korken89/kicad_libs/pcb_templates/uwb_wb001/antenna.jpg

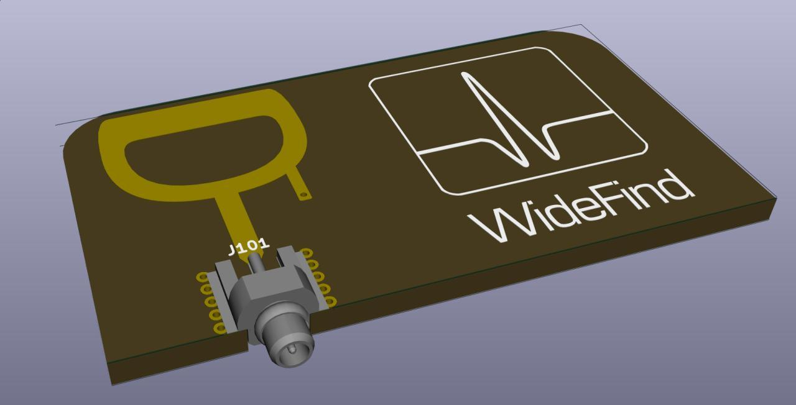
pcb_templates/uwb_wb001/antenna.jpg
