korken89/kicad_libs/pcb_templates/uwb_wb001/doc/Tag_antenna_WB001_v01.pdf

DecaWave Spline based Co-Planar Monopole Antenna

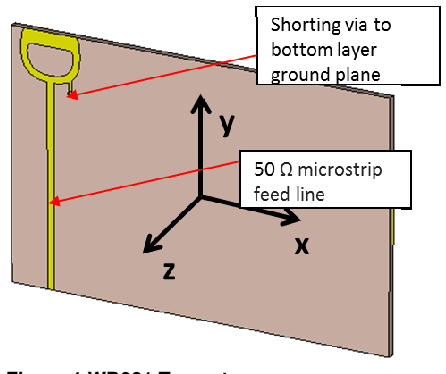
[picture p2: figure]

Confidential | 7th November 2014

## 1 Scope

This document details the performance, construction WB001 tag antenna. The document
information required to integrate this antenna into

## 2 General

The WB001 tag antenna is designed to be integrated specifically to work with DecaWave’s DW10 efficiency compact solution with good efficiency, f orientation. When implemented correctly is should m

Operational Frequ

Maximum Gain: 4dBi at 4GHz 3.7dBi at 6.5 GHz

Radiation Pattern:

## 3 Build Details

The WB001 antenna is designed to be printed on 1.6m
The following files are provided to assist with the integrating this antenna int
File Name | File Type | Description
TAG_Decawave_WB001_top_layer.grb | Gerber | Top layer copper
TAG_Decawave_WB001_btm_layer.grb | Gerber | Bottom layer copper
TAG_Decawave_WB001_top_layer.dxf | DXF | Top layer copper
TAG_Decawave_WB001_btm_layer.dxf | DXF | Bottom layer copper

Either gerber or DXF files can be used.
A shorting via is to be inserted where the circle i
can be trimmed up to the edge of the ground plane. It should be noted that the gro part of the antenna. The more ground plane the bett
between performance and ground plane size and spaci

It is recommended that the PCB manufacturer uses im
line and hence the rest of the antenna design is wi

Figure 1 WB001 Tag antenna

Planar Monopole Antenna

details and design trade-offs for DecaWave’s and its associated gerber/DXF files are intended to provide all the a DW1000 based tag product.

onto a DW1000 based tag design. It is designed

### 00 UWB transceiver providing a low or zero cost, hi

idelity and low group delay variation with antenna eet the following basic goals:

ency Range: 3.5 GHz to 7 GHz

4dBi at 4GHz
3.7dBi at 6.5 GHz

Omni-directional

m FR4 PCB substrate.
ded to assist with the integrating this antenna into your PCB layout:

s located in the layout files. The 50 Ω feeding strip f the ground plane. It should be noted that the ground plane forms er the performance. Section 5 shows the trade ng.

pedance control to ensure that the 50 thin a ±5% tolerance.

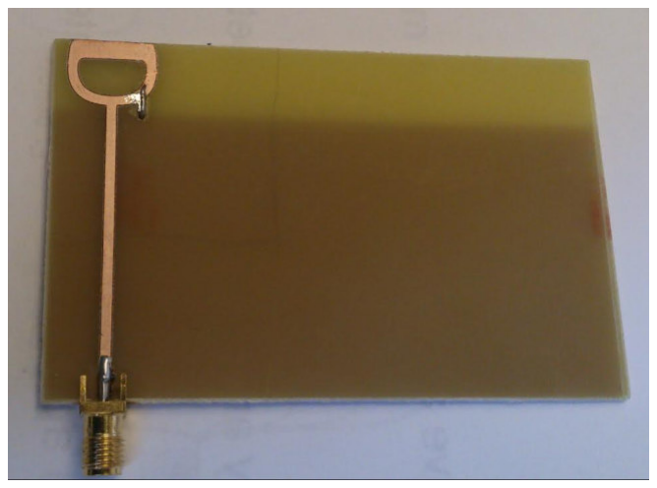
[picture p3: figure]

Page: 1 of 23

gh

Ω feeding strip
und plane forms
shows the trade-off

Ω feed

## 4 Simulation Results

## 4.1 Radiation patterns

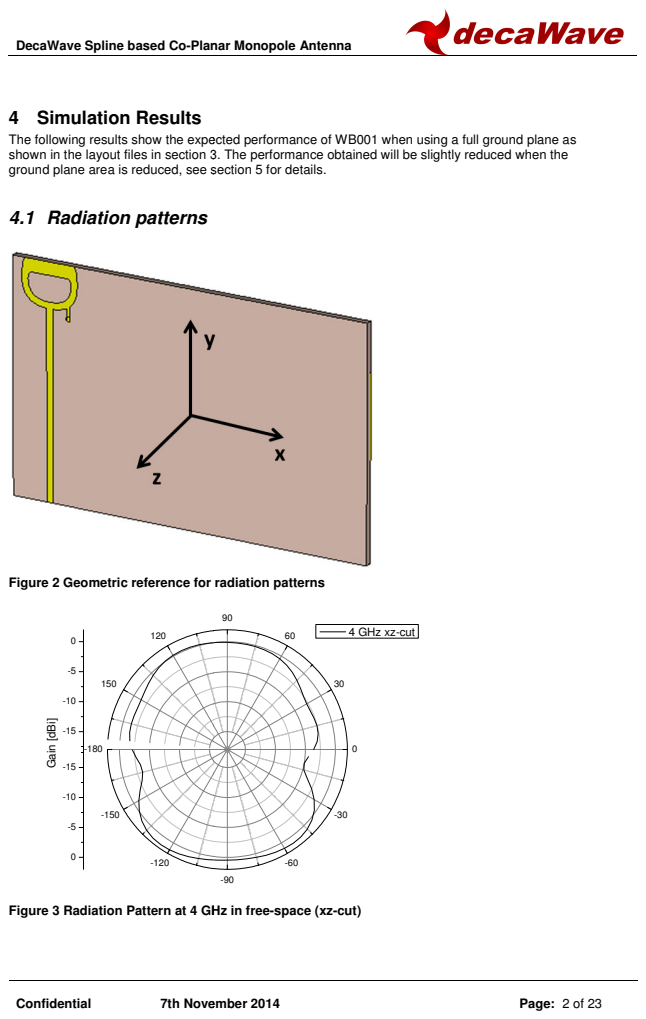
[picture p4: page 2]
Confidential; 7th November 2014; Gain [dBi]; 5 for details.; adiation patterns; Page: 2 of 23; when the

Planar Monopole Antenna

The following results show the expected performance
shown in the layout files in section 3
ground plane area is reduced, see section

of WB001 when using a full ground plane as

. The performance obtained will be slightly reduced

Figure 2 Geometric reference for r

4 GHz xz-cut

Figure 3 Radiation Pattern at 4 GHz in free

-space (xz-cut)

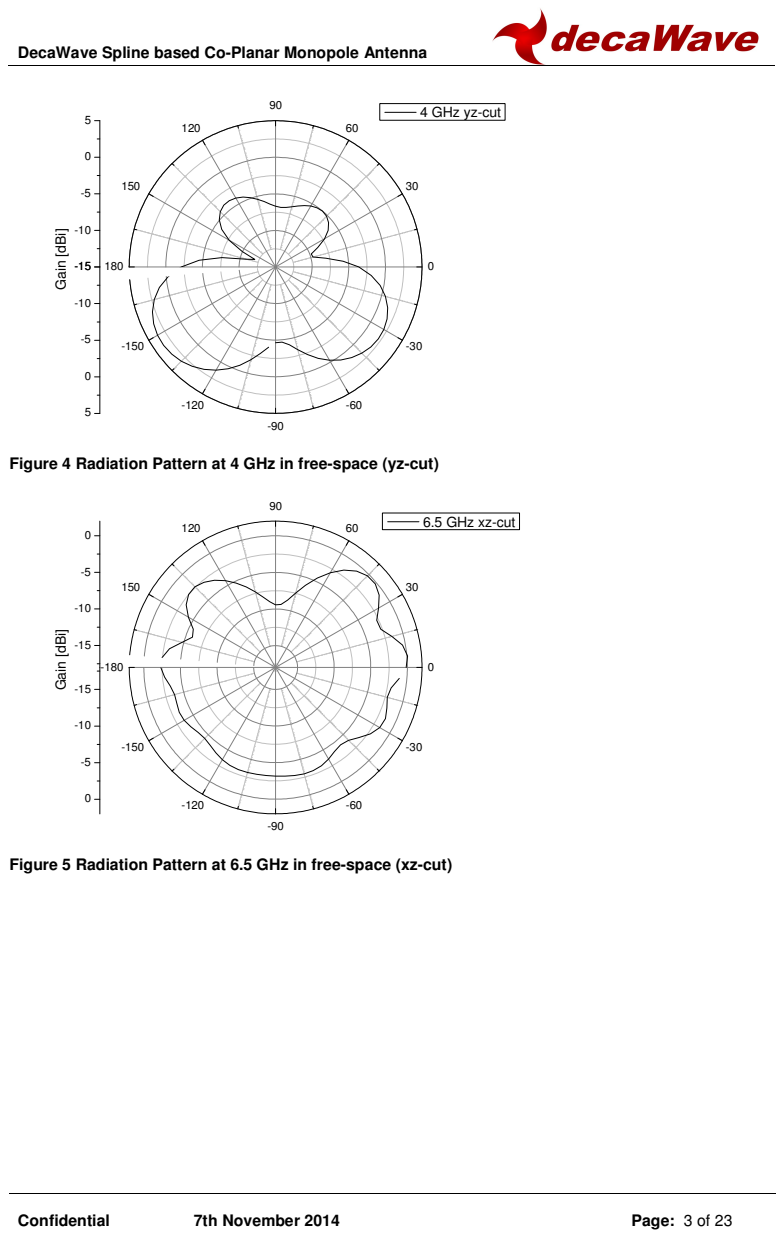
[picture p5: page 3]
Confidential; 7th November 2014; Page: 3 of 23; Gain [dBi]

4 GHz yz-cut

Figure 4 Radiation Pattern at 4 GHz in free-space (yz-cut)

6.5 GHz xz-cut

Figure 5 Radiation Pattern at 6.5 GHz in free-space (xz-cut)

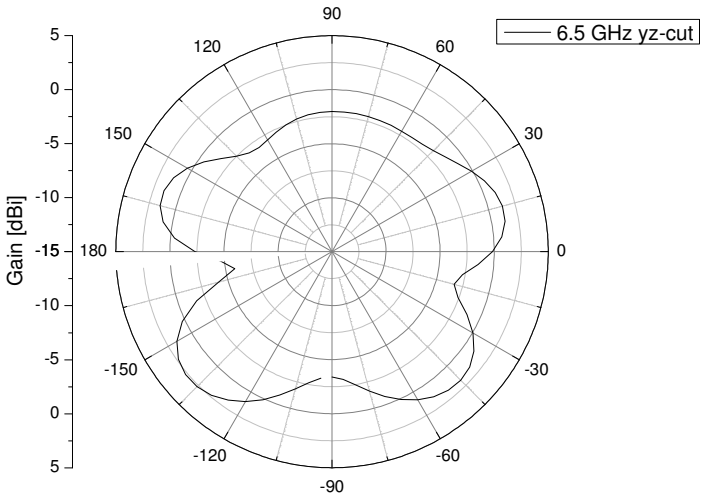
[picture p6: figure]
Gain [dBi]; 6.5 GHz yz-cut
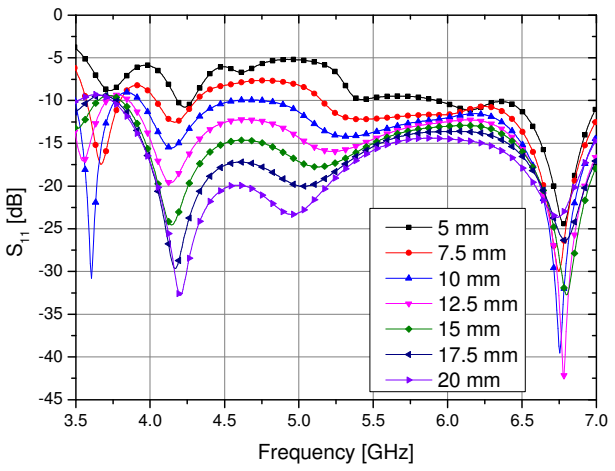
[picture p7: figure]
Frequency [GHz]

Confidential | 7th November 2014 | Page: 4 of 23

Figure 6 Radiation Pattern at 6.5 GHz in free-space (yz-cut)

## 4.2 Impedance Matching

The following plot shows simulated WB001 return loss in proximity to a metal plate. The purpose is this is to show how the return loss and hence general performance degrades when objects (metal plate, body etc) are placed close to the antenna. These results show that generally the WB001 antenna has a good immunity to objects in close proximity but as a rule the antenna should be as far away from tag housings etc as possible.

Figure 7 Impedance matching for different distances from a metal plate (Proximity test)

## 4.3 Efficiency

The following plot shows simulated WB001 efficiency in proximity to a metal plate

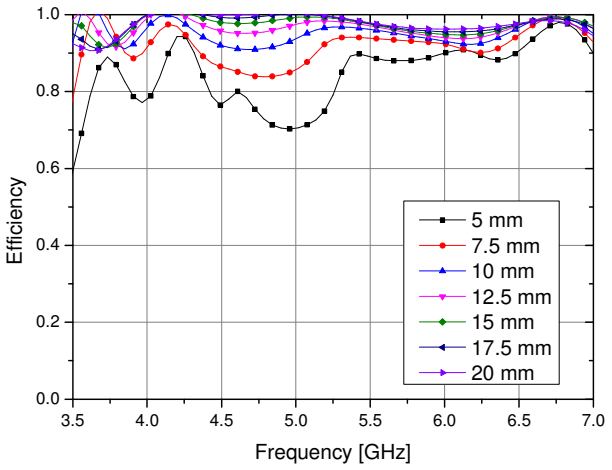
[picture p8: figure]
Efficiency; Frequency [GHz]

Confidential | 7th November 2014 | Page: 5 of 23

Figure 8 Efficiency for different distances from a metallic plate (Proximity test)

## 4.4 Maximum Gain

3.5 | 4.0 | 4.5 | 5.0 | 5.5 | 6.0 | 6.5 | 7.0

-15.0

-12.5

-10.0

-7.5

-5.0

-2.5

0.0

2.5

5.0

Maximum gain [dBi]

Frequency [GHz]

Figure 9 Maximum Gain across frequency

## 4.5 Group Delay Variation

Group delay variation is an important parameter to consider for antennas to be used in location solutions using IR-UWB such as DW1000. Here we mean how the group delay of the antenna changes as the antenna is rotated. 1ns of variation would represent 30cm variation is the reported distance, so we aim for a group delay variation with antenna rotation of <100ps.

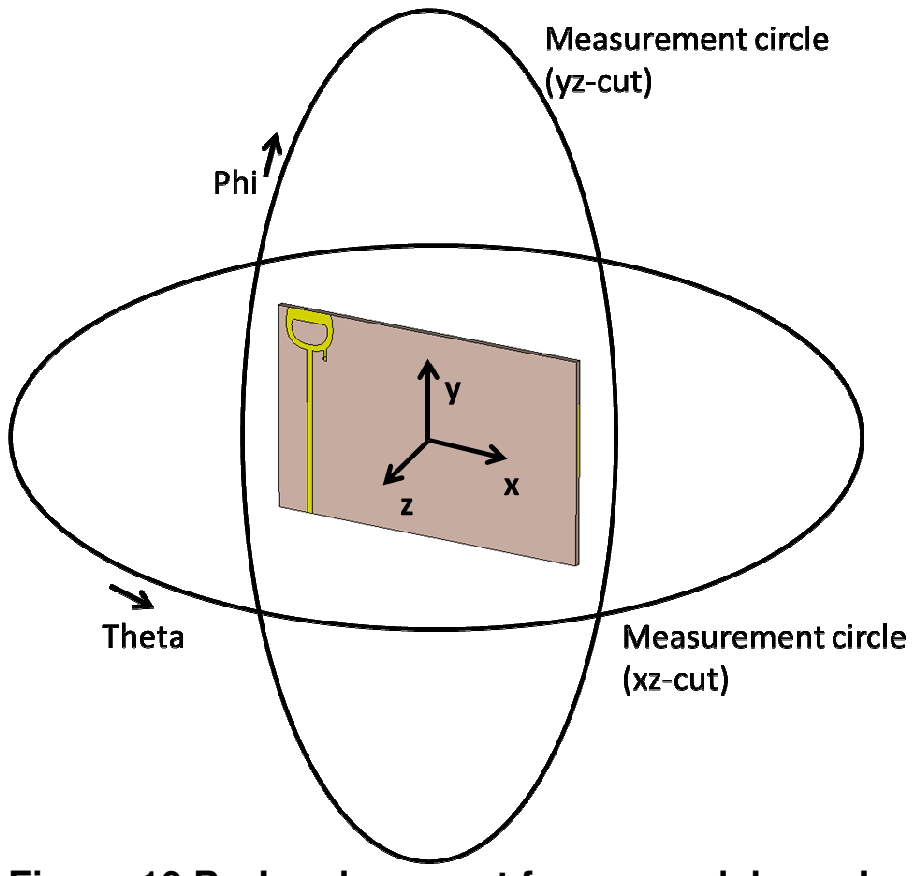
[picture p9: figure]
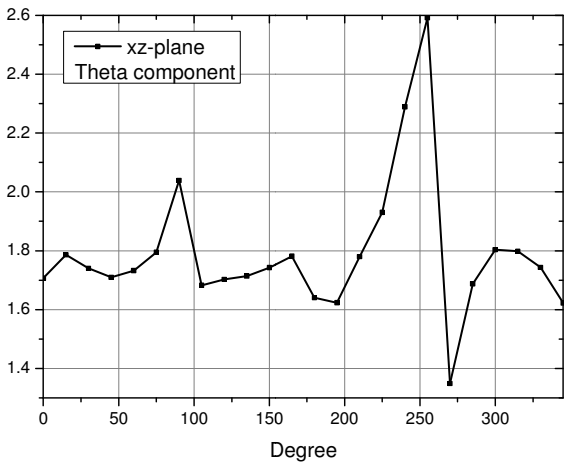
[picture p10: figure]
Degree; xz-plane Theta component

Confidential | 7th November 2014

Figure 10 Probe placement for group delay calculation

Ideal probes placed on the xz- and yz

### 4.5.1 Group Delay Variation at 4GHz

Group delay at 4 GHz [ns]

Planar Monopole Antenna

for group delay calculation

-plane at the distance of 5λ from the centre of the antenna

Page: 6 of 23

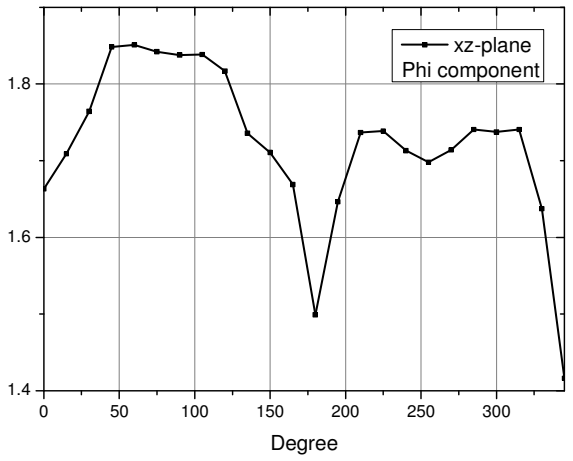
[picture p11: figure]
Degree; xz-plane Phi component
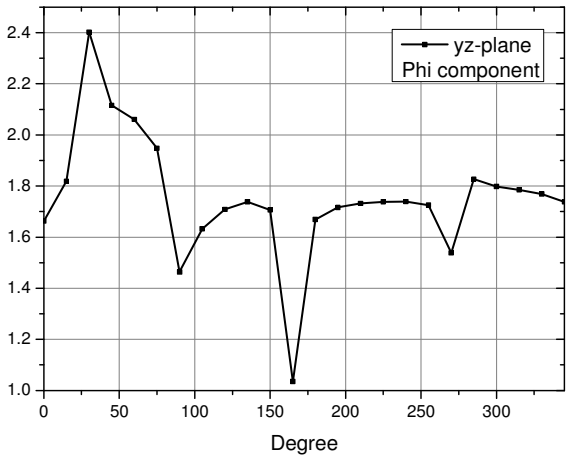
[picture p12: figure]
Degree; yz-plane Phi component
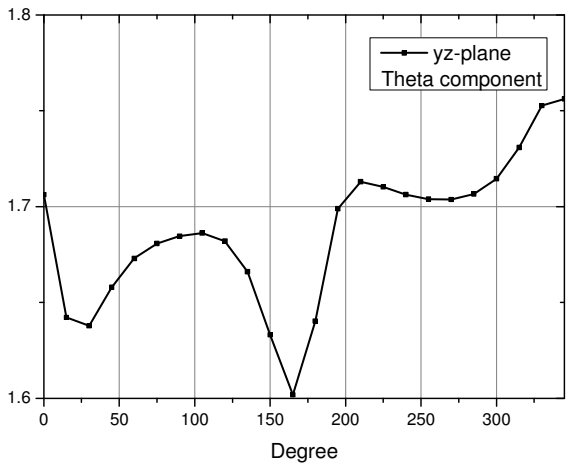
[picture p13: figure]
Degree; yz-plane Theta component

Confidential | 7th November 2014 | Page: 7 of 23

Group delay at 4 GHz [ns]

Group delay at 4 GHz [ns]

Group delay at 4 GHz [ns]

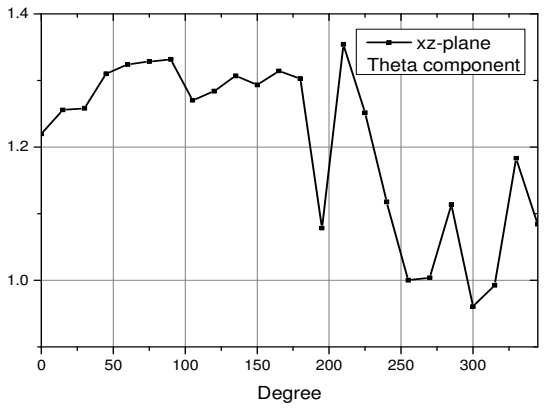
[picture p14: figure]
Degree; xz-plane Theta component
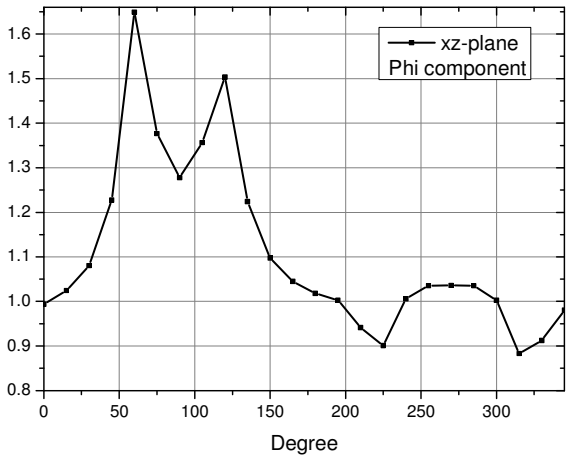
[picture p15: figure]
Degree; xz-plane Phi component
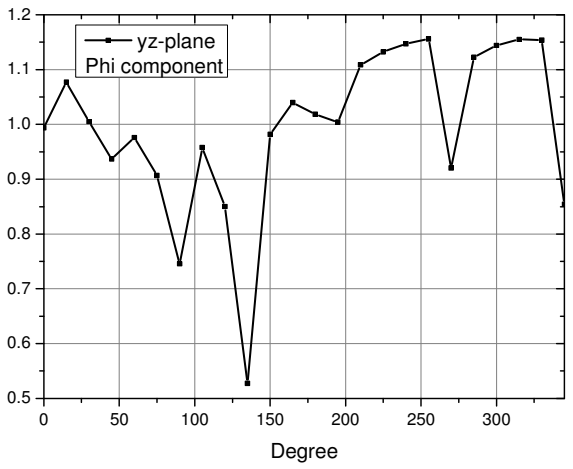
[picture p16: figure]
Degree; yz-plane Phi component

Confidential | 7th November 2014 | Page: 8 of 23

### 4.5.2 Group Delay Variation 6.5 GHz

Group delay at 6.5 GHz [ns]

Group delay at 6.5 GHz [ns]

Group delay at 6.5 GHz [ns]

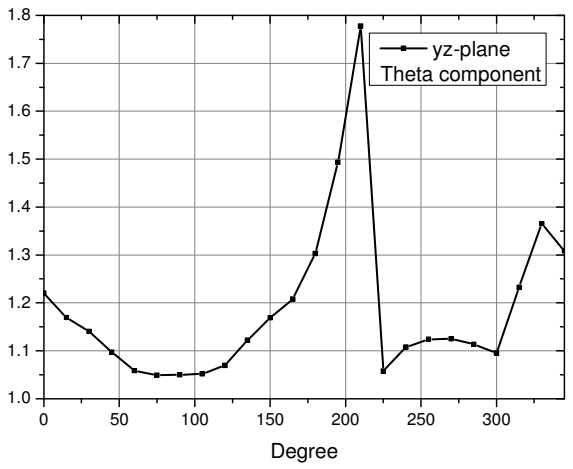
[picture p17: figure]
Degree; yz-plane; Theta component

Confidential | 7th November 2014 | Page: 9 of 23

Group delay at 6.5 GHz [ns]

## 4.6 Fidelity Factor

The following plots show simulated results of the fidelity factor for WB001. They show how well the antenna will perform in the time domain given it is to be used in an IR-UWB system. A figure of 1 is ideal with 0.9 being the target.

### 4.6.1 Fidelity factor 4 GHz

0 | 30 | 60 | 90 | 120 150 180 210 240 270 300 330

0.80

0.85

0.90

0.95

1.00

Fidelity

Angle [degree]

xz-plane
Theta component

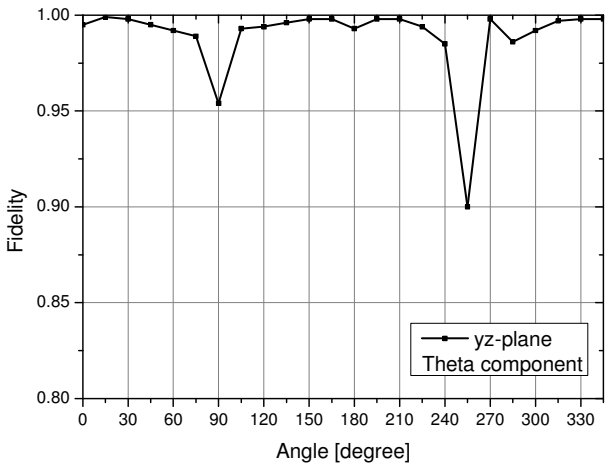
[picture p18: figure]
Fidelity; Angle [degree]; yz-plane Theta component

Confidential | 7th November 2014 | Page: 10 of 23
0 | 30 | 60 | 90 | 120 150 180 210 240 270 300 330

0.80

0.85

0.90

0.95

1.00

Fidelity

Angle [degree]

xz-plane
Phi component
0 | 30 | 60 | 90 | 120 150 180 210 240 270 300 330
0 | 30 | 60 | 90 | 120 150 180 210 240 270 300 330

0.80

0.85

0.90

0.95

1.00

Fidelity

Angle [degree]

yz-plane
Phi component

Confidential | 7th November 2014 | Page: 11 of 23

### 4.6.2 Fidelity factor 6.5 GHz

0 | 30 | 60 | 90 | 120 150 180 210 240 270 300 330

0.80

0.85

0.90

0.95

1.00

Fidelity

Angle [degree]

xz-plane
Theta component
0 | 30 | 60 | 90 | 120 150 180 210 240 270 300 330

0.80

0.85

0.90

0.95

1.00

Fidelity

Angle [degree]

xz-plane
Phi component

Confidential | 7th November 2014 | Page: 12 of 23
0 | 30 | 60 | 90 | 120 150 180 210 240 270 300 330

0.80

0.85

0.90

0.95

1.00

Fidelity

Angle [degree]

yz-plane
Theta component
0 | 30 | 60 | 90 | 120 150 180 210 240 270 300 330

0.80

0.85

0.90

0.95

1.00

Fidelity

Angle [degree]

yz-plane
Phi component

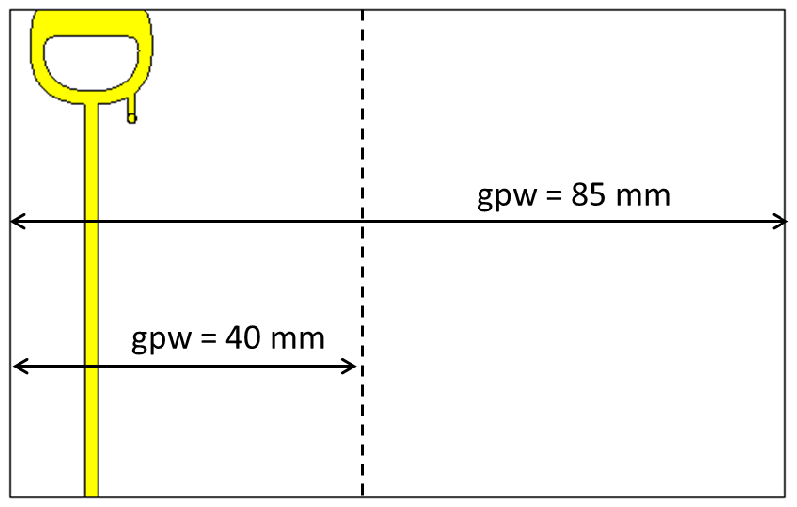
[picture p19: figure]
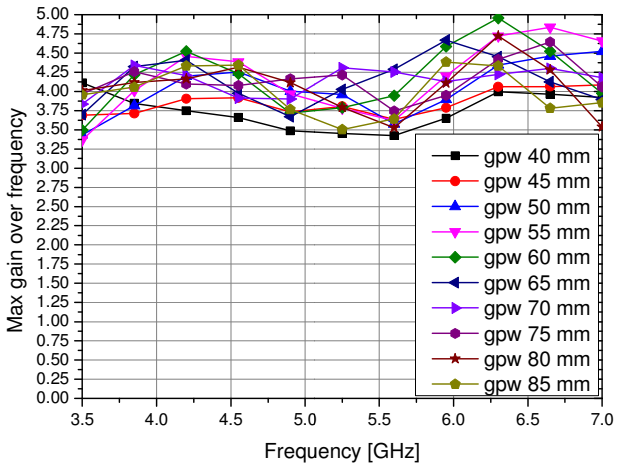
[picture p20: figure]
Max gain over frequency; Frequency [GHz]; gpw 40 mm gpw 45 mm gpw 50 mm gpw 55 mm gpw 60 mm gpw 65 mm gpw 70 mm gpw 75 mm gpw 80 mm gpw 85 mm

Confidential | 7th November 2014

## 5 Performance using less ground plane

In most DW1000 based tag designs, tags are designed
plane for WB001 forms part of the antenna the large
This section details how small the tag can be with regard to how much PCB layout should use as much copper ground fill as

## 5.1 Reducing the Ground Plane Width

In the following plots, the ground plane width given in t effects on antenna gain are plotted.

## 5.2 Reducing the Ground Plane Height

In the following plots the ground plane height give
effects on antenna gain is plotted.

Planar Monopole Antenna

to be as small as possible. As the ground r the ground-plane the better the performance. the tag can be with regard to how much ground plane is required. possible to increase ground plane area.

he supplied gerber/dxf files is reduced and the

n in the supplied gerber/dxf files is reduced and t

Page: 13 of 23

Tag

he

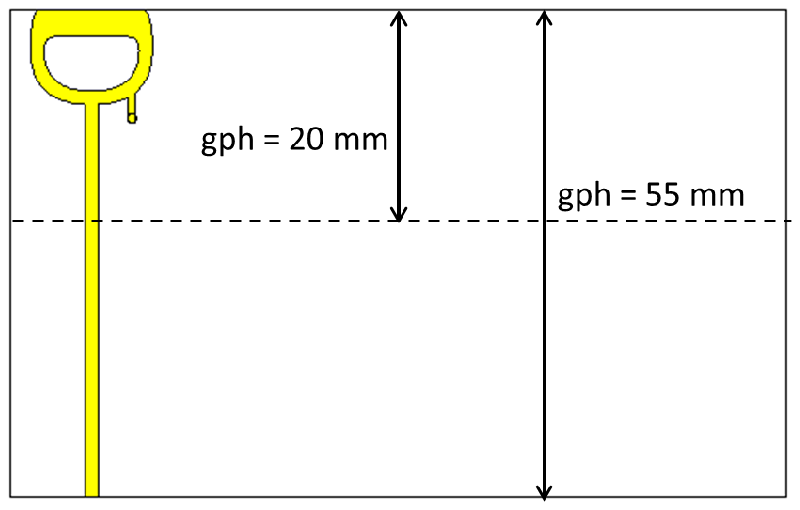
[picture p21: figure]
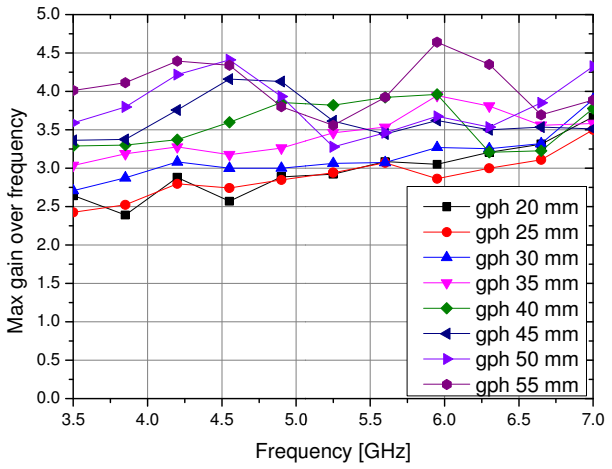
[picture p22: figure]
Max gain over frequency; Frequency [GHz]; gph 20 mm gph 25 mm gph 30 mm gph 35 mm; gph 40 mm gph 45 mm gph 50 mm; gph 55 mm
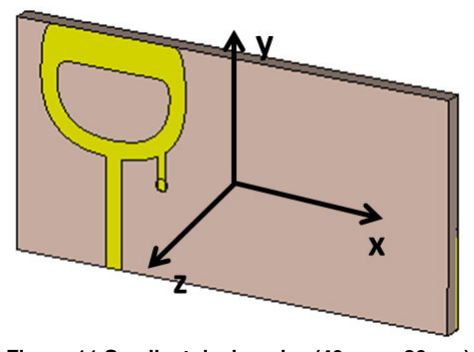
[picture p23: figure]

Confidential | 7th November 2014

## 5.3 Smallest Recommended Design

As stated already, for the best performance the gro practical in most tag designs. This section shows
the effects this reduced size has on antenna perfor

### 5.3.1 Smallest antenna design 40mm x 20mm

Figure 11 Smallest design size (40mm x 20mm)

In Figure 11, the smallest recommended tag size is shown in a

Planar Monopole Antenna

und plane should be large, however this is not This section shows the recommended smallest ground plane size and mance.

(40mm x 20mm)

40mm x-plane, 20mm y

Page: 14 of 23

-plane

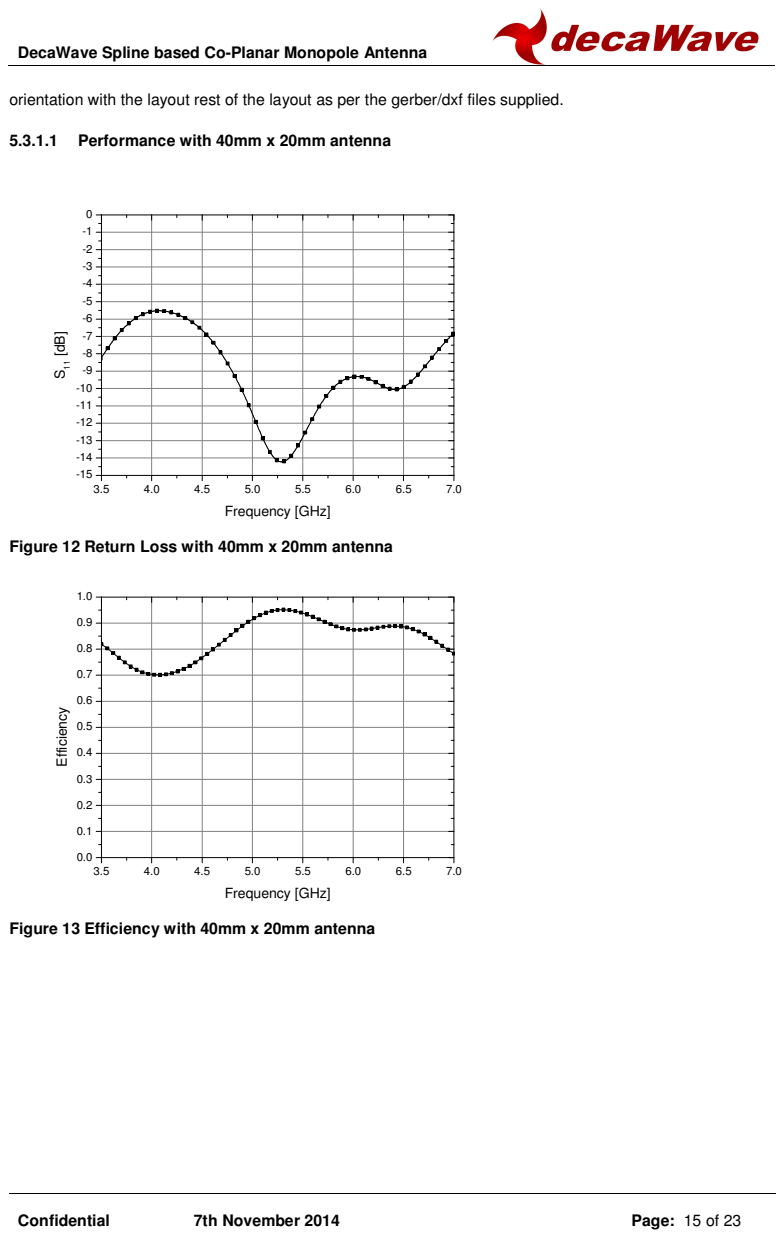
[picture p24: page 15]
Confidential; 7th November 2014; Page: 15 of 23; Frequency [GHz]; Efficiency

orientation with the layout rest of the layout as per the gerber/dxf files supplied.

5.3.1.1 Performance with 40mm x 20mm antenna

Figure 12 Return Loss with 40mm x 20mm antenna

Figure 13 Efficiency with 40mm x 20mm antenna

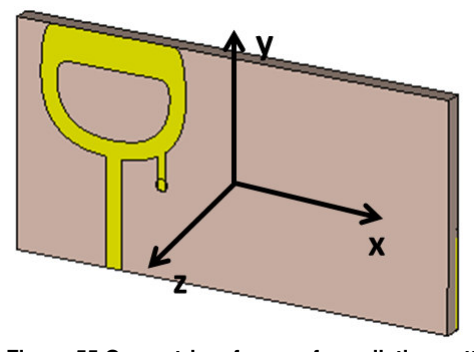
[picture p25: figure]

Confidential | 7th November 2014
3.5 | 4.0 | 4.5 | 5.0

2.0

2.5

3.0

3.5

4.0

4.5

5.0

Max gain over frequency

Frequency [GHz]

Figure 44 Gain with 40mm x 20mm antenna

Figure 55 Geometric reference for radiation patterns

Planar Monopole Antenna

5.5 | 6.0 | 6.5 | 7.0
Frequency [GHz]

with 40mm x 20mm antenna

Page: 16 of 23

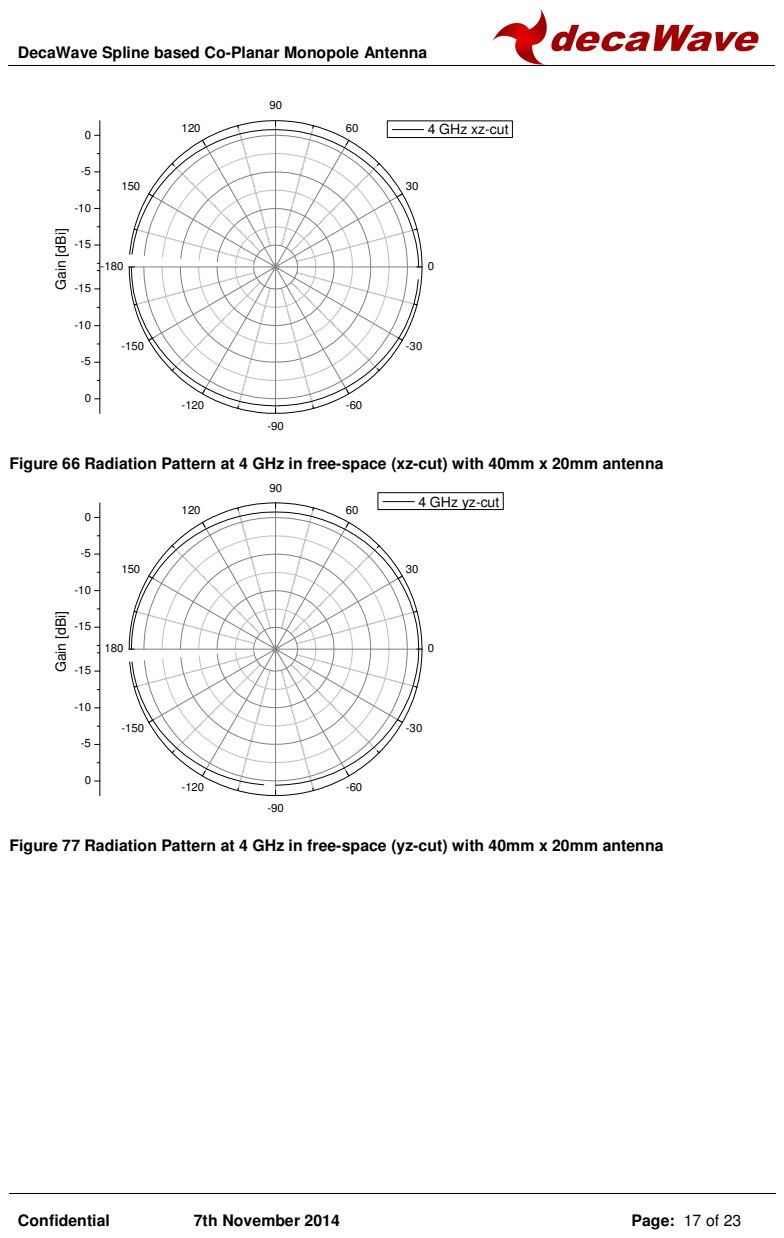
[picture p26: page 17]
Confidential; 7th November 2014; Page: 17 of 23; Gain [dBi]

4 GHz xz-cut

Figure 66 Radiation Pattern at 4 GHz in free-space (xz-cut) with 40mm x 20mm antenna

4 GHz yz-cut

Figure 77 Radiation Pattern at 4 GHz in free-space (yz-cut) with 40mm x 20mm antenna

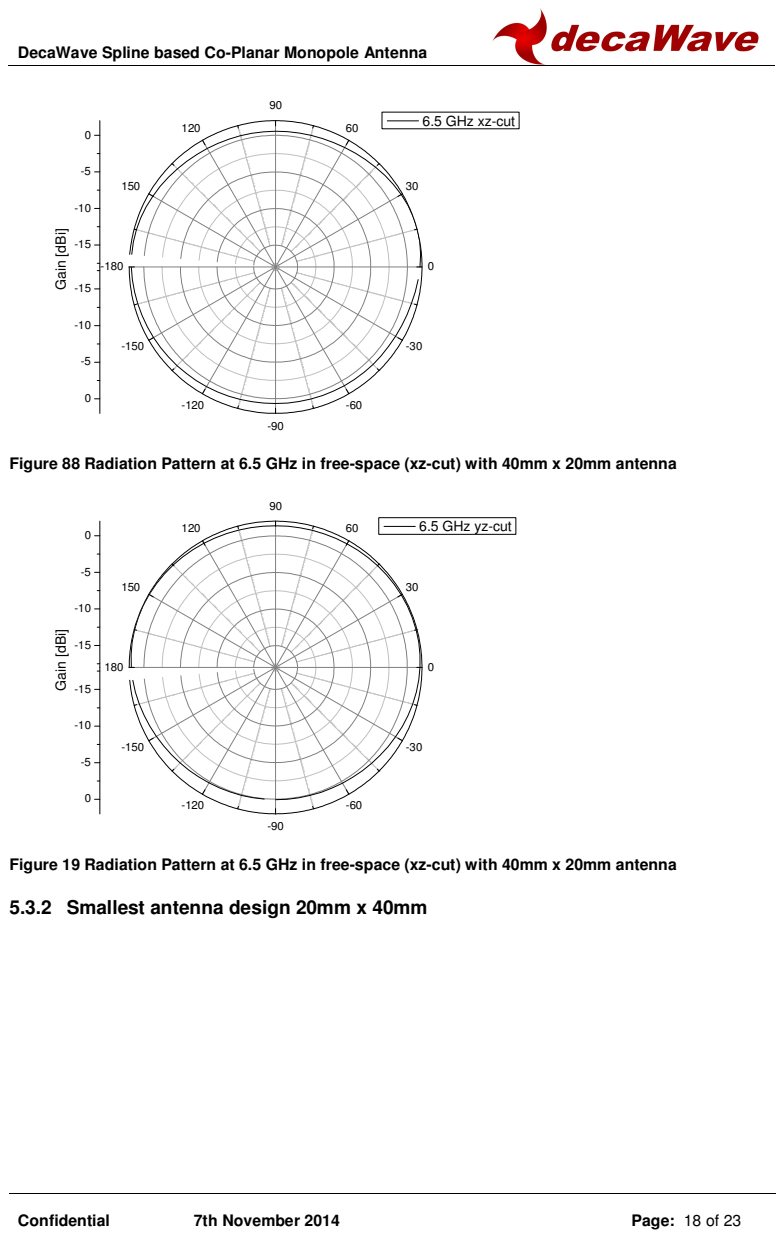
[picture p27: page 18]
Confidential; 7th November 2014; Page: 18 of 23; Gain [dBi]

6.5 GHz xz-cut

Figure 88 Radiation Pattern at 6.5 GHz in free-space (xz-cut) with 40mm x 20mm antenna

6.5 GHz yz-cut

Figure 19 Radiation Pattern at 6.5 GHz in free-space (xz-cut) with 40mm x 20mm antenna

5.3.2 Smallest antenna design 20mm x 40mm

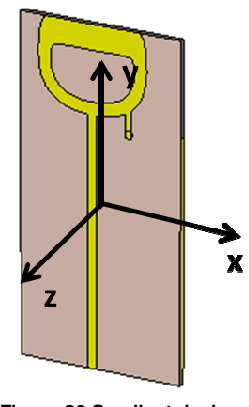
[picture p28: figure]

Confidential | 7th November 2014

Figure 20 Smallest design size 20mm x 40mm

In Figure , the smallest recommended tag size is shown in a orientation with the layout rest of the layout as p

### 5.3.2.1 Performance with 20mm x 40mm antenna

Figure 21 Return Loss with 20mm x 40mm antenna

Planar Monopole Antenna

20mm x-plane, 40mm y-plane er the gerber/dxf files supplied.

Page: 19 of 23

plane

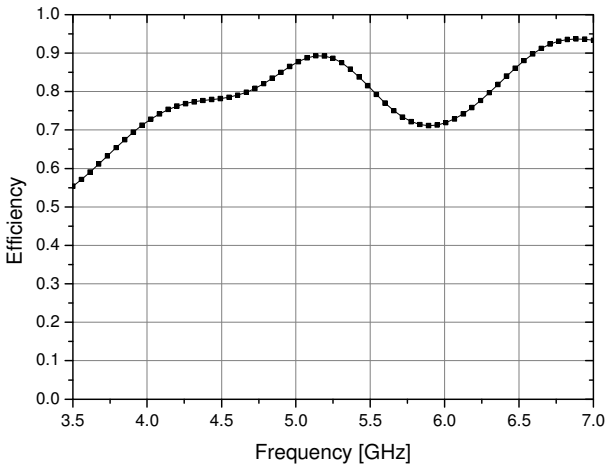
[picture p29: figure]
Efficiency; Frequency [GHz]

Confidential | 7th November 2014 | Page: 20 of 23

Figure 22 Efficiency with 20mm x 40mm

3.5 | 4.0 | 4.5 | 5.0 | 5.5 | 6.0 | 6.5 | 7.0

2.0

2.5

3.0

3.5

4.0

4.5

5.0

Max gain over gain

Frequency [GHz]

Figure 23 Gain with 20mm x 40mm antenna

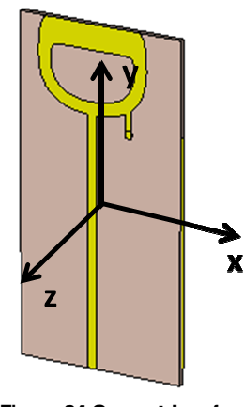
[picture p30: figure]

Confidential | 7th November 2014

Figure 24 Geometric reference for radiation patterns with 20m

Figure 25 Radiation Pattern at 4 GHz in free

Planar Monopole Antenna

m x 40mm antenna

-space (xz-cut) with 20mm x 40mm antenna

Page: 21 of 23

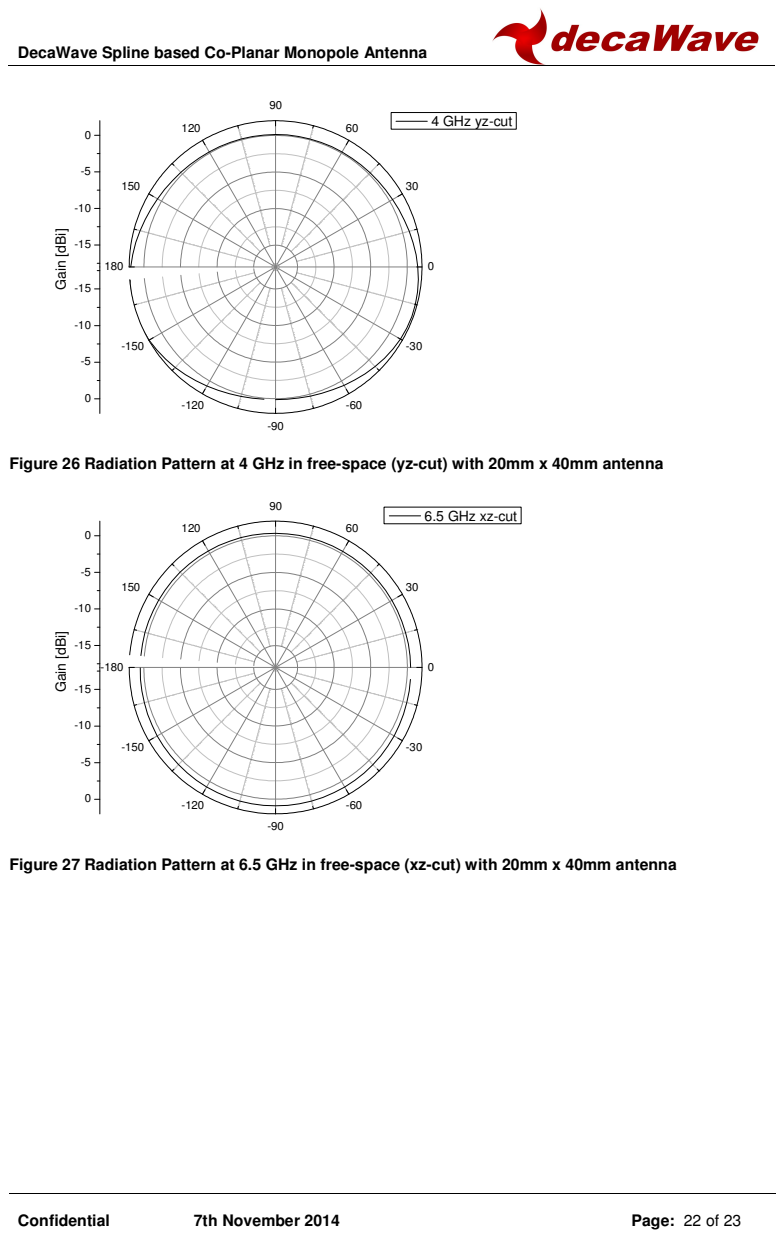
[picture p31: page 22]
Confidential; 7th November 2014; Page: 22 of 23; Gain [dBi]

4 GHz yz-cut

Figure 26 Radiation Pattern at 4 GHz in free-space (yz-cut) with 20mm x 40mm antenna

6.5 GHz xz-cut

Figure 27 Radiation Pattern at 6.5 GHz in free-space (xz-cut) with 20mm x 40mm antenna

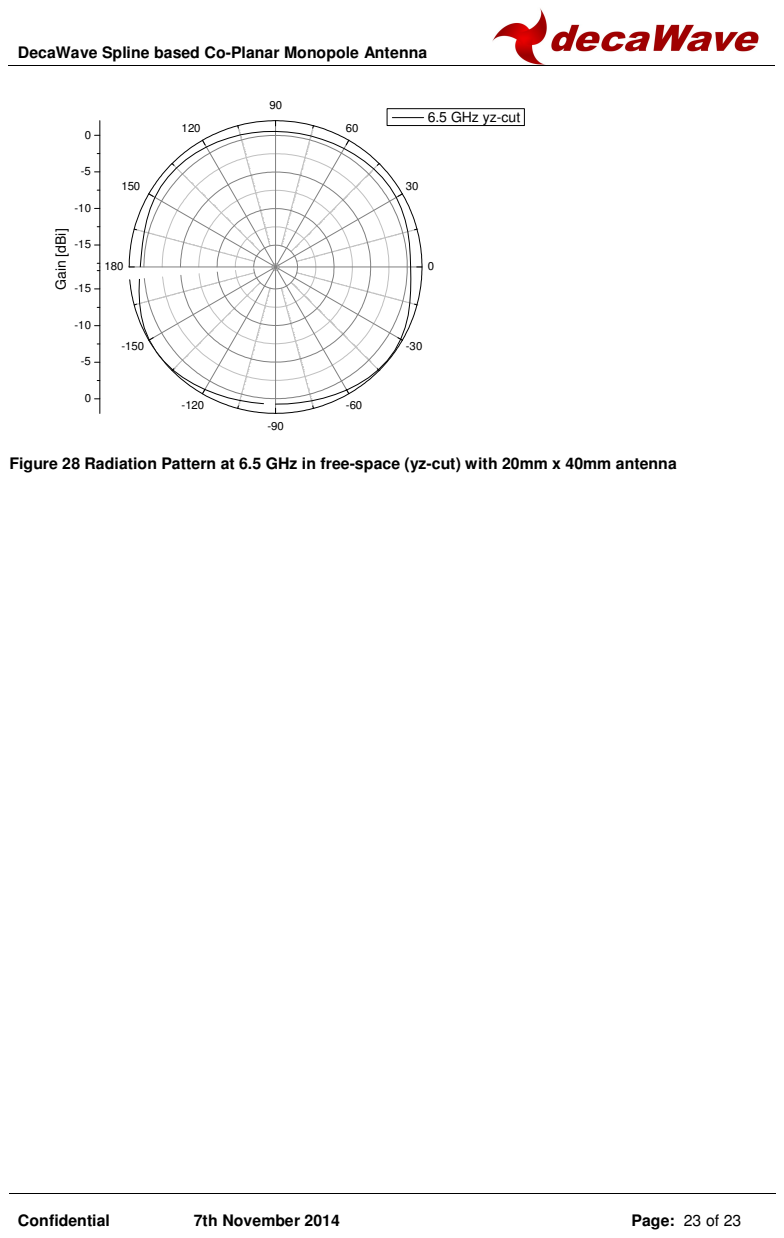
[picture p32: page 23]
Confidential; 7th November 2014; Page: 23 of 23; Gain [dBi]

6.5 GHz yz-cut

Figure 28 Radiation Pattern at 6.5 GHz in free-space (yz-cut) with 20mm x 40mm antenna
