korken89/kicad_libs/3dmodels/step/WE-STST-74930000.stp

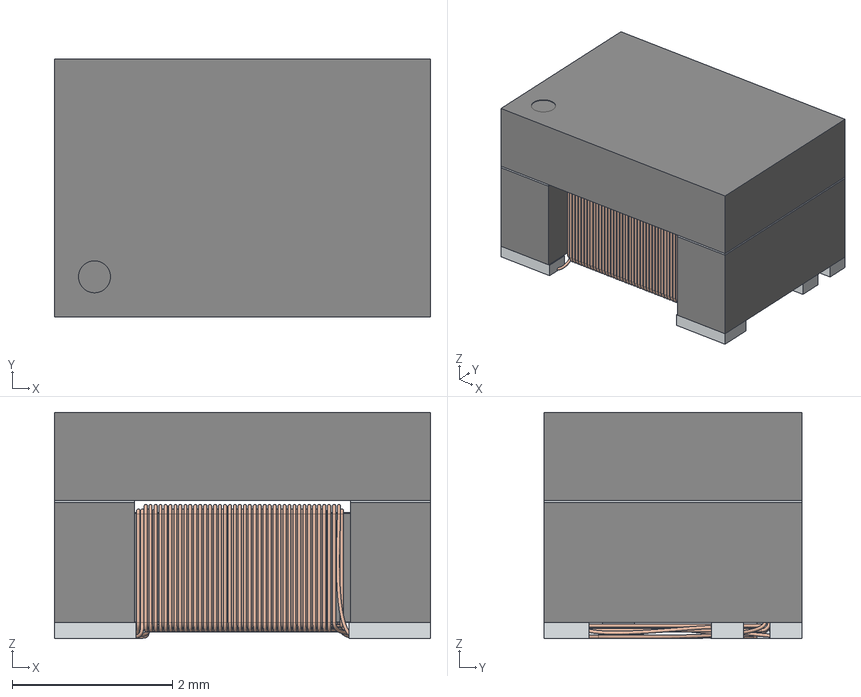
[picture p33: CAD file, 2024-05-06]
3dmodels/step/WE-STST-74930000.stp
4.70 x 3.22 x 2.83 mm
Core
Windings_02
Pins
Glue
Upper Plate
