korken89/kicad_libs/3dmodels/step/SOT-523.step

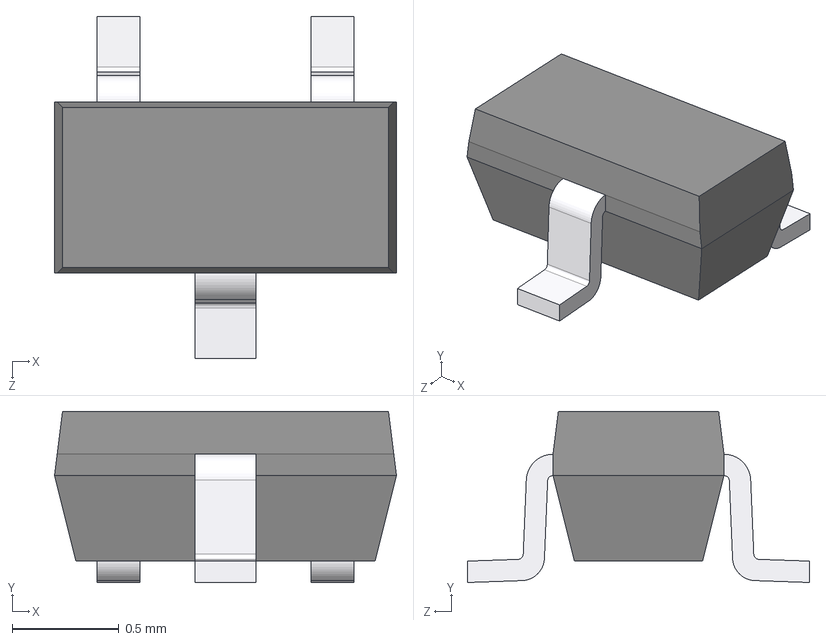
[picture p35: CAD file, 2024-03-24]
3dmodels/step/SOT-523.step
1.60 x 0.8 x 1.60 mm
