korken89/kicad_libs/pcb_templates/uwb_wb001/doc/TAG_DecaWave_WB001_btm_layer.dxf

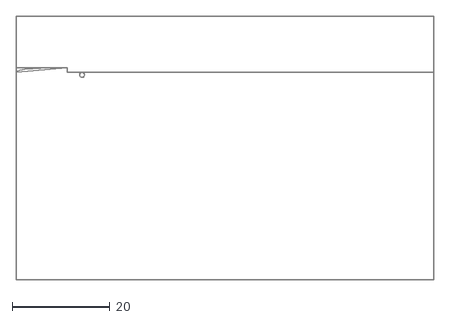
[picture p36: CAD file, 2018-04-15]
pcb_templates/uwb_wb001/doc/TAG_DecaWave_WB001_btm_layer.dxf
85.6 x 54.0
