korken89/kicad_libs/3dmodels/step/SOT-723.step

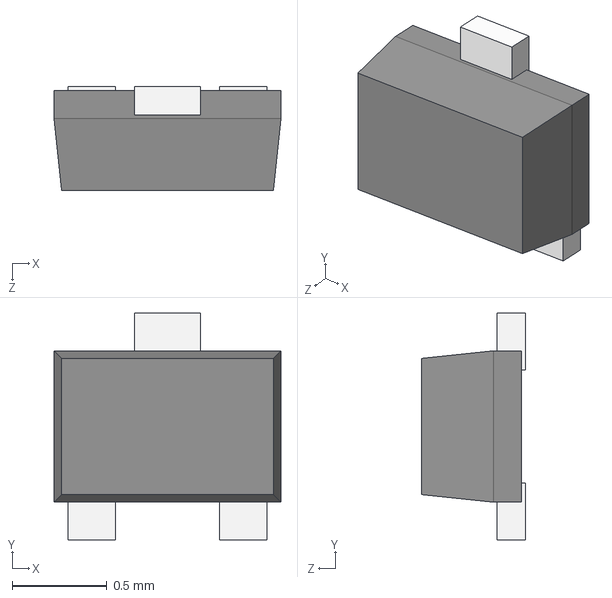
[picture p37: CAD file, 2024-03-24]
3dmodels/step/SOT-723.step
1.20 x 1.20 x 0.55 mm
