korken89/kicad_libs/3dmodels/step/mill-max-816-22-002-10-004101.STEP

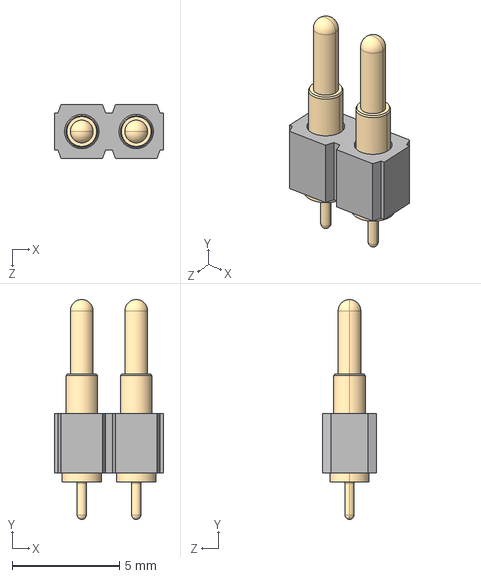
[picture p38: CAD file, 2024-03-21]
3dmodels/step/mill-max-816-22-002-10-004101.STEP
5.08 x 10.3 x 2.54 mm
P3XX-18-010-00-090000_P302-18-010-00-090000
0908_default x 2
