korken89/kicad_libs/3dmodels/step/BM03B-ACHSS-GAN-TF.step

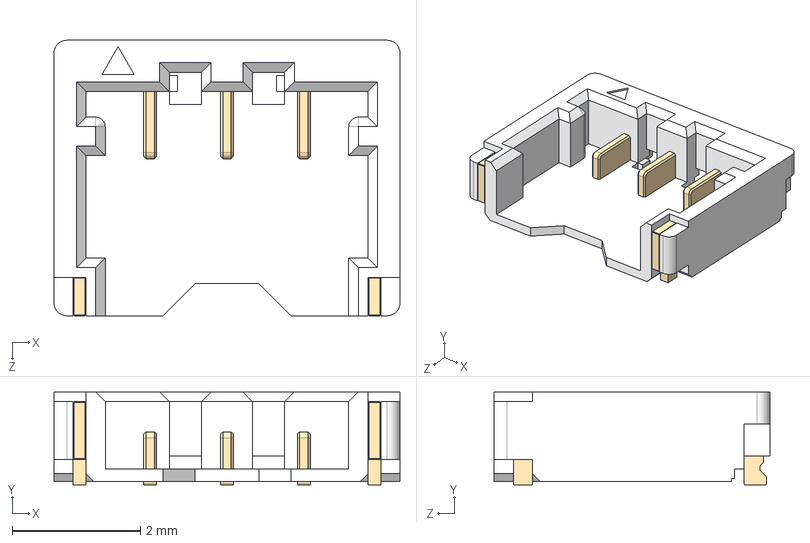
[picture p39: CAD file, 2024-03-14]
3dmodels/step/BM03B-ACHSS-GAN-TF.step
5.40 x 1.45 x 4.30 mm
