korken89/kicad_libs/3dmodels/step/mill-max-0908-8-15-20-75-14-11-0.step

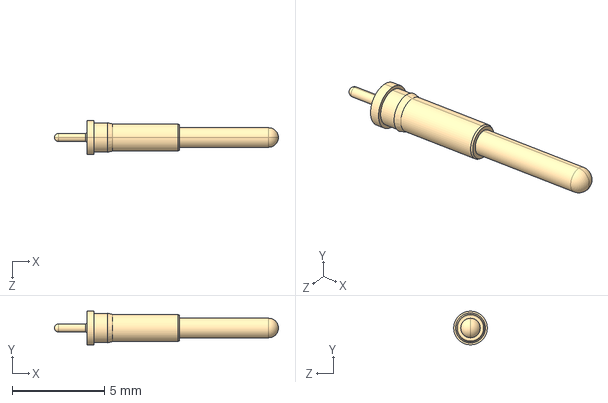
[picture p40: CAD file, 2024-03-14]
3dmodels/step/mill-max-0908-8-15-20-75-14-11-0.step
12.2 x 1.83 x 1.83 mm
