korken89/kicad_libs/3dmodels/step/ESD8708MUTAG.stp

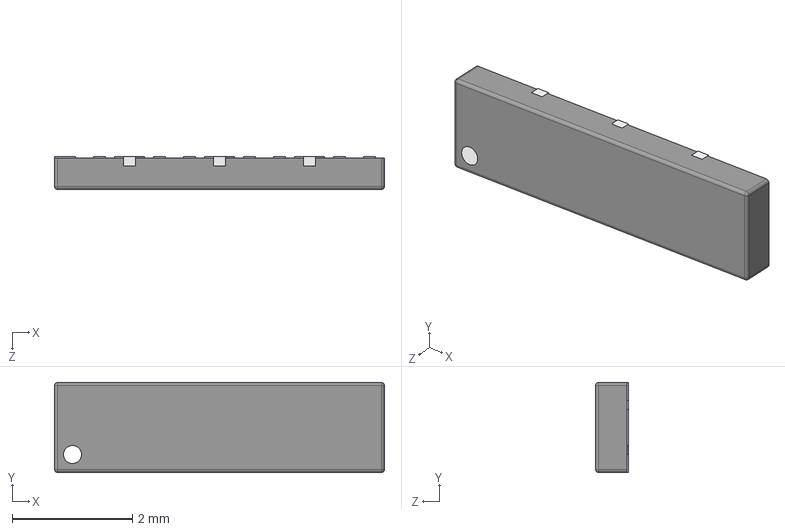
[picture p41: CAD file, 2024-02-21]
3dmodels/step/ESD8708MUTAG.stp
5.50 x 1.50 x 0.55 mm
