korken89/kicad_libs/3dmodels/step/CD-HD2XL.stp

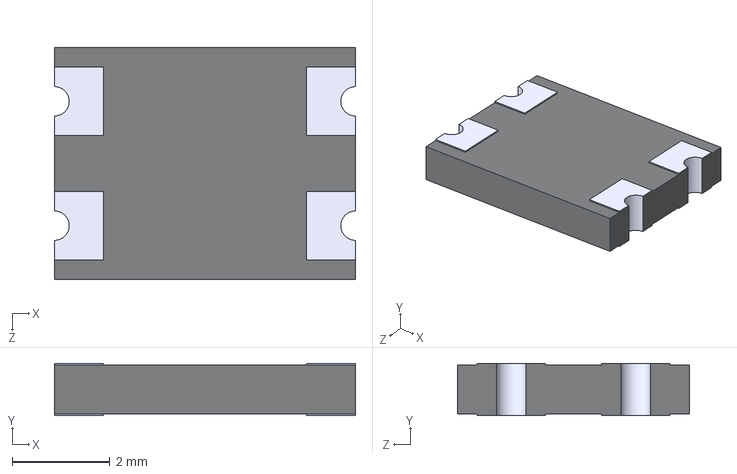
[picture p42: CAD file, 2024-01-06]
3dmodels/step/CD-HD2XL.stp
6.15 x 1.07 x 4.75 mm
