korken89/kicad_libs/3dmodels/step/SRF0703.step

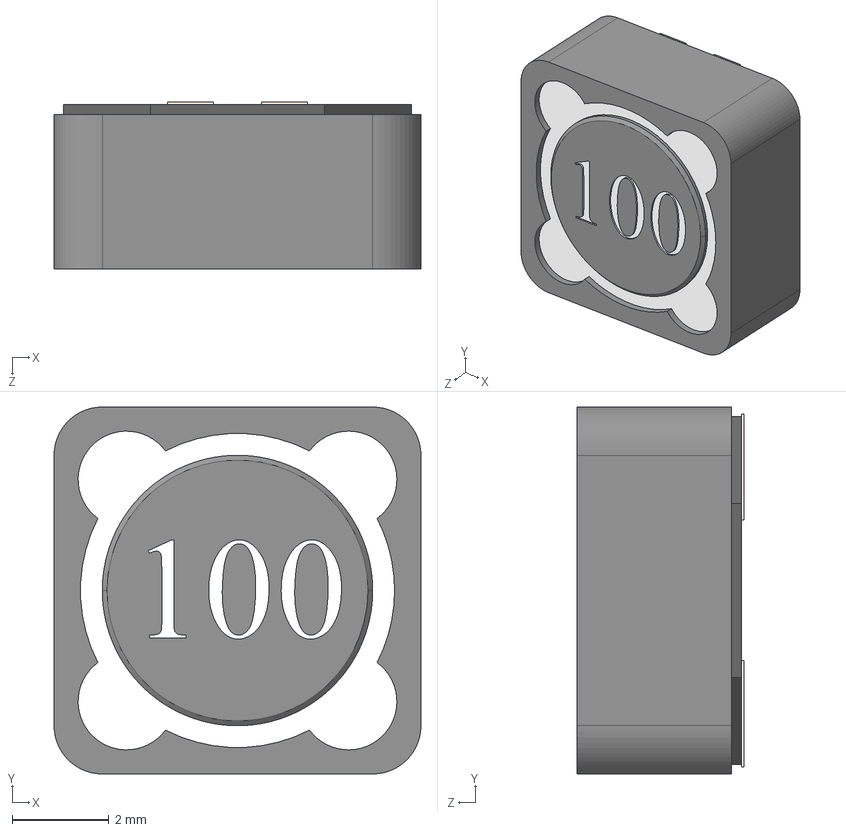
[picture p43: CAD file, 2023-12-17]
3dmodels/step/SRF0703.step
7.60 x 7.60 x 3.45 mm
