korken89/kicad_libs/3dmodels/step/AVX-00-9276-003-021-906.STEP

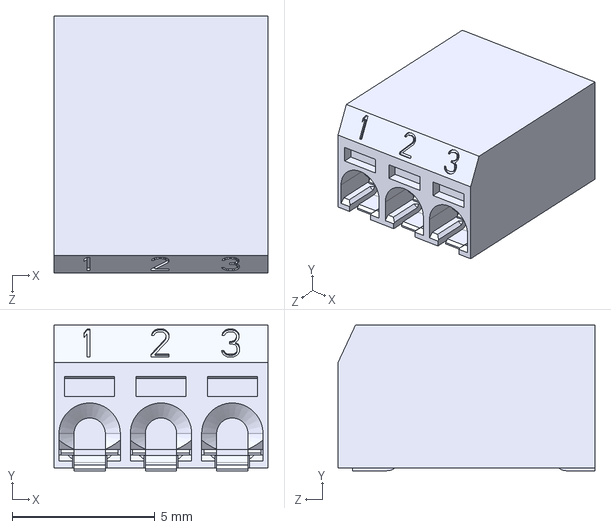
[picture p44: CAD file, 2023-12-14]
3dmodels/step/AVX-00-9276-003-021-906.STEP
7.50 x 5.10 x 9.00 mm
