korken89/kicad_libs/3dmodels/step/Z003 H3.3.stp

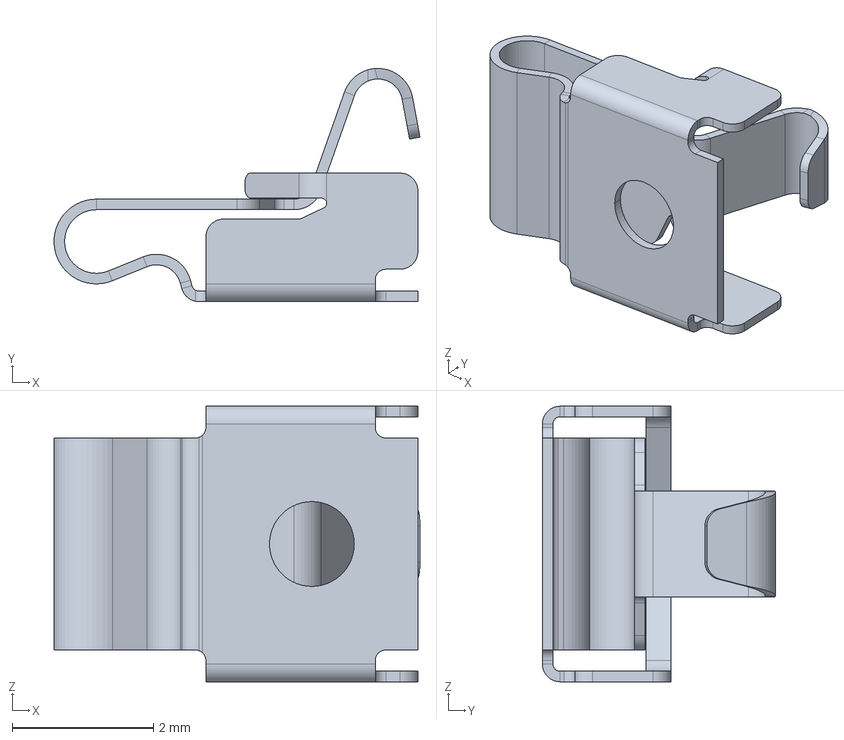
[picture p45: CAD file, 2023-09-17]
3dmodels/step/Z003 H3.3.stp
5.18 x 3.30 x 3.90 mm
