korken89/kicad_libs/3dmodels/step/RCP-5SPFFC-SCU7001-STP.stp

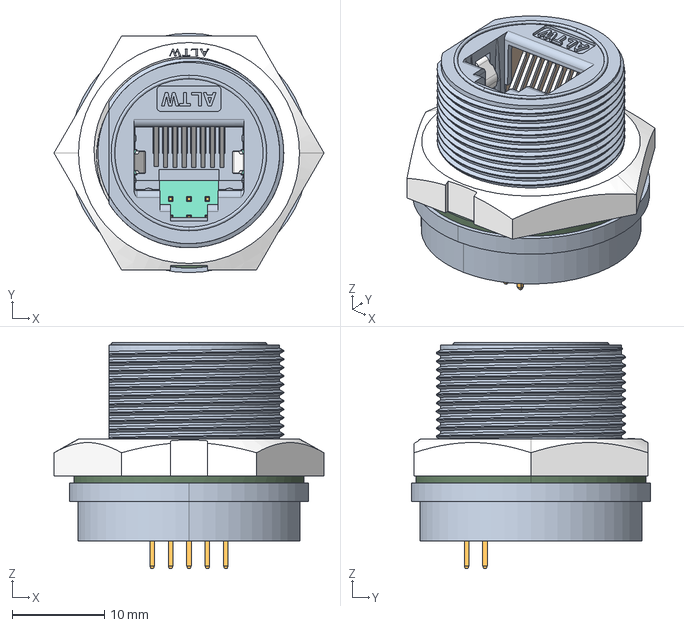
[picture p46: CAD file, 2023-09-09]
3dmodels/step/RCP-5SPFFC-SCU7001-STP.stp
29.3 x 26.0 x 24.6 mm
