korken89/kicad_libs/3dmodels/step/SRF2012A-801Y.stp

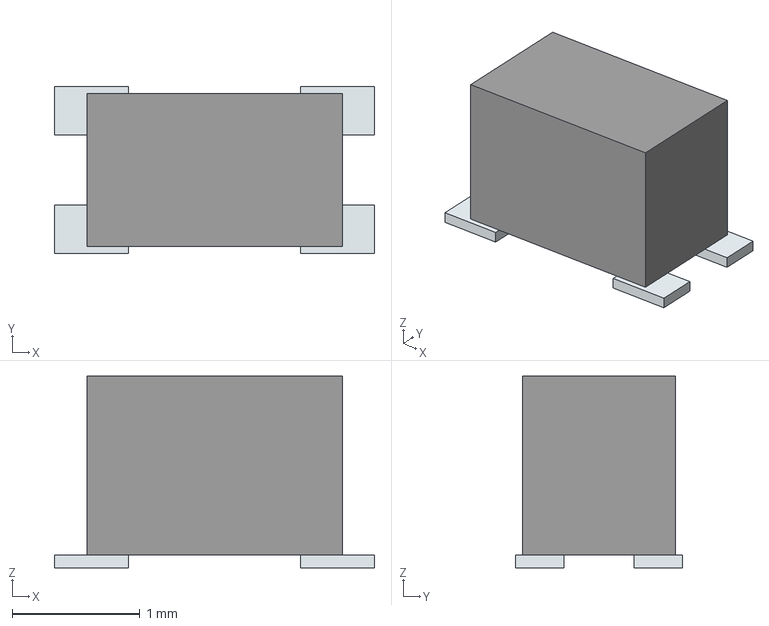
[picture p47: CAD file, 2023-09-09]
3dmodels/step/SRF2012A-801Y.stp
2.50 x 1.31 x 1.50 mm
Pins
