korken89/kicad_libs/3dmodels/step/M-MRJR-548X-0F-REVT2.STEP

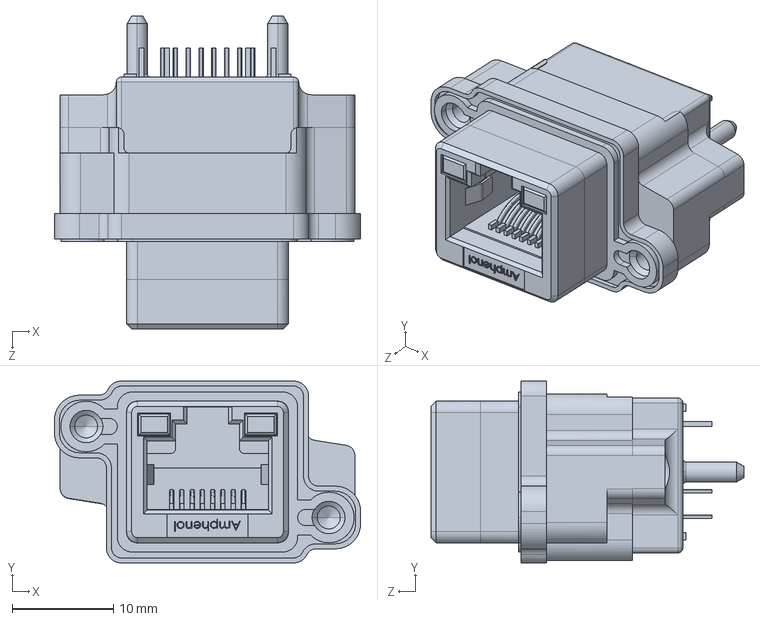
[picture p48: CAD file, 2023-09-09]
3dmodels/step/M-MRJR-548X-0F-REVT2.STEP
30.3 x 18.0 x 31.0 mm
