korken89/kicad_libs/3dmodels/step/XDFN4.step

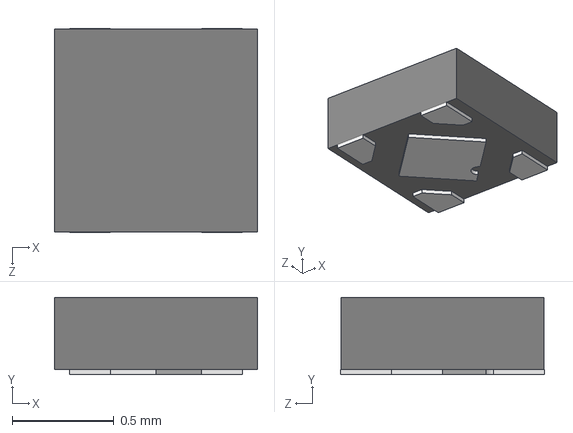
[picture p49: CAD file, 2023-09-02]
3dmodels/step/XDFN4.step
1.00 x 0.38 x 1.00 mm
