korken89/kicad_libs/3dmodels/step/SSSS810701.STEP

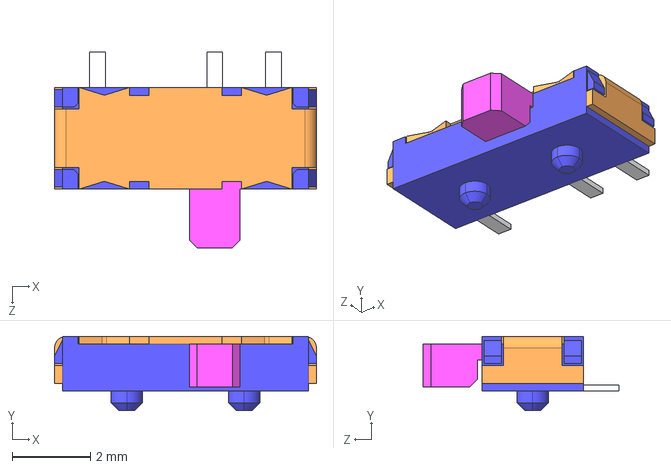
[picture p50: CAD file, 2023-08-20]
3dmodels/step/SSSS810701.STEP
6.70 x 1.90 x 5.00 mm
