korken89/kicad_libs/3dmodels/step/LS011B7DH03_bend.step

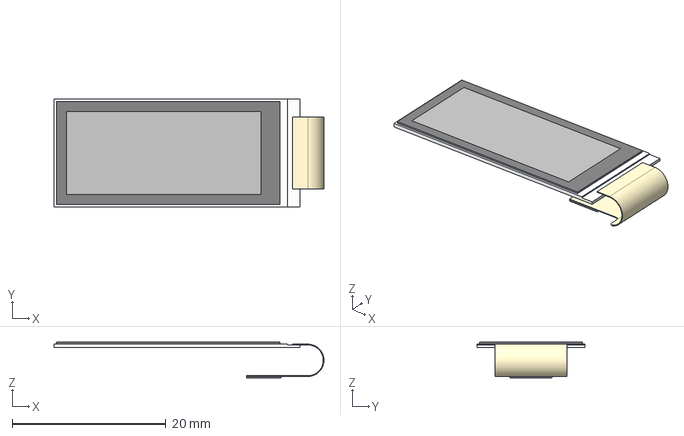
[picture p51: CAD file, 2023-08-13]
3dmodels/step/LS011B7DH03_bend.step
35.1 x 14.0 x 4.68 mm
