korken89/kicad_libs/3dmodels/step/LS011B7DH03.step

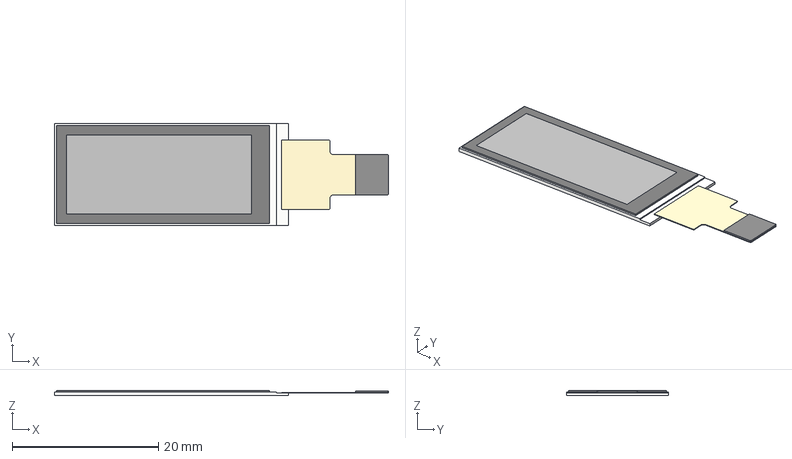
[picture p52: CAD file, 2023-08-13]
3dmodels/step/LS011B7DH03.step
45.6 x 14.0 x 0.745 mm
