korken89/kicad_libs/3dmodels/step/PG1350-socket.STEP

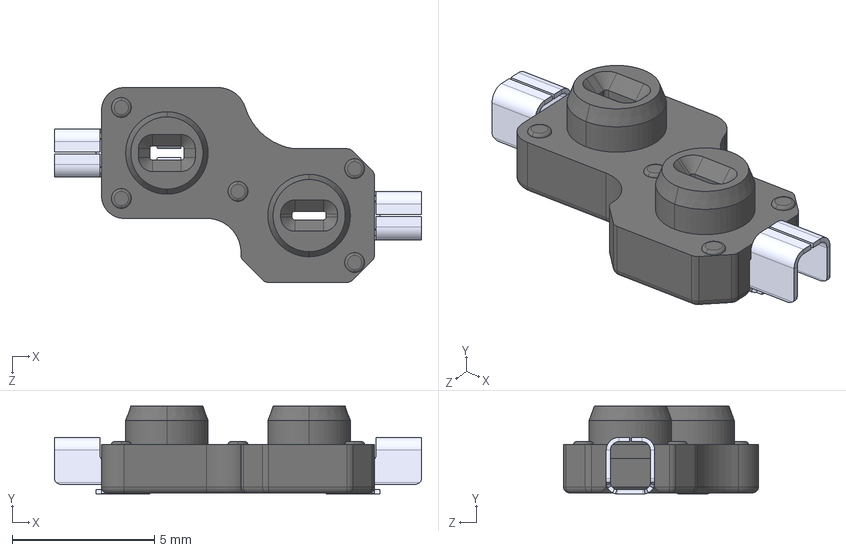
[picture p53: CAD file, 2023-08-12]
3dmodels/step/PG1350-socket.STEP
12.9 x 3.09 x 6.85 mm
pin x 2
socket
