korken89/kicad_libs/3dmodels/step/Kailh Choc Low Profile Switch.step

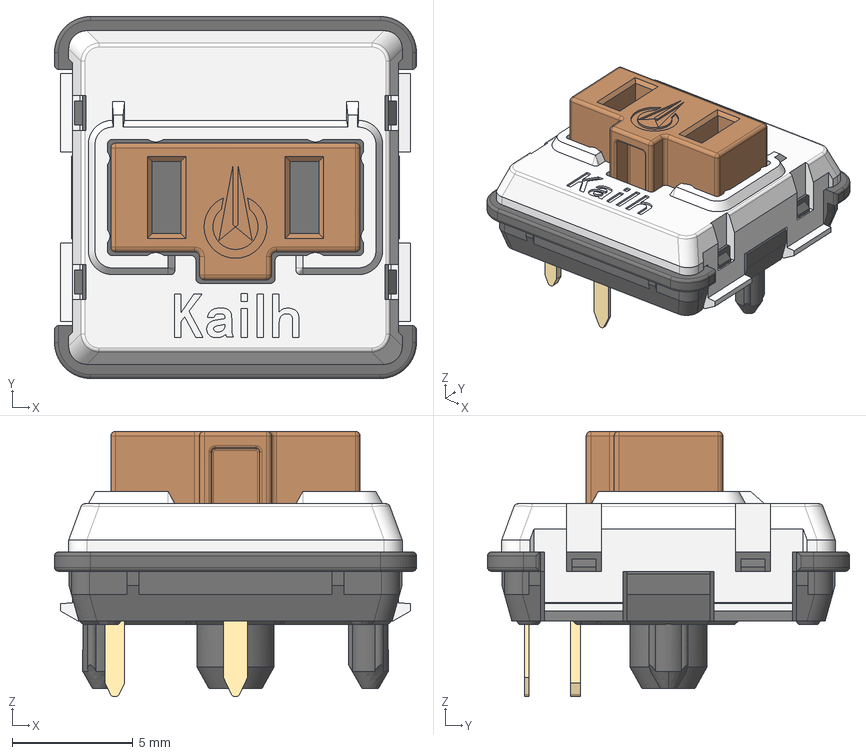
[picture p54: CAD file, 2023-08-12]
3dmodels/step/Kailh Choc Low Profile Switch.step
15.0 x 15.0 x 11.0 mm
Document
Document001
Document006
Document007
Document008
