korken89/kicad_libs/3dmodels/step/Kailh Hotswap MX v22.step

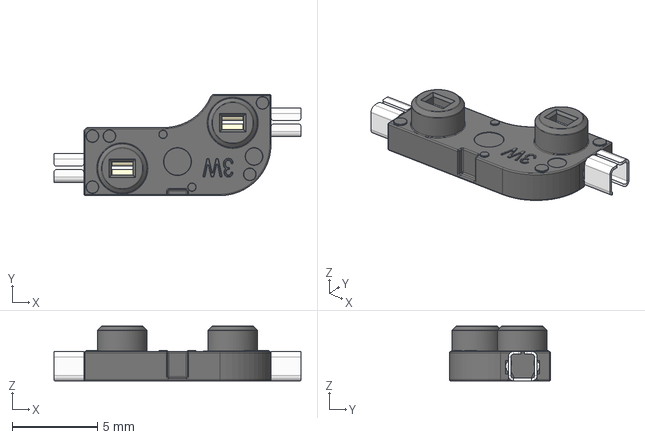
[picture p55: CAD file, 2023-08-06]
3dmodels/step/Kailh Hotswap MX v22.step
14.5 x 5.95 x 3.22 mm
