korken89/kicad_libs/3dmodels/step/cherry-mx.step

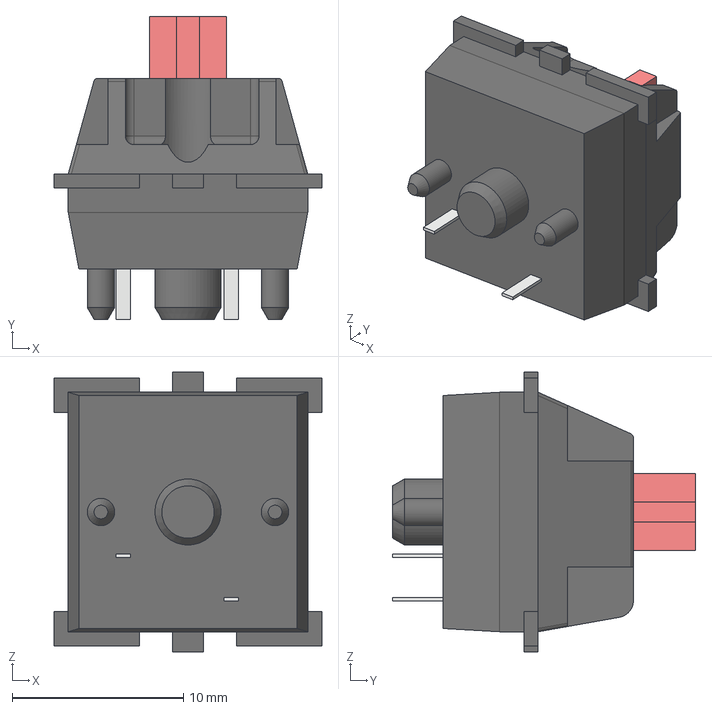
[picture p56: CAD file, 2023-08-06]
3dmodels/step/cherry-mx.step
15.6 x 17.7 x 16.3 mm
