korken89/kicad_libs/3dmodels/step/c-1734839-5-c-3d.stp

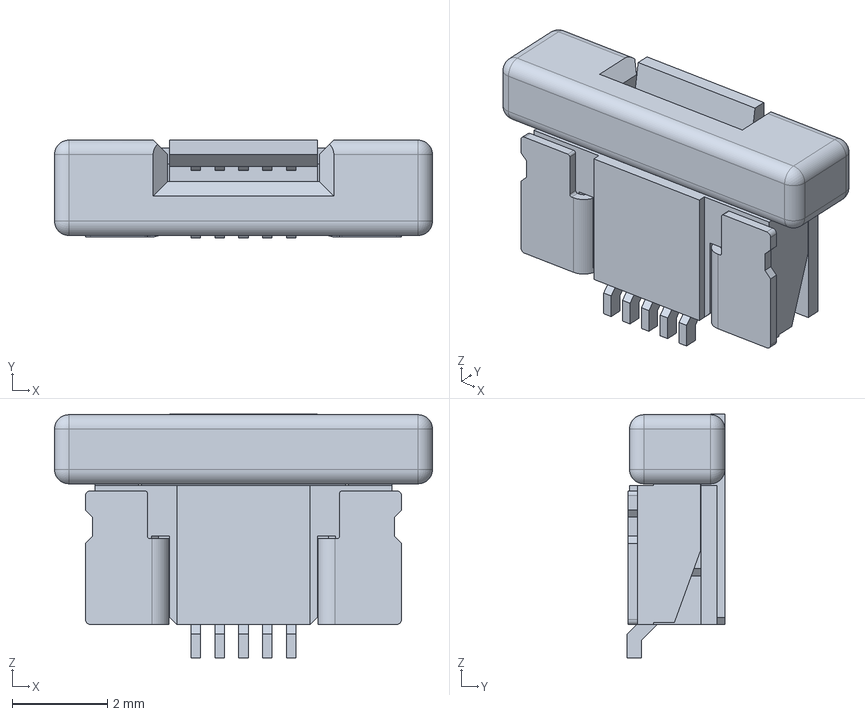
[picture p57: CAD file, 2023-03-22]
3dmodels/step/c-1734839-5-c-3d.stp
7.93 x 2.05 x 5.11 mm
