korken89/kicad_libs/3dmodels/step/ltst-c19he1wt.stp

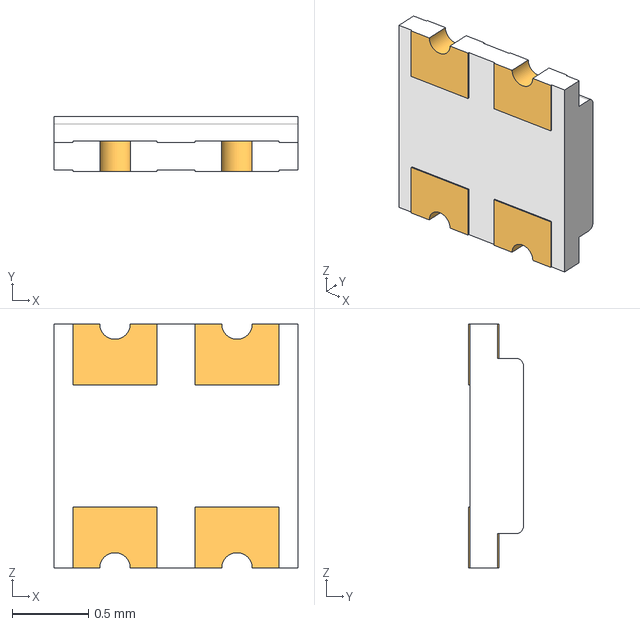
[picture p58: CAD file, 2023-03-22]
3dmodels/step/ltst-c19he1wt.stp
1.60 x 0.36 x 1.60 mm
