korken89/kicad_libs/3dmodels/step/VC1034B018F.step

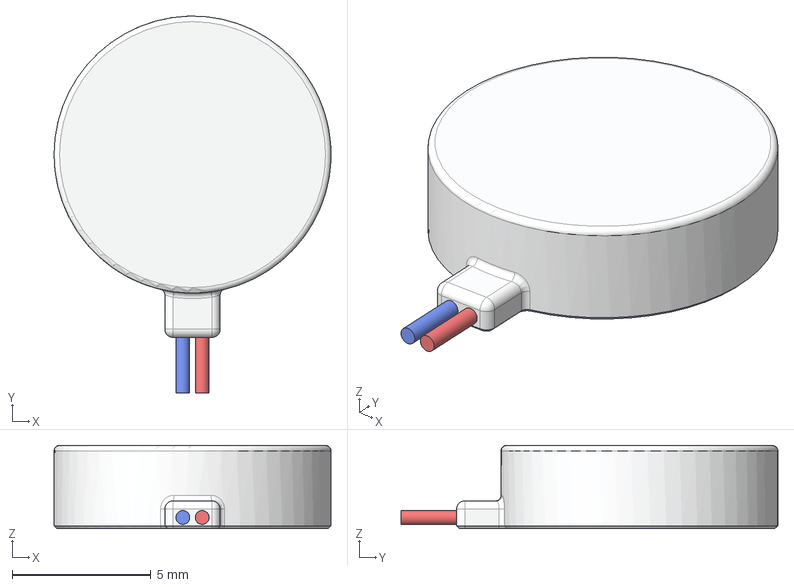
[picture p59: CAD file, 2023-03-22]
3dmodels/step/VC1034B018F.step
10.00 x 13.6 x 3.00 mm
