korken89/kicad_libs/3dmodels/step/AST0927MW.step

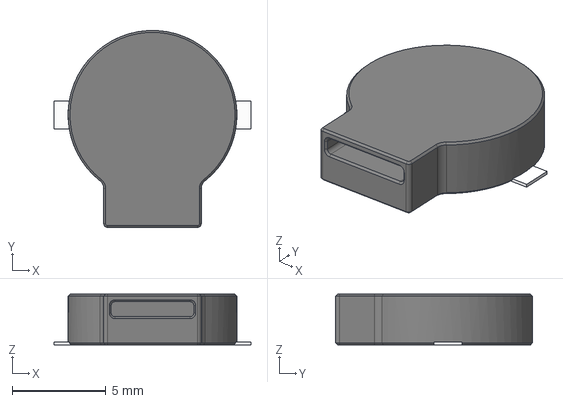
[picture p60: CAD file, 2023-03-22]
3dmodels/step/AST0927MW.step
10.5 x 10.5 x 2.70 mm
