korken89/kicad_libs/3dmodels/step/DFN1006-2.stp

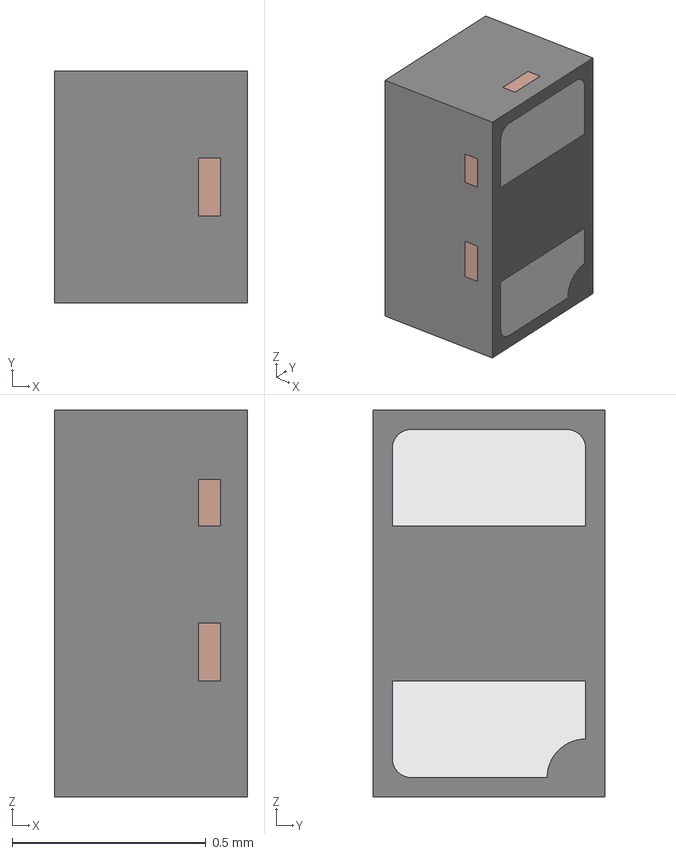
[picture p61: CAD file, 2023-02-27]
3dmodels/step/DFN1006-2.stp
0.5 x 0.6 x 1.00 mm
LDF
