korken89/kicad_libs/3dmodels/step/MM8130-2600.step

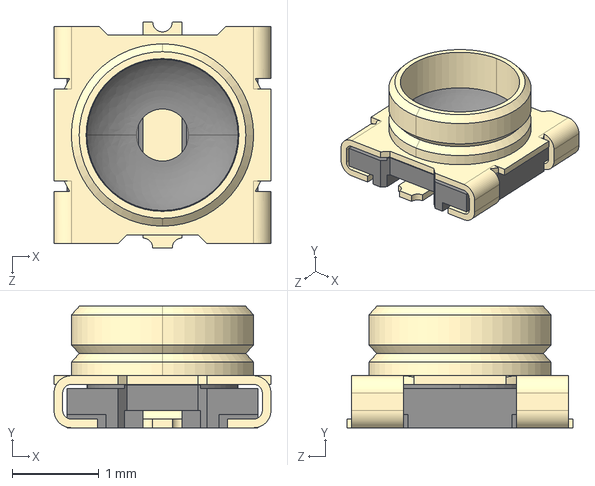
[picture p62: CAD file, 2023-02-26]
3dmodels/step/MM8130-2600.step
2.50 x 1.40 x 2.60 mm
