korken89/kicad_libs/3dmodels/step/m10-gps.step

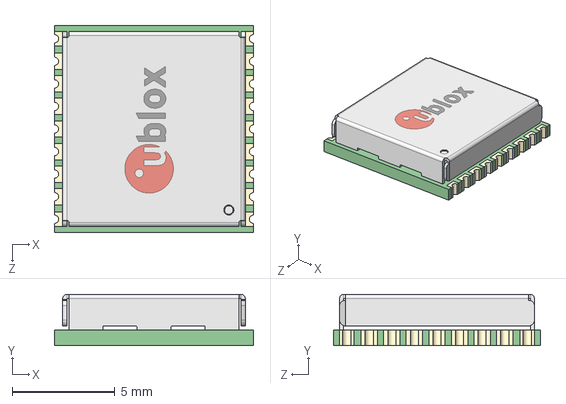
[picture p63: CAD file, 2023-02-26]
3dmodels/step/m10-gps.step
9.70 x 2.50 x 10.1 mm
