korken89/kicad_libs/3dmodels/step/u-blox SARA-R4.stp

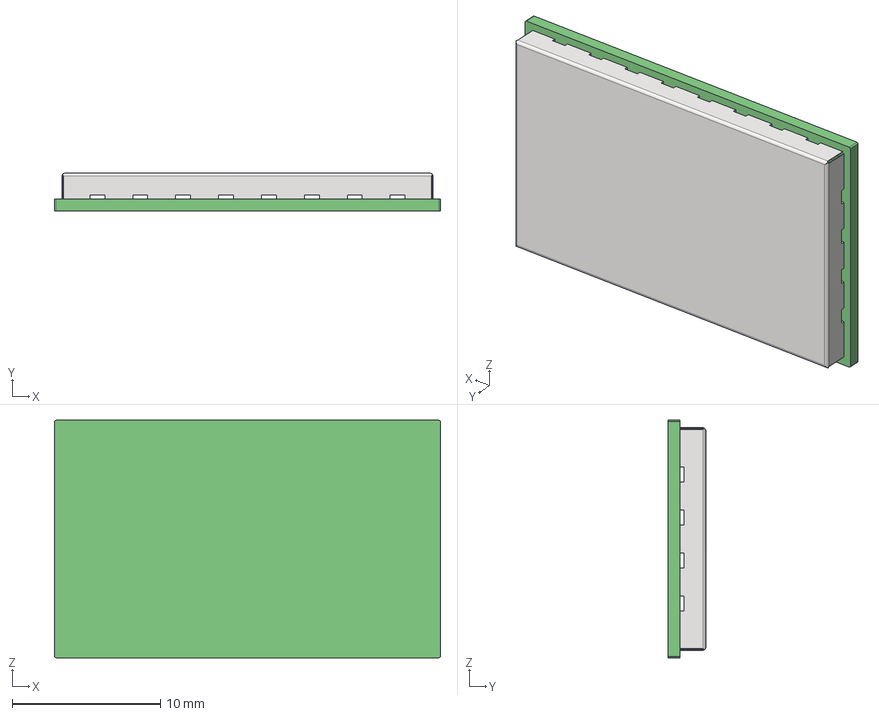
[picture p64: CAD file, 2023-02-22]
3dmodels/step/u-blox SARA-R4.stp
26.0 x 2.53 x 16.0 mm
