korken89/kicad_libs/3dmodels/step/SIM8051-6-0-14-00-A.stp

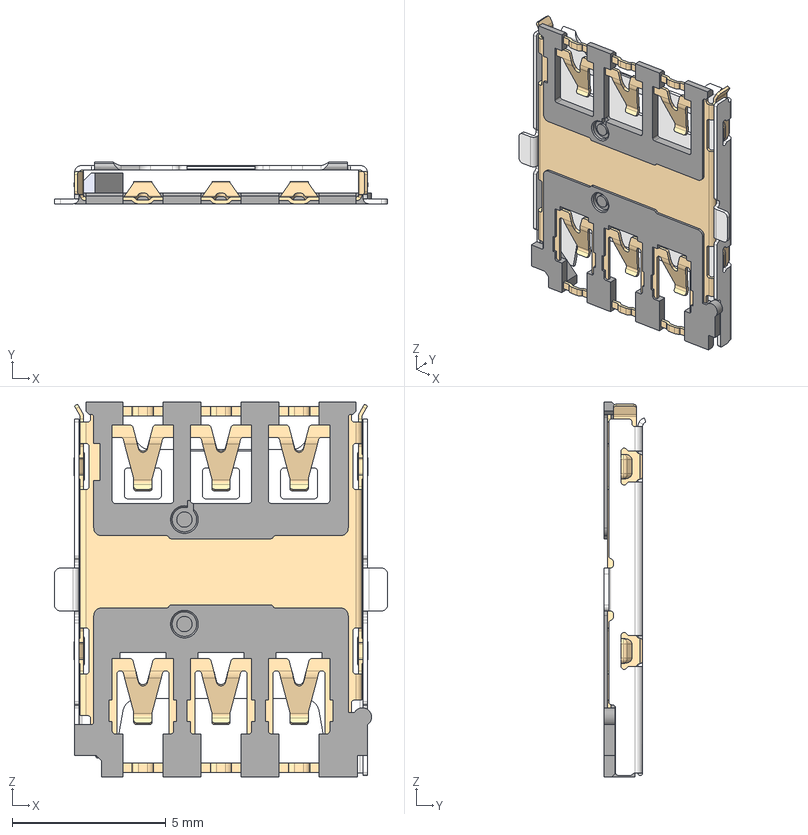
[picture p65: CAD file, 2023-01-24]
3dmodels/step/SIM8051-6-0-14-00-A.stp
10.8 x 1.35 x 12.2 mm
