korken89/kicad_libs/3dmodels/step/EVQ-P2-0246-02W+P9-HP-02W.STEP

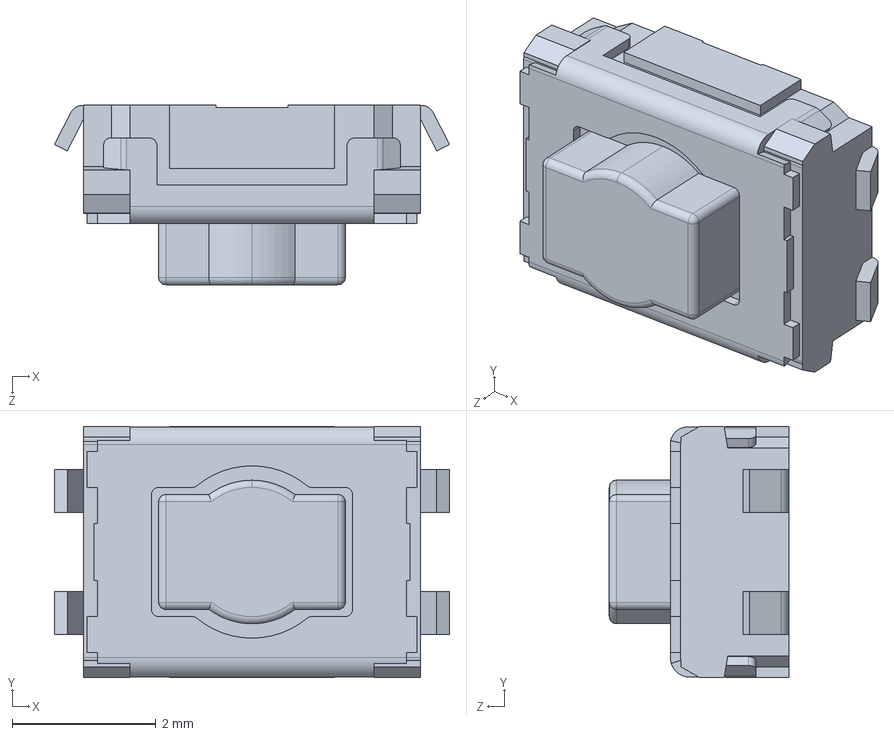
[picture p66: CAD file, 2022-12-07]
3dmodels/step/EVQ-P2-0246-02W+P9-HP-02W.STEP
5.50 x 3.50 x 2.50 mm
