korken89/kicad_libs/3dmodels/step/6530BP44A1190_JOT.step

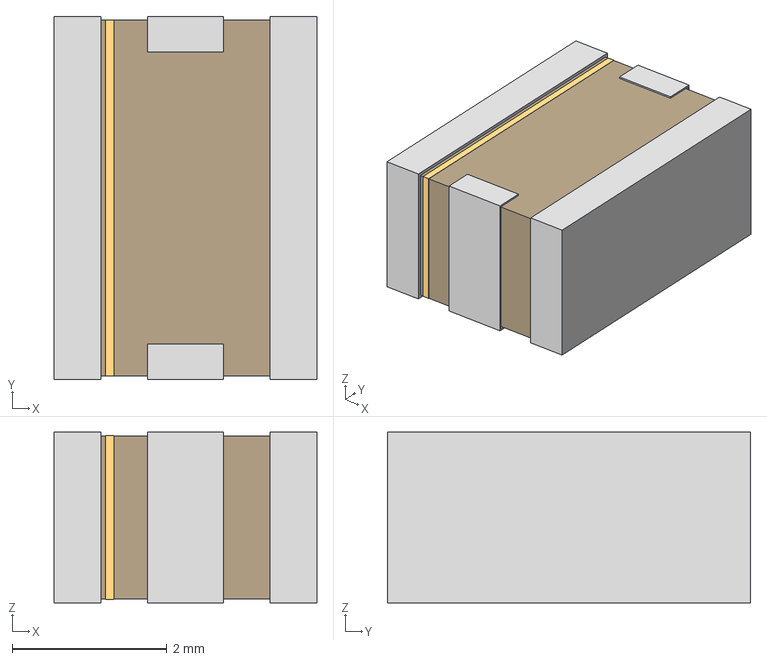
[picture p67: CAD file, 2022-12-06]
3dmodels/step/6530BP44A1190_JOT.step
3.40 x 4.70 x 2.21 mm
