korken89/kicad_libs/3dmodels/step/UWC.20_Web.STEP

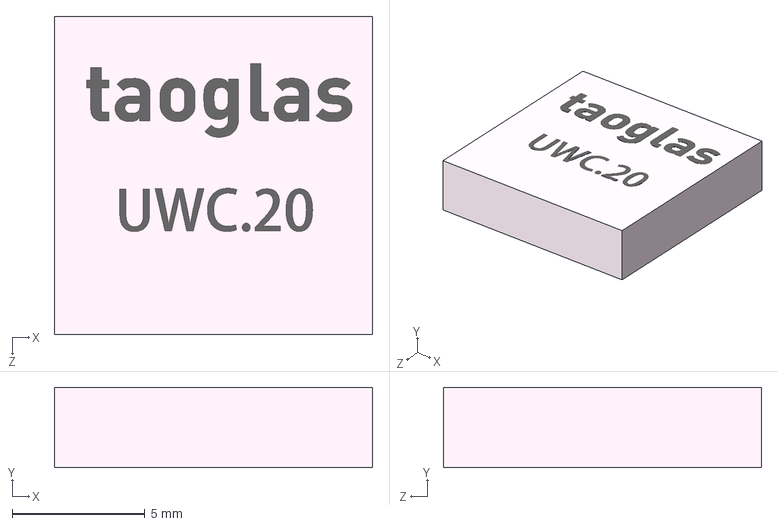
[picture p68: CAD file, 2022-09-13]
3dmodels/step/UWC.20_Web.STEP
12.0 x 3.02 x 12.0 mm
