korken89/kicad_libs/3dmodels/step/CUI_DEVICES_SJ-3541AS-SMT-TR-67.step

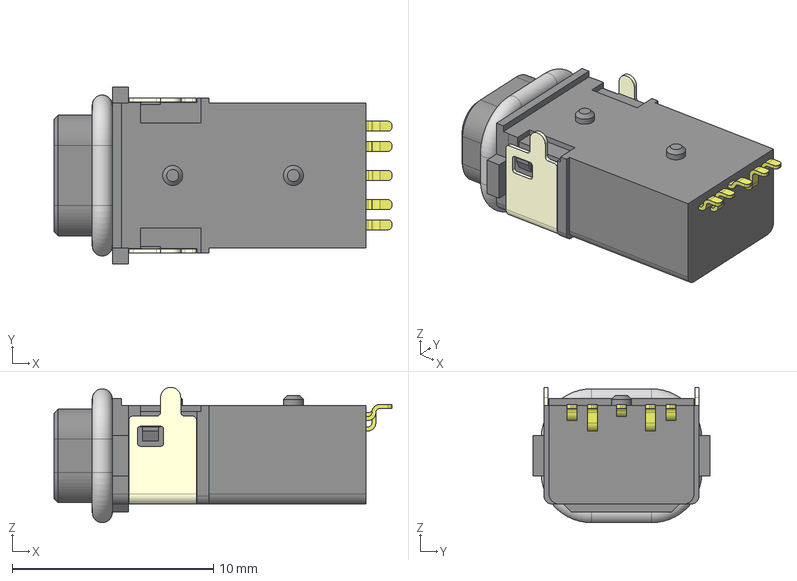
[picture p69: CAD file, 2022-09-06]
3dmodels/step/CUI_DEVICES_SJ-3541AS-SMT-TR-67.step
16.8 x 8.80 x 6.72 mm
