korken89/kicad_libs/3dmodels/step/CUI_DEVICES_TS04-66-85-BK-260-SMT.step

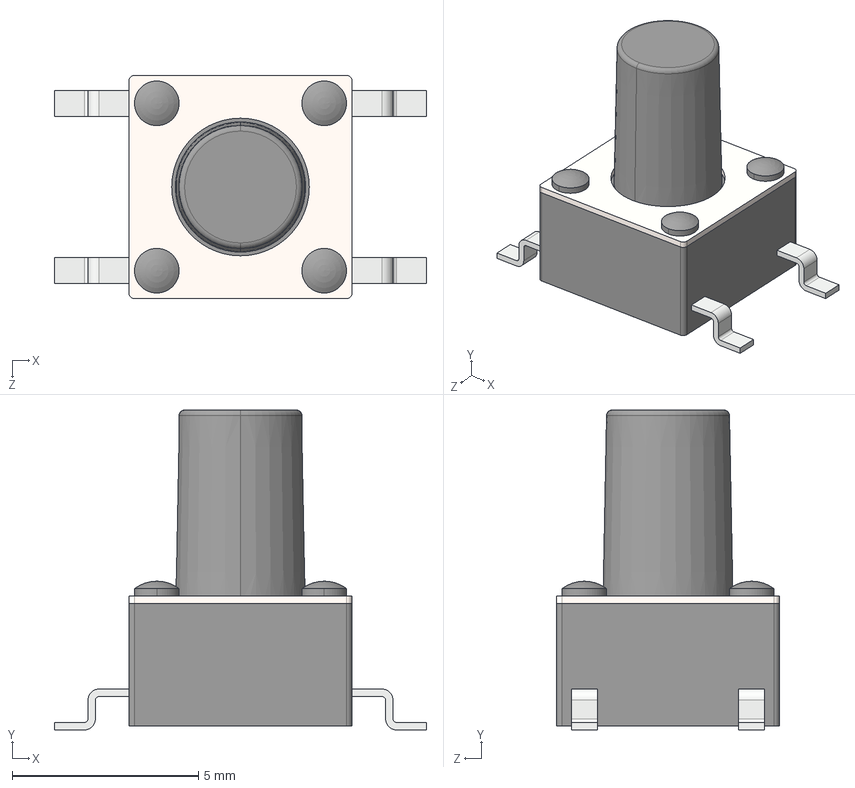
[picture p70: CAD file, 2022-08-31]
3dmodels/step/CUI_DEVICES_TS04-66-85-BK-260-SMT.step
10.0 x 8.60 x 6.00 mm
