korken89/kicad_libs/3dmodels/step/CUI_DEVICES_SJ-43615TS-SMT-TR.step

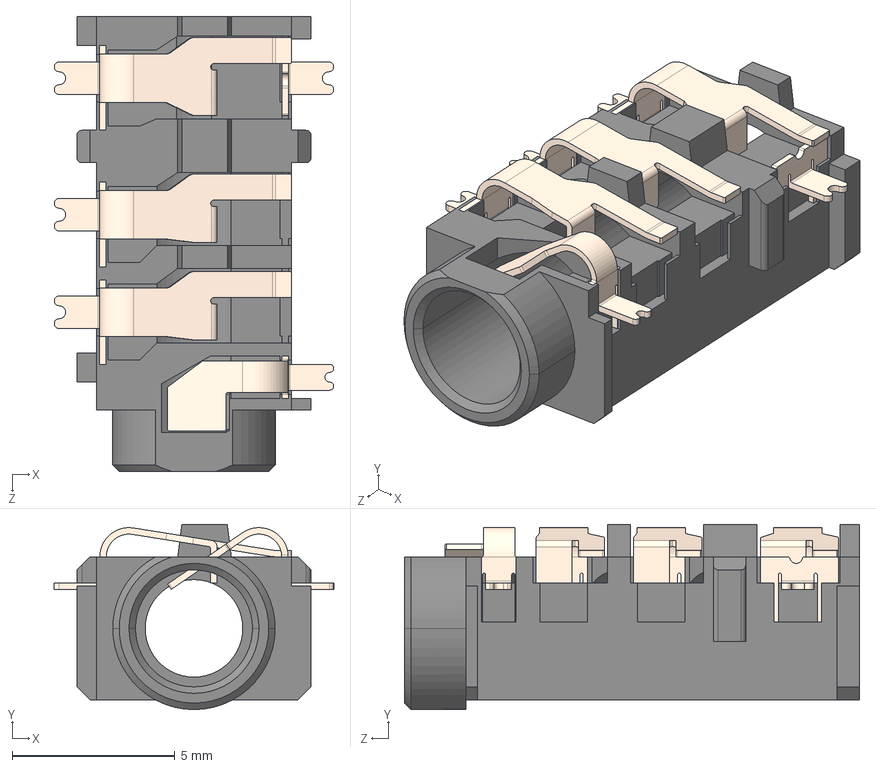
[picture p71: CAD file, 2022-08-31]
3dmodels/step/CUI_DEVICES_SJ-43615TS-SMT-TR.step
8.60 x 5.70 x 14.0 mm
