korken89/kicad_libs/3dmodels/step/bmi-s-102.step

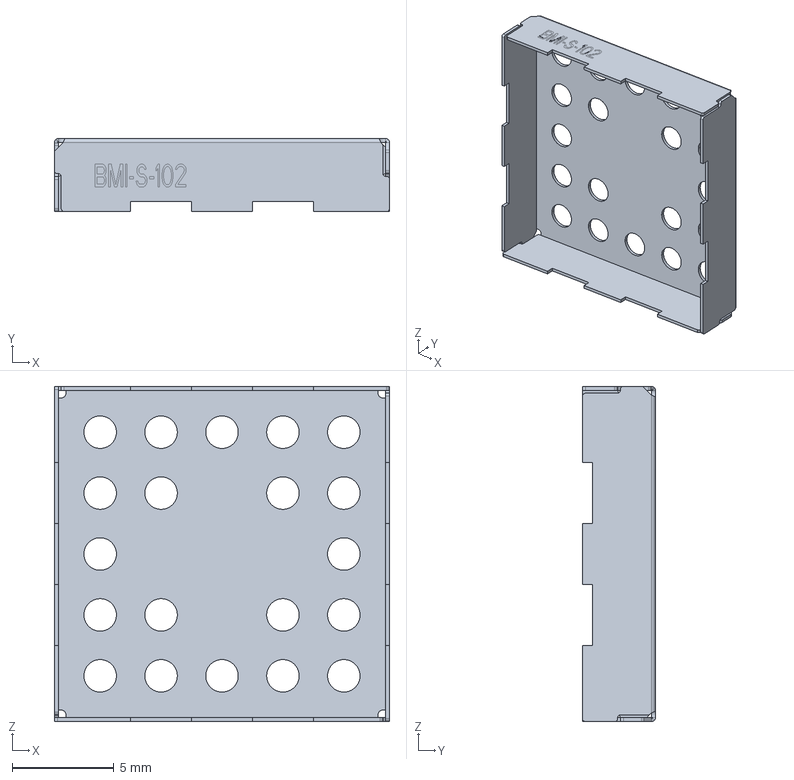
[picture p72: CAD file, 2022-08-22]
3dmodels/step/bmi-s-102.step
16.5 x 3.60 x 16.5 mm
