korken89/kicad_libs/3dmodels/step/NRF9160-SICA-R7.step

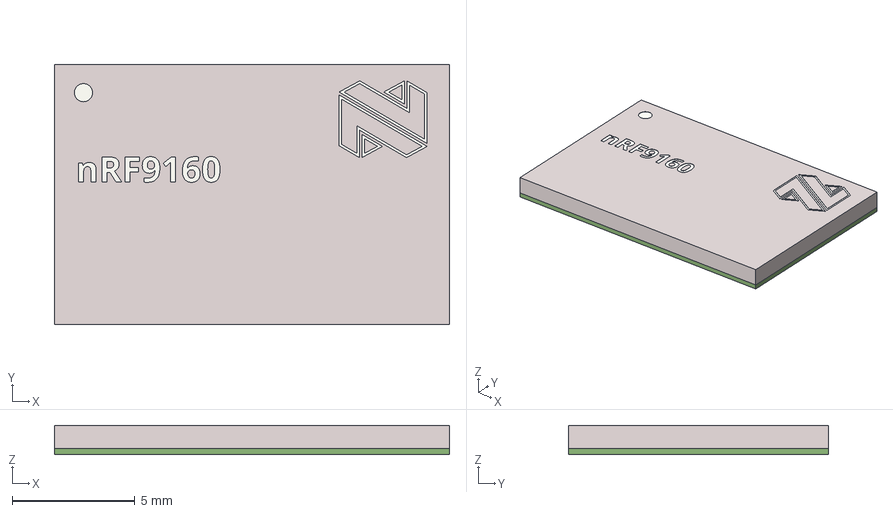
[picture p73: CAD file, 2022-06-28]
3dmodels/step/NRF9160-SICA-R7.step
16.1 x 10.6 x 1.20 mm
nRF9160
nRF9161
nRF9162
