korken89/kicad_libs/3dmodels/step/JST_SM02B-SRSS-TB.step

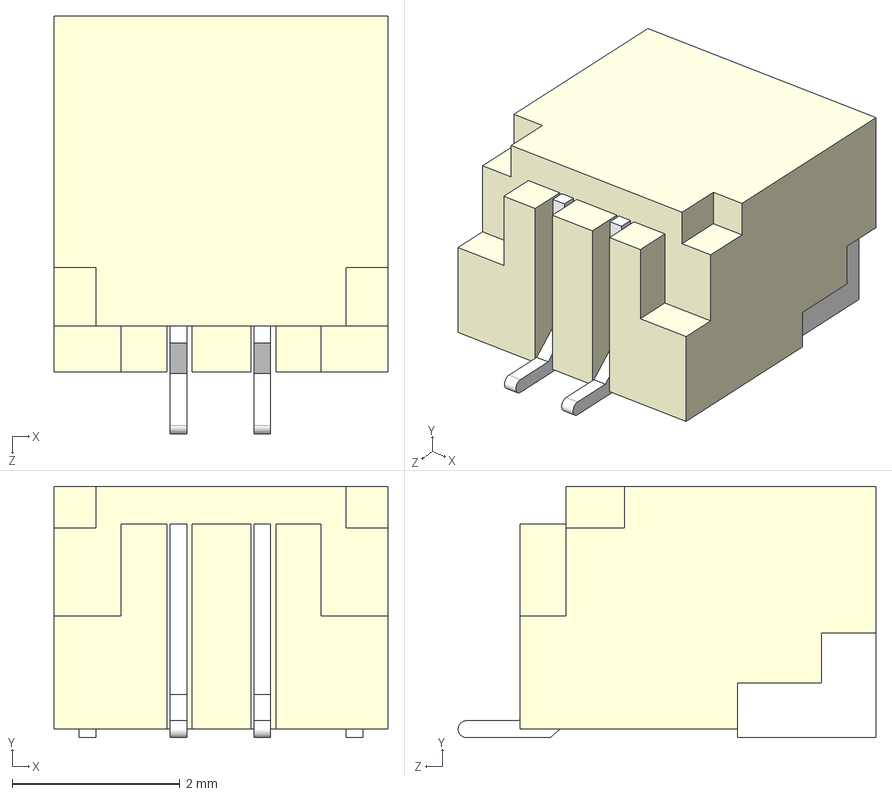
[picture p74: CAD file, 2022-05-06]
3dmodels/step/JST_SM02B-SRSS-TB.step
3.99 x 3.00 x 4.99 mm
