korken89/kicad_libs/3dmodels/step/SMA_female_edge_6.5x6.5.step

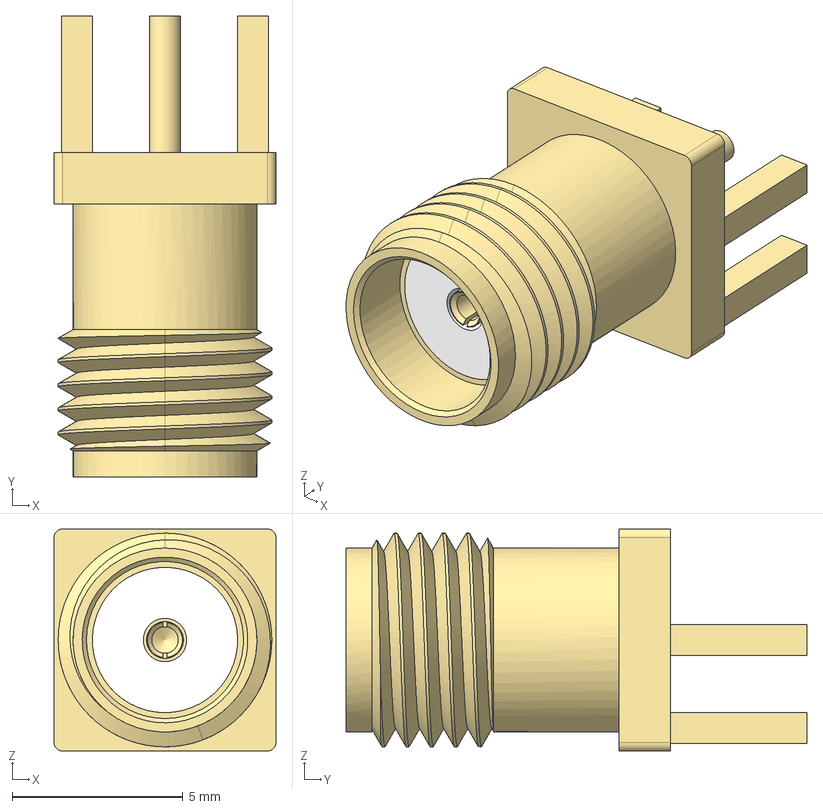
[picture p75: CAD file, 2022-05-06]
3dmodels/step/SMA_female_edge_6.5x6.5.step
6.50 x 13.5 x 6.50 mm
Dielectric
Pin
