korken89/kicad_libs/3dmodels/step/UWCCP.01_Web.STEP

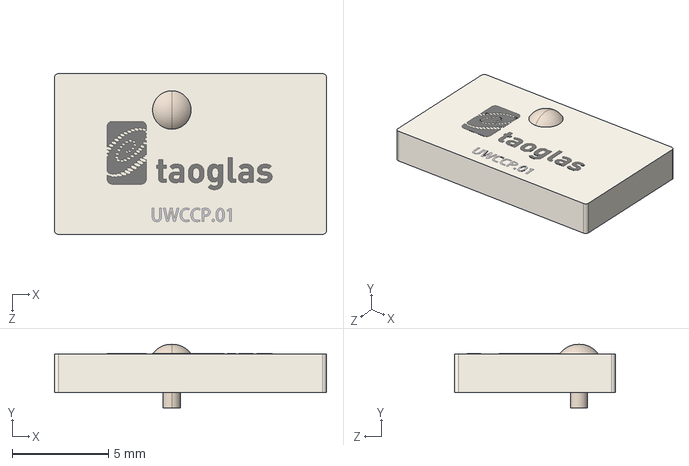
[picture p76: CAD file, 2022-05-05]
3dmodels/step/UWCCP.01_Web.STEP
14.1 x 3.30 x 8.35 mm
