korken89/kicad_libs/3dmodels/step/CS75Ntop.step

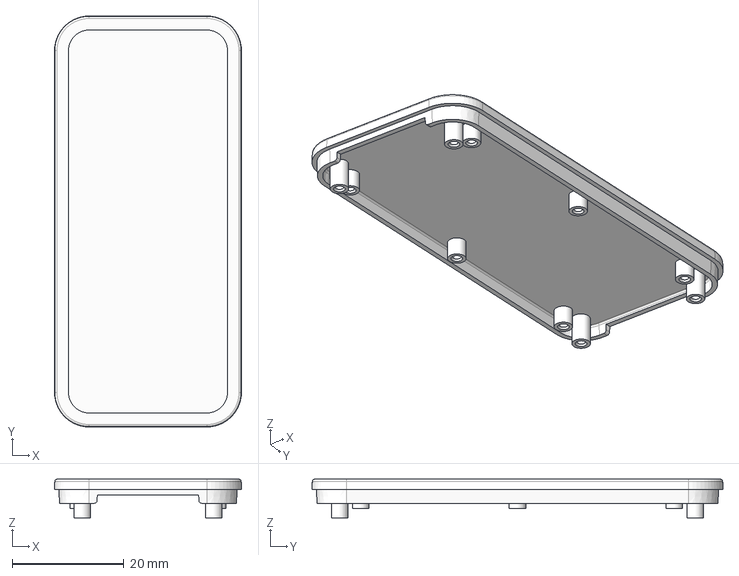
[picture p77: CAD file, 2022-05-04]
3dmodels/step/CS75Ntop.step
33.4 x 73.4 x 6.90 mm
