korken89/kicad_libs/3dmodels/step/CS90N-B-bot.stp

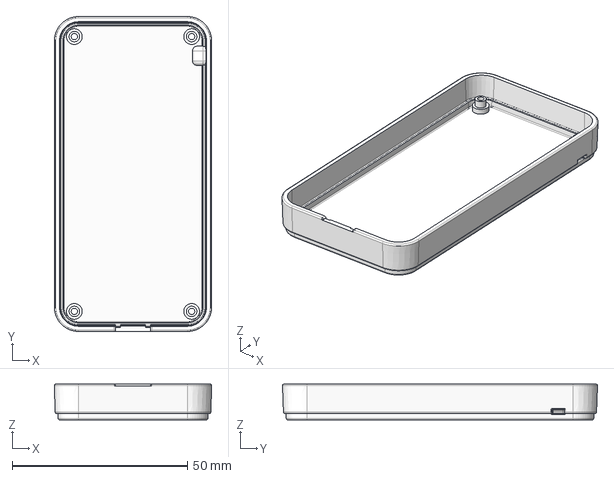
[picture p78: CAD file, 2022-04-26]
3dmodels/step/CS90N-B-bot.stp
45.0 x 90.0 x 10.2 mm
