korken89/kicad_libs/3dmodels/step/CUI_DEVICES_SJ-3523-SMT-TR.step

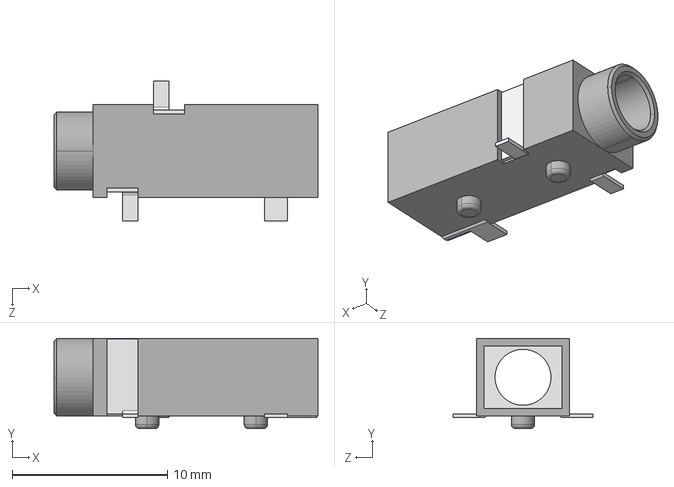
[picture p79: CAD file, 2022-04-26]
3dmodels/step/CUI_DEVICES_SJ-3523-SMT-TR.step
17.0 x 5.80 x 9.00 mm
