korken89/kicad_libs/3dmodels/step/CS90N-B-top.stp

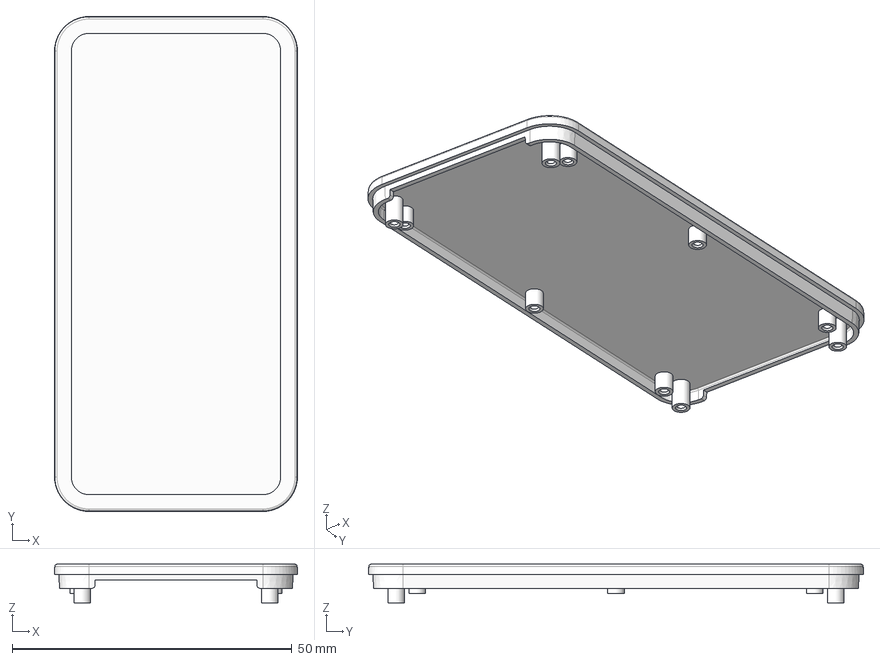
[picture p80: CAD file, 2022-04-26]
3dmodels/step/CS90N-B-top.stp
43.4 x 88.4 x 6.90 mm
