korken89/kicad_libs/3dmodels/step/FTSH-105-01-L-DV-K.stp

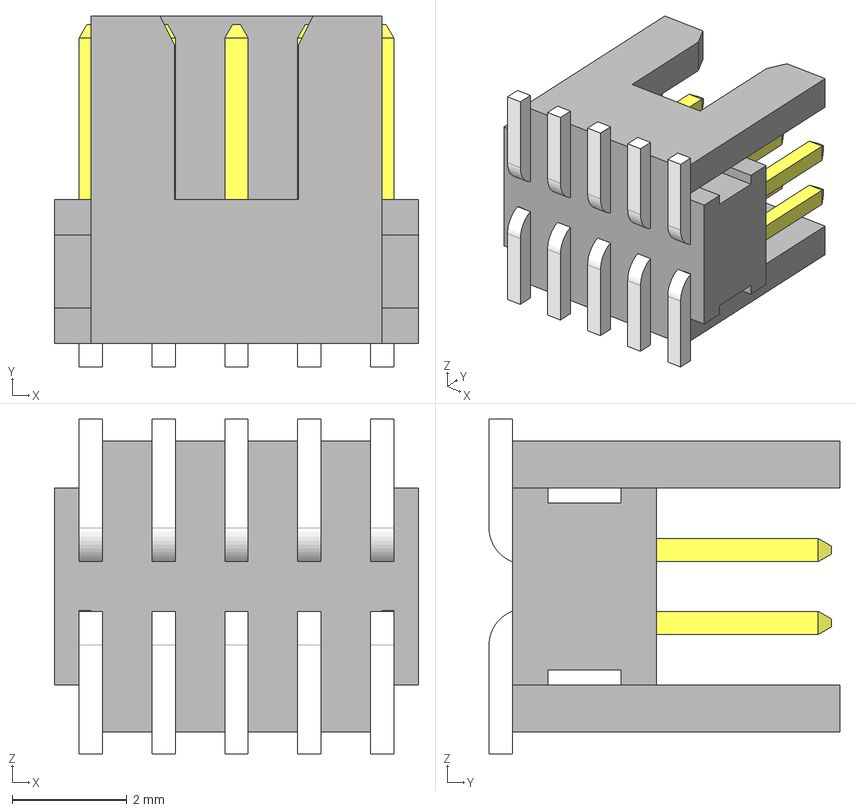
[picture p81: CAD file, 2022-03-10]
3dmodels/step/FTSH-105-01-L-DV-K.stp
6.35 x 6.12 x 5.84 mm
_FTSH-105-01-L-DV-K_body
_FTSH-105-01-L-DV-K_pins1
_FTSH-105-01-L-DV-K_pins2
