korken89/kicad_libs/3dmodels/step/m12_a-coded_86_2531_1100_00008.stp

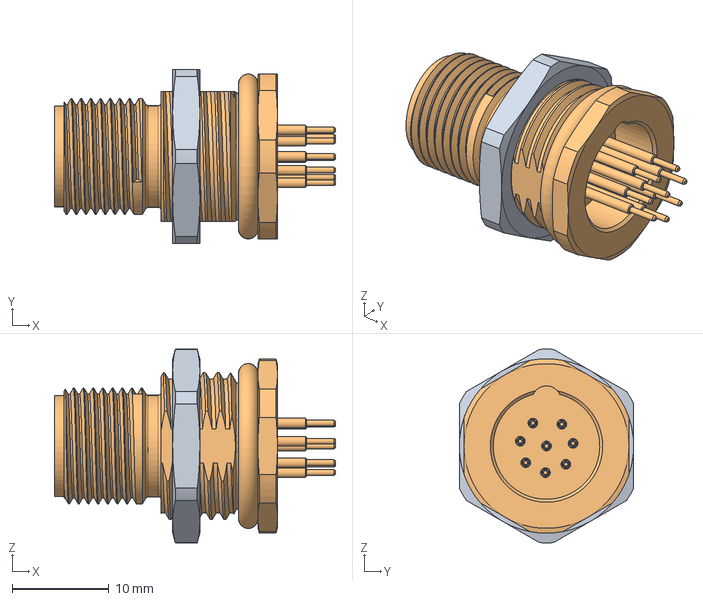
[picture p82: CAD file, 2020-09-17]
3dmodels/step/m12_a-coded_86_2531_1100_00008.stp
29.0 x 18.0 x 20.0 mm
