korken89/kicad_libs/3dmodels/step/FTSH-107-01-L-DV-K-TR.stp

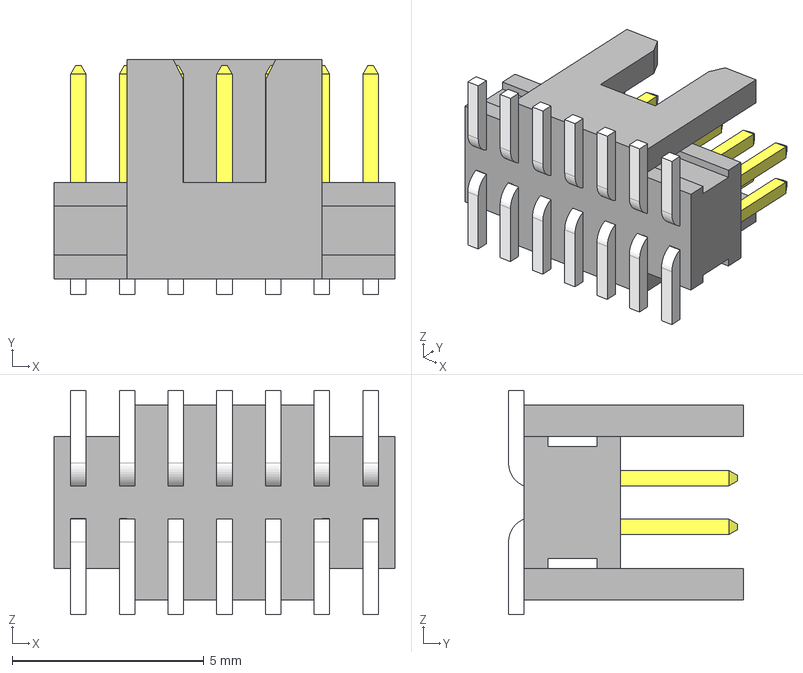
[picture p83: CAD file, 2020-07-19]
3dmodels/step/FTSH-107-01-L-DV-K-TR.stp
8.89 x 6.12 x 5.84 mm
_FTSH-107-01-L-DV-K-TR_body
_FTSH-107-01-L-DV-K-TR_pins1
_FTSH-107-01-L-DV-K-TR_pins2
