korken89/kicad_libs/3dmodels/step/Panasonic - EVQQ2.step

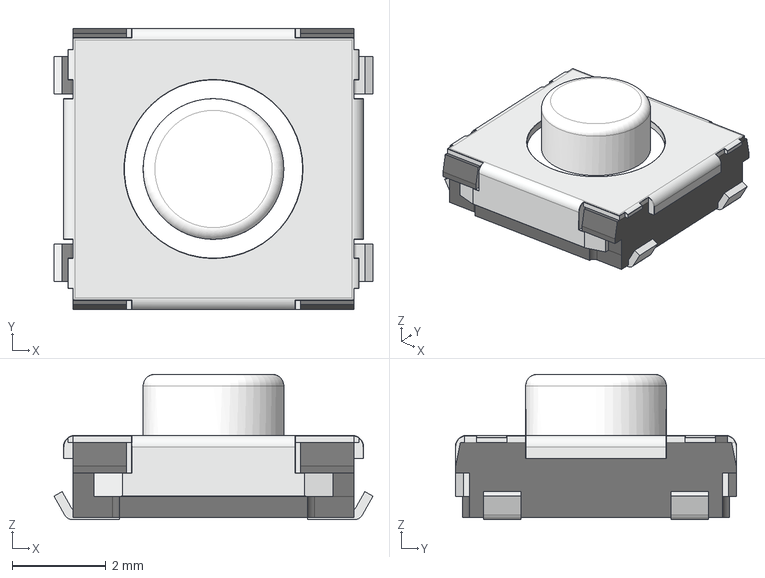
[picture p84: CAD file, 2020-06-30]
3dmodels/step/Panasonic - EVQQ2.step
6.80 x 6.00 x 3.10 mm
