korken89/kicad_libs/3dmodels/step/ferrite_sheet_35x15mm.step

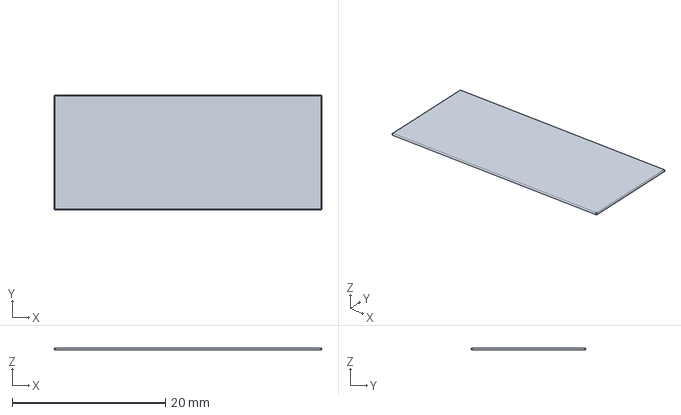
[picture p85: CAD file, 2020-04-24]
3dmodels/step/ferrite_sheet_35x15mm.step
35.0 x 15.0 x 0.3 mm
