korken89/kicad_libs/3dmodels/step/PTS526SPG15SMTR2LFS.stp

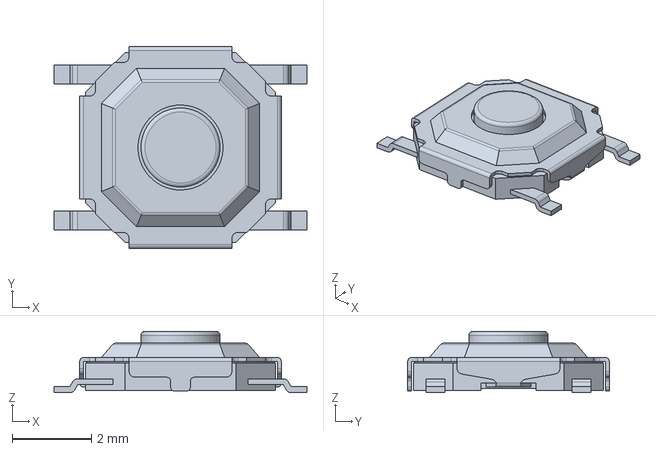
[picture p86: CAD file, 2020-04-20]
3dmodels/step/PTS526SPG15SMTR2LFS.stp
6.40 x 5.10 x 1.55 mm
