korken89/kicad_libs/3dmodels/step/C1234B016F.step

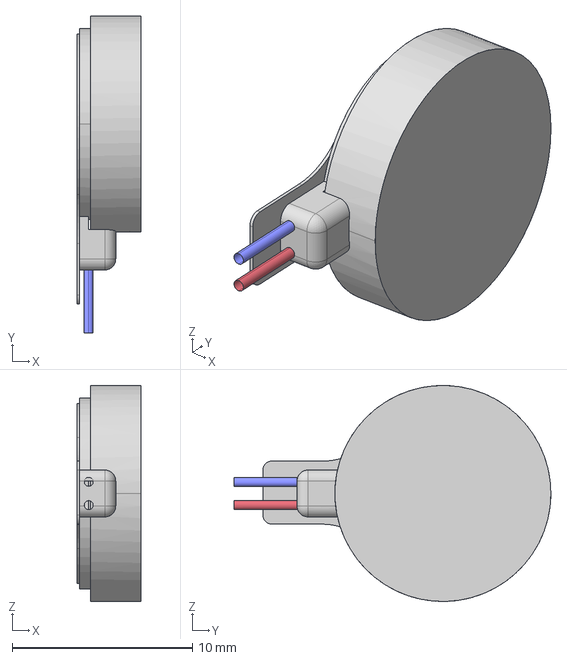
[picture p87: CAD file, 2020-04-16]
3dmodels/step/C1234B016F.step
3.55 x 17.6 x 12.0 mm
