korken89/kicad_libs/3dmodels/step/Z6DCBB0735091.step

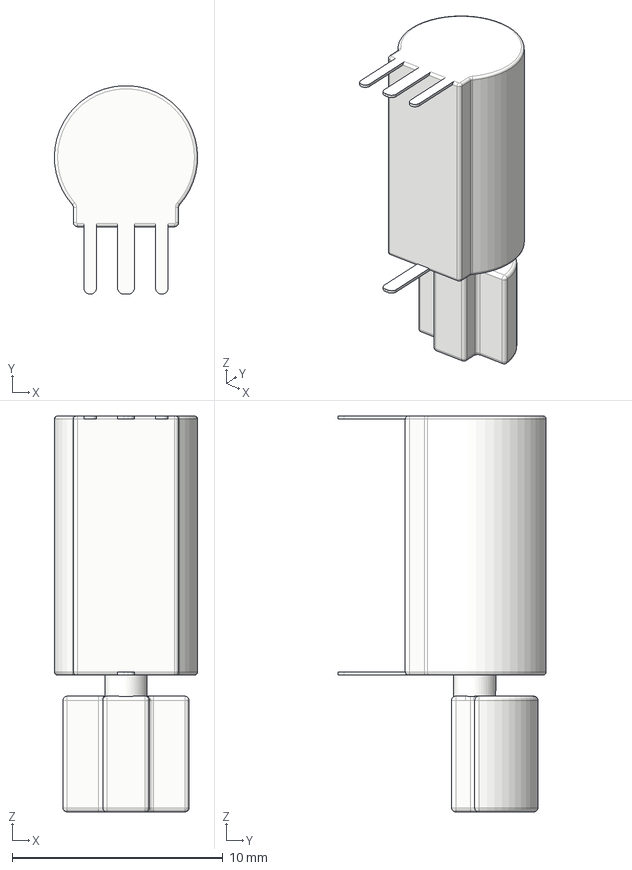
[picture p88: CAD file, 2020-04-15]
3dmodels/step/Z6DCBB0735091.step
6.80 x 9.89 x 18.8 mm
