korken89/kicad_libs/3dmodels/step/USB4105.step

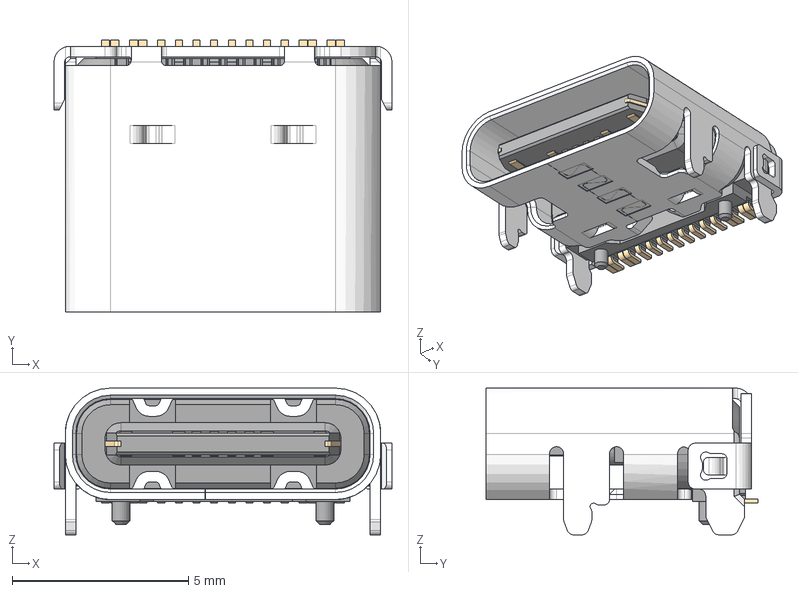
[picture p89: CAD file, 2020-03-31]
3dmodels/step/USB4105.step
9.58 x 7.71 x 4.16 mm
