korken89/kicad_libs/3dmodels/step/okw_large_bottom.step

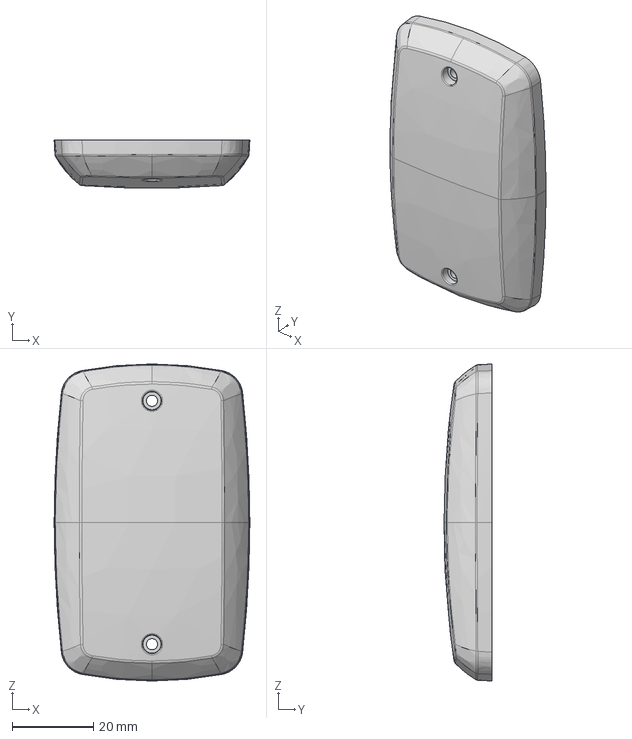
[picture p90: CAD file, 2020-03-27]
3dmodels/step/okw_large_bottom.step
48.2 x 11.8 x 78.1 mm
