korken89/kicad_libs/3dmodels/step/okw_large_top.step

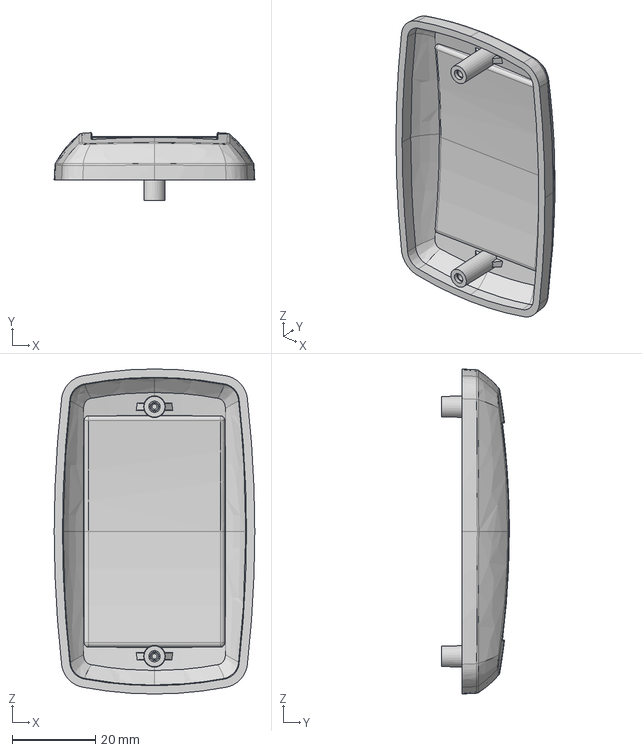
[picture p91: CAD file, 2020-03-27]
3dmodels/step/okw_large_top.step
48.2 x 16.3 x 78.1 mm
