korken89/kicad_libs/3dmodels/step/STLINK-V3MODS.step

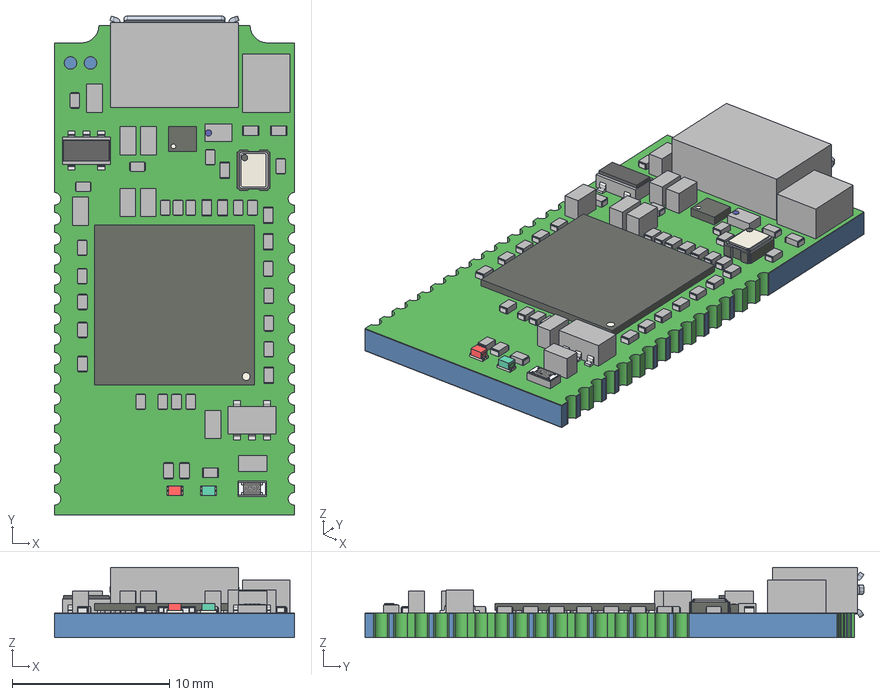
[picture p92: CAD file, 2020-03-15]
3dmodels/step/STLINK-V3MODS.step
15.2 x 31.7 x 4.47 mm
Board
LED0402_greenH05
Extruded x 59
R0402 x 12
C0402 x 22
C0603 x 8
SOT23-5L x 2
LED0402_redH05
R0603
