korken89/kicad_libs/3dmodels/step/PTS810.STEP

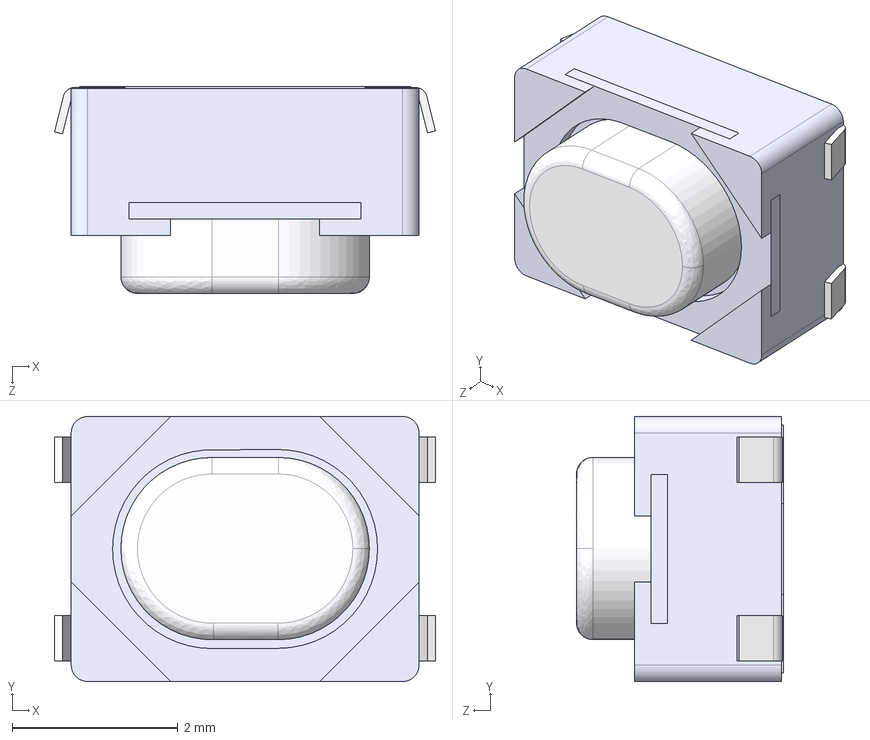
[picture p93: CAD file, 2020-01-14]
3dmodels/step/PTS810.STEP
4.60 x 3.20 x 2.50 mm
Strip
Button
Sheet Metal Part6 x 2
Pin
