korken89/kicad_libs/3dmodels/step/CUI_DEVICES_CMT-7525-80-SMT-TR.step

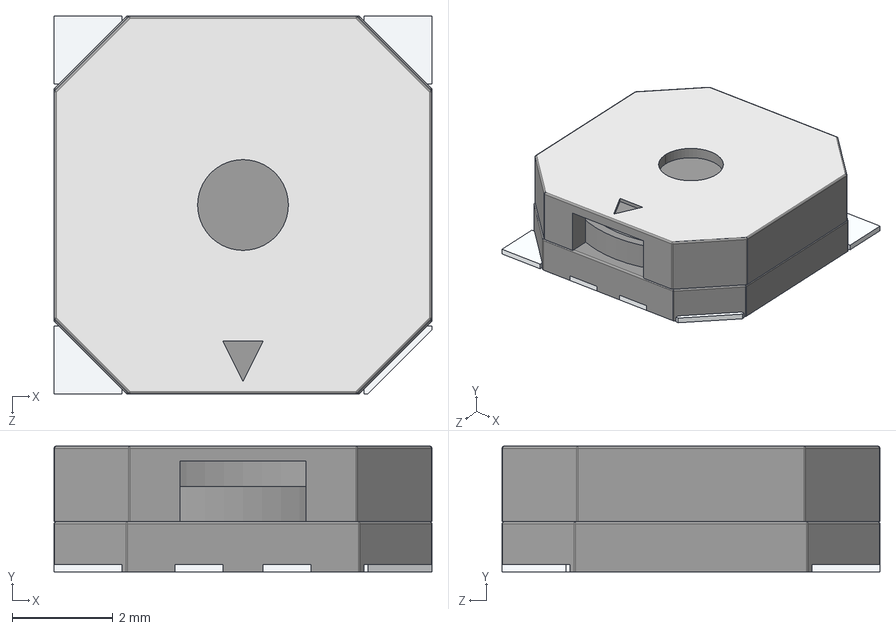
[picture p94: CAD file, 2020-01-09]
3dmodels/step/CUI_DEVICES_CMT-7525-80-SMT-TR.step
7.50 x 2.50 x 7.50 mm
