korken89/kicad_libs/3dmodels/step/m12_lens_holder_20x20mm.step

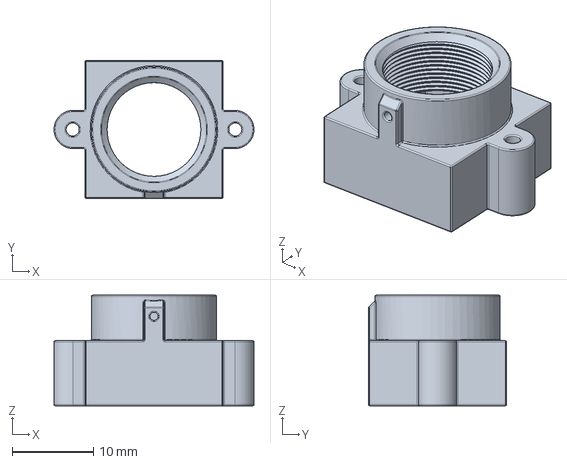
[picture p95: CAD file, 2019-08-05]
3dmodels/step/m12_lens_holder_20x20mm.step
24.6 x 17.0 x 13.6 mm
