korken89/kicad_libs/3dmodels/step/ssfv12r_3stlf.stp

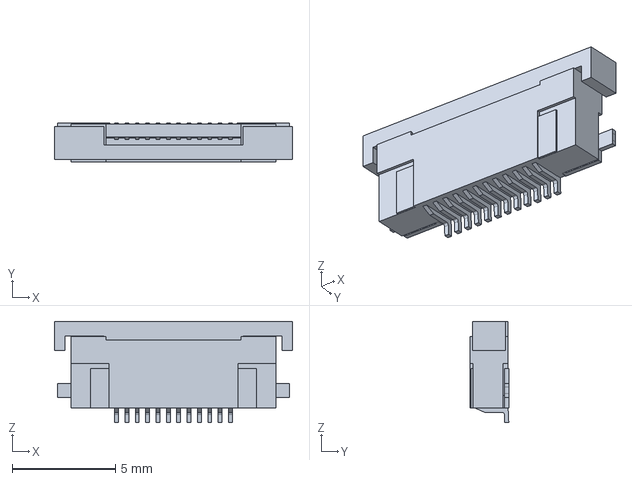
[picture p96: CAD file, 2019-07-31]
3dmodels/step/ssfv12r_3stlf.stp
11.5 x 1.87 x 4.90 mm
