korken89/kicad_libs/3dmodels/step/ssfv30r_3stlf.stp

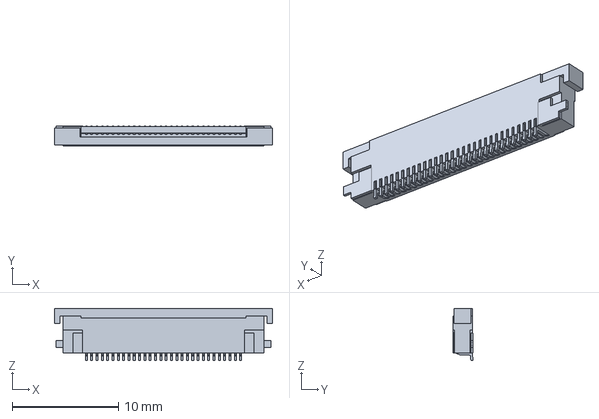
[picture p97: CAD file, 2019-07-30]
3dmodels/step/ssfv30r_3stlf.stp
20.5 x 1.87 x 4.90 mm
