korken89/kicad_libs/3dmodels/step/XDFN16.step

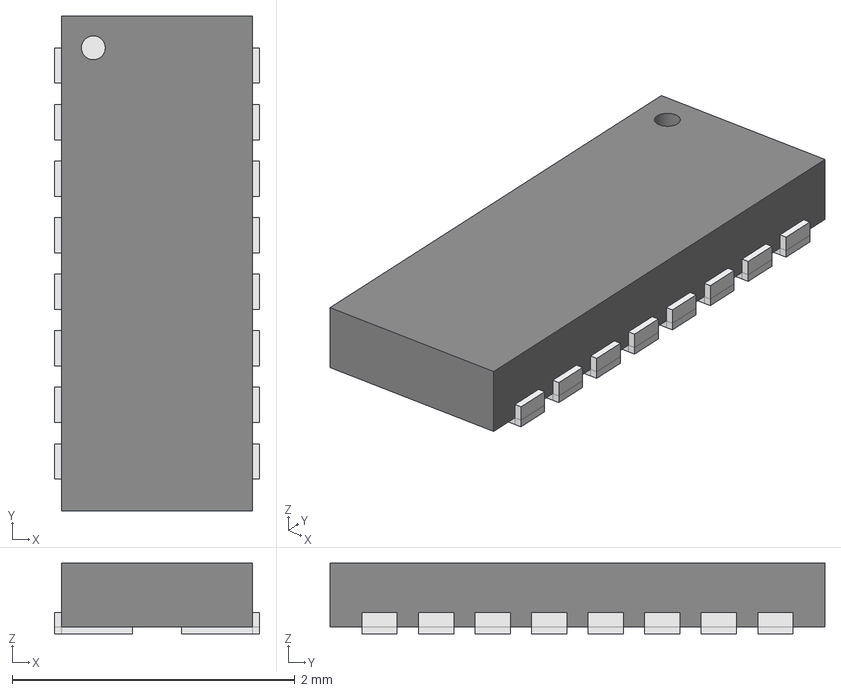
[picture p98: CAD file, 2019-07-06]
3dmodels/step/XDFN16.step
1.45 x 3.50 x 0.5 mm
Open_CASCADE_STEP_translator_6.8_11
Open_CASCADE_STEP_translator_6.8_11.2
Open_CASCADE_STEP_translator_6.8_11.3 x 16
