korken89/kicad_libs/3dmodels/step/ssfv16r_1stlf.stp

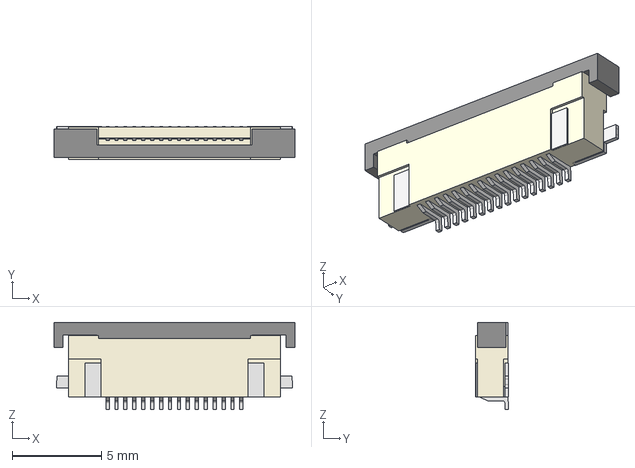
[picture p99: CAD file, 2019-07-06]
3dmodels/step/ssfv16r_1stlf.stp
13.5 x 1.87 x 4.90 mm
