korken89/kicad_libs/3dmodels/step/BGA96_8x14mm.step

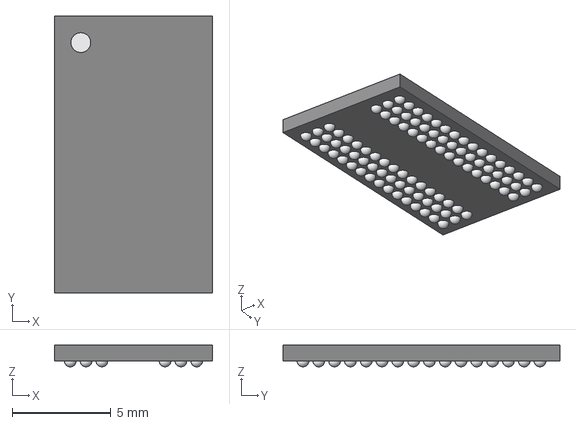
[picture p100: CAD file, 2019-07-06]
3dmodels/step/BGA96_8x14mm.step
8.00 x 14.0 x 1.10 mm
Open_CASCADE_STEP_translator_6.8_1.2
ball x 96
