korken89/kicad_libs/3dmodels/step/gsb343k33hr.stp

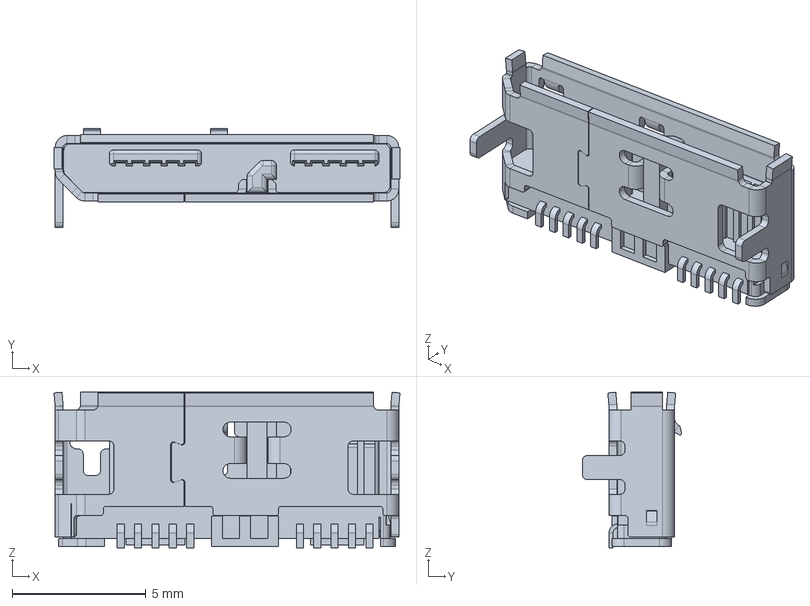
[picture p101: CAD file, 2019-06-30]
3dmodels/step/gsb343k33hr.stp
12.9 x 3.72 x 5.82 mm
