korken89/kicad_libs/3dmodels/step/DF40HC(4.0)-80DS.step

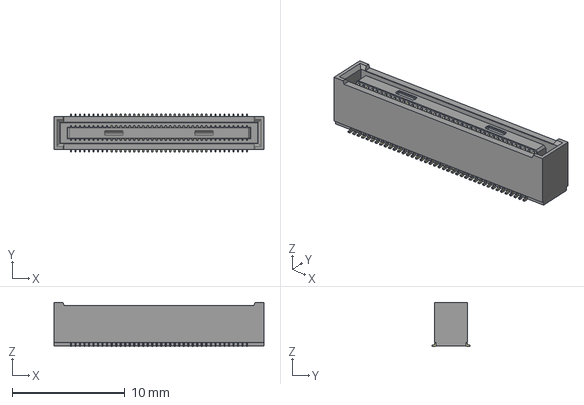
[picture p102: CAD file, 2019-05-13]
3dmodels/step/DF40HC(4.0)-80DS.step
18.6 x 3.38 x 3.90 mm
