korken89/kicad_libs/3dmodels/step/lensholder_22mm.step

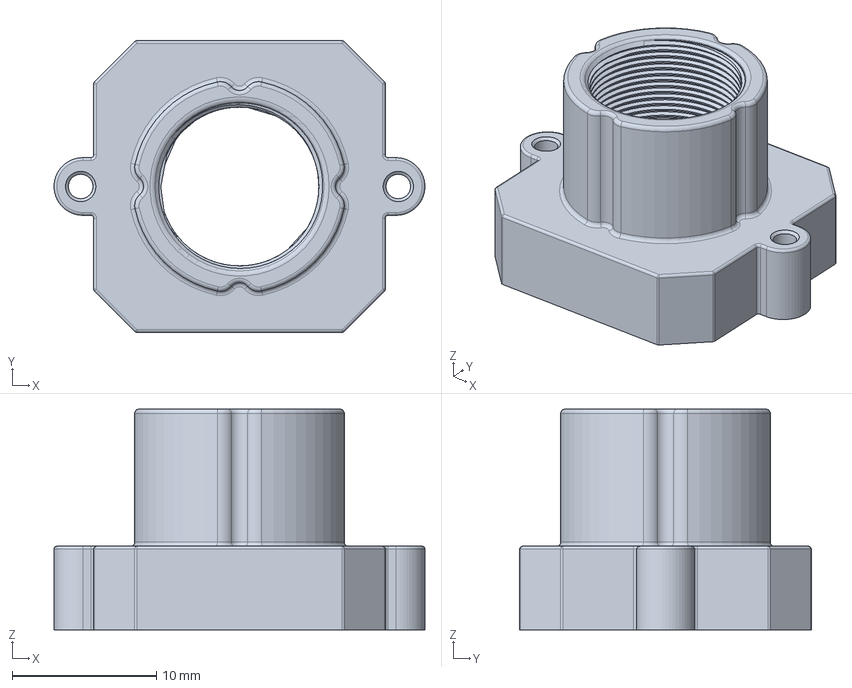
[picture p103: CAD file, 2019-03-30]
3dmodels/step/lensholder_22mm.step
25.7 x 20.2 x 15.3 mm
