korken89/kicad_libs/3dmodels/step/ar0135cs.step

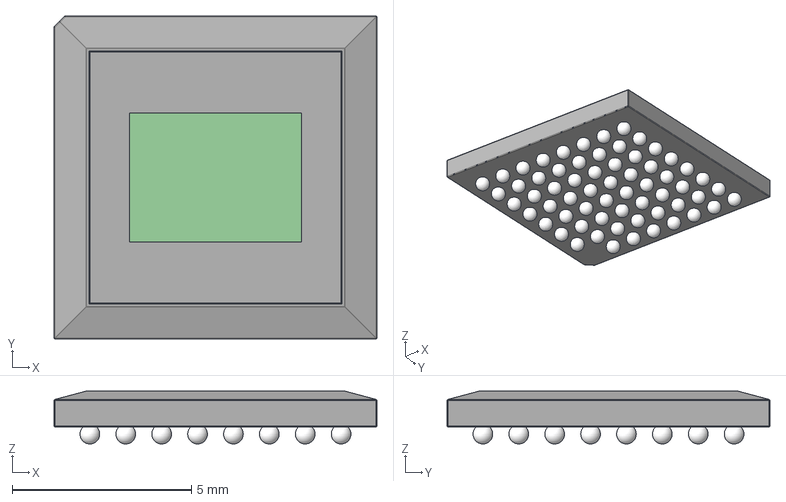
[picture p104: CAD file, 2019-03-23]
3dmodels/step/ar0135cs.step
9.00 x 9.00 x 1.48 mm
