korken89/kicad_libs/3dmodels/step/0826-1X1T-GJ-F.step

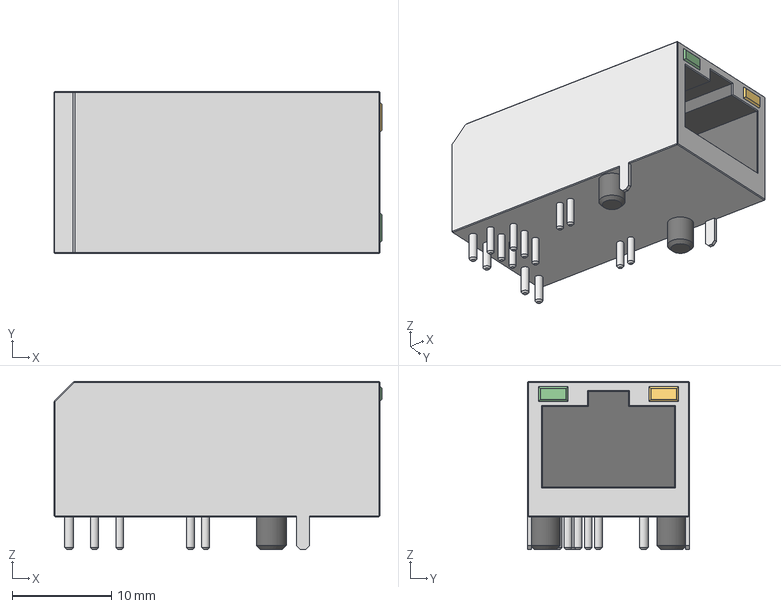
[picture p105: CAD file, 2019-02-17]
3dmodels/step/0826-1X1T-GJ-F.step
33.0 x 16.3 x 16.9 mm
