korken89/kicad_libs/3dmodels/step/Ag9900LP.step

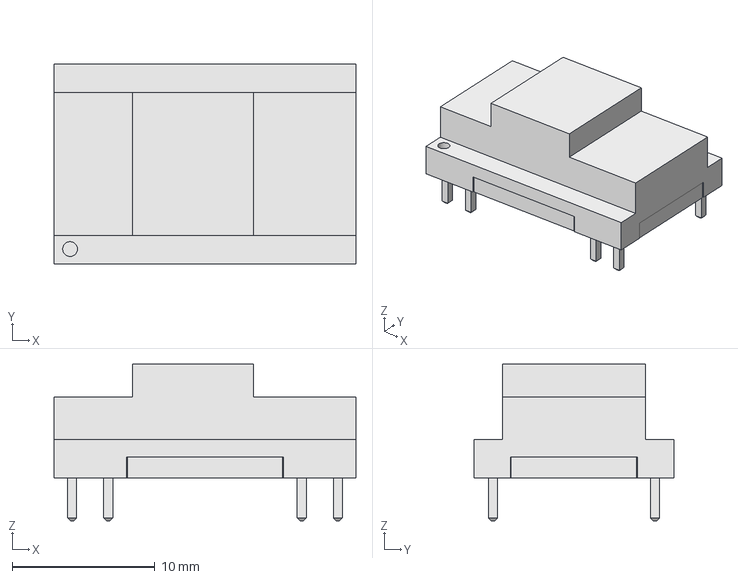
[picture p106: CAD file, 2019-02-15]
3dmodels/step/Ag9900LP.step
21.2 x 14.0 x 11.0 mm
