korken89/kicad_libs/3dmodels/step/Ag9900.step

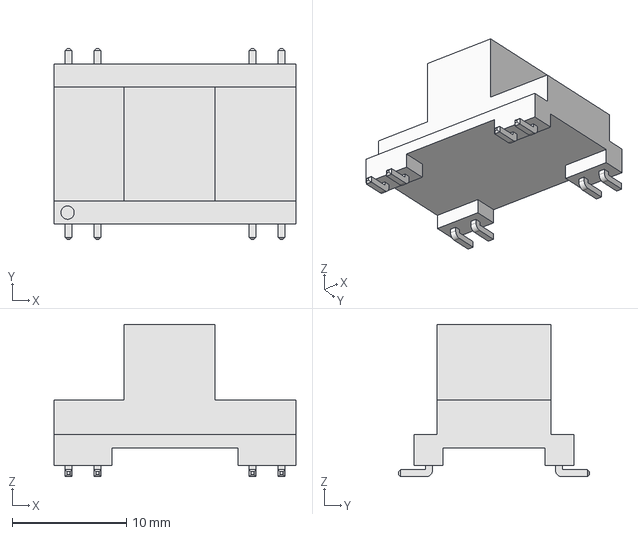
[picture p107: CAD file, 2019-02-15]
3dmodels/step/Ag9900.step
21.2 x 16.7 x 13.3 mm
