korken89/kicad_libs/3dmodels/step/ARJ-199.stp

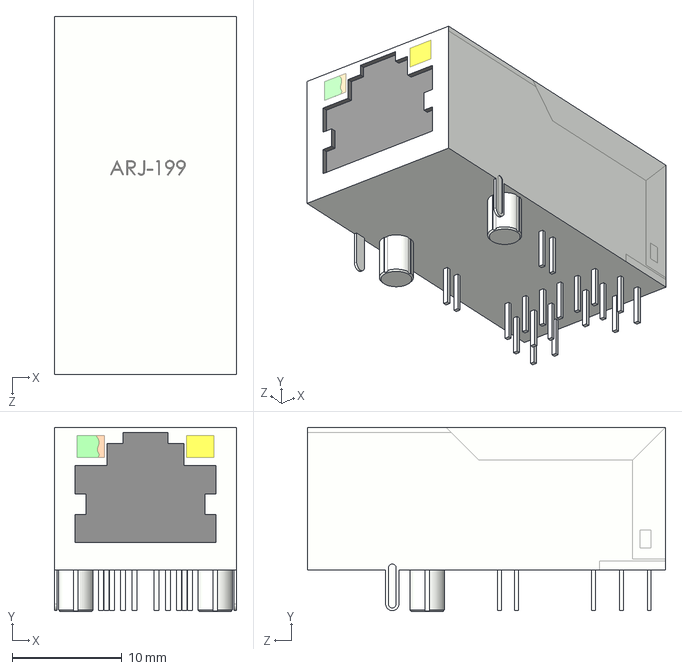
[picture p108: CAD file, 2019-02-15]
3dmodels/step/ARJ-199.stp
16.6 x 16.8 x 32.6 mm
