korken89/kicad_libs/3dmodels/step/DF40C-90DS.stp

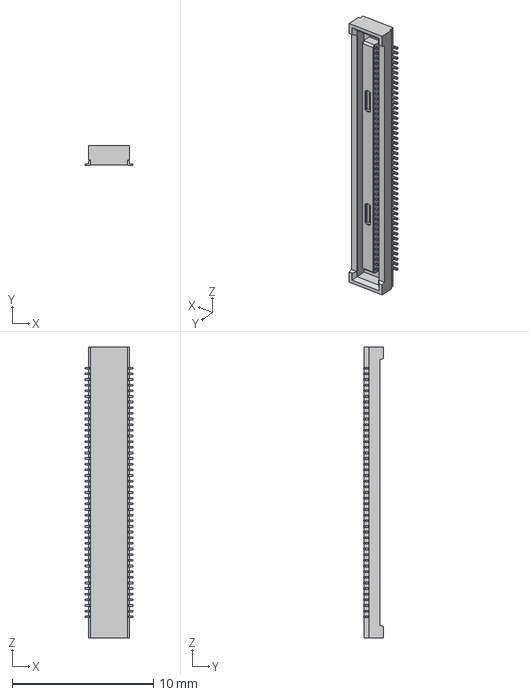
[picture p109: CAD file, 2019-02-01]
3dmodels/step/DF40C-90DS.stp
3.38 x 1.45 x 20.6 mm
