korken89/kicad_libs/3dmodels/step/ASPI-0630LR.STEP

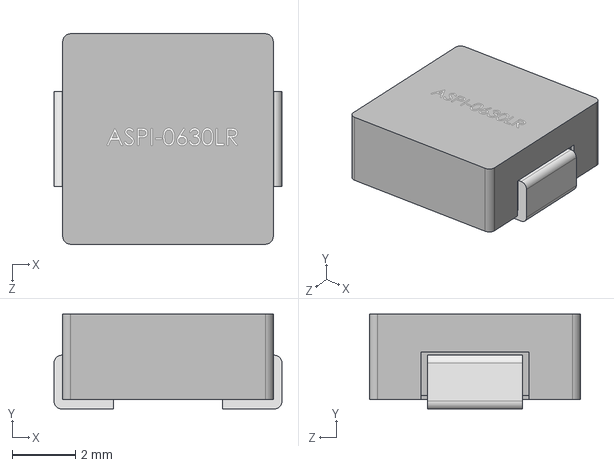
[picture p110: CAD file, 2019-01-08]
3dmodels/step/ASPI-0630LR.STEP
7.20 x 3.00 x 6.65 mm
