korken89/kicad_libs/3dmodels/step/kiss_esc_24a.step

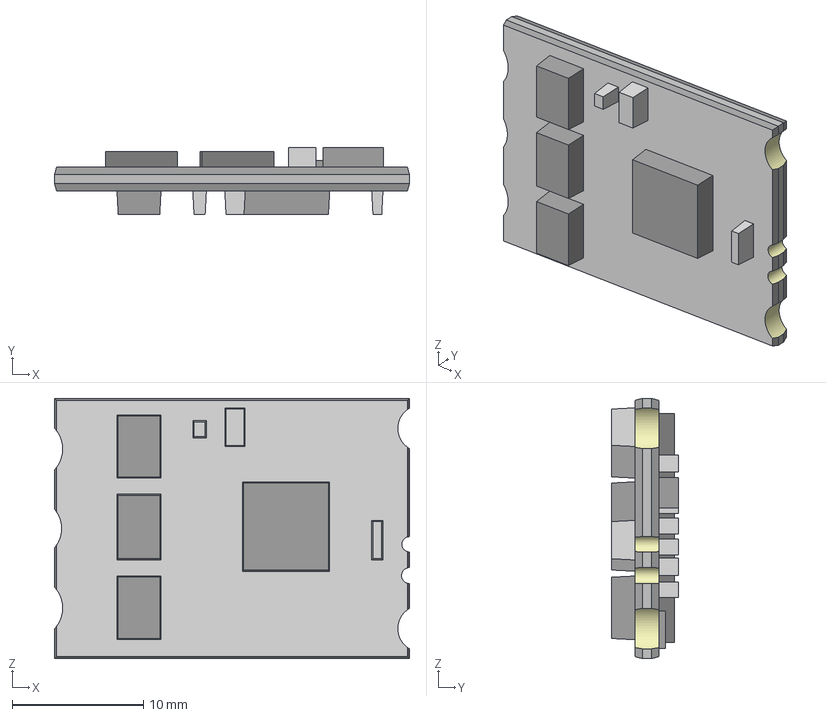
[picture p111: CAD file, 2018-09-09]
3dmodels/step/kiss_esc_24a.step
27.0 x 5.10 x 19.8 mm
