korken89/kicad_libs/3dmodels/step/SC70-6.step

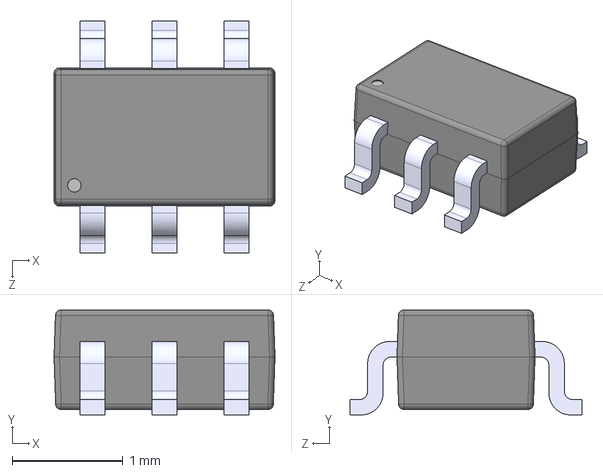
[picture p112: CAD file, 2018-06-08]
3dmodels/step/SC70-6.step
2.00 x 0.95 x 2.10 mm
