korken89/kicad_libs/3dmodels/step/dwm1001.step

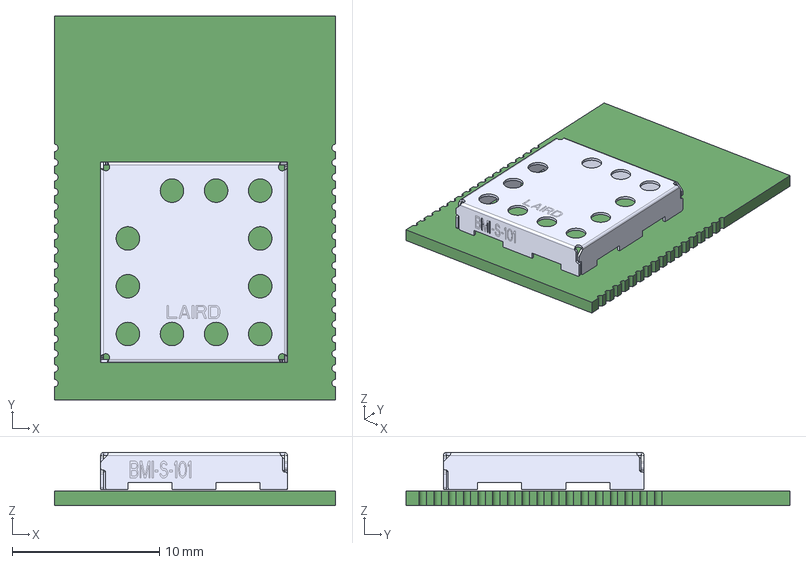
[picture p113: CAD file, 2018-05-29]
3dmodels/step/dwm1001.step
19.1 x 26.1 x 3.62 mm
