korken89/kicad_libs/3dmodels/step/Laird-BMI-S-101.STEP

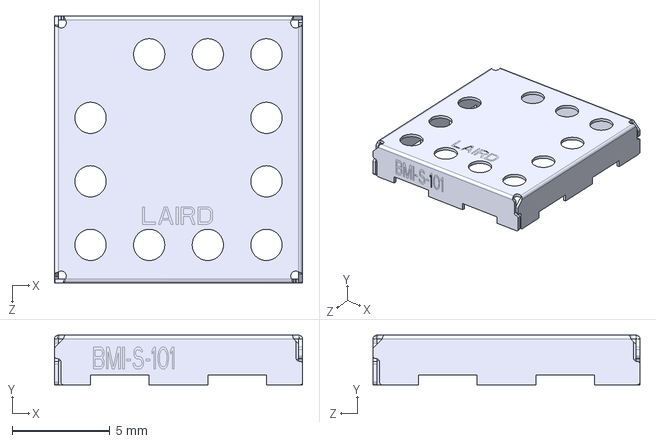
[picture p114: CAD file, 2018-05-29]
3dmodels/step/Laird-BMI-S-101.STEP
12.7 x 2.54 x 13.7 mm
