korken89/kicad_libs/3dmodels/step/RaspberryPiZeroW.STEP

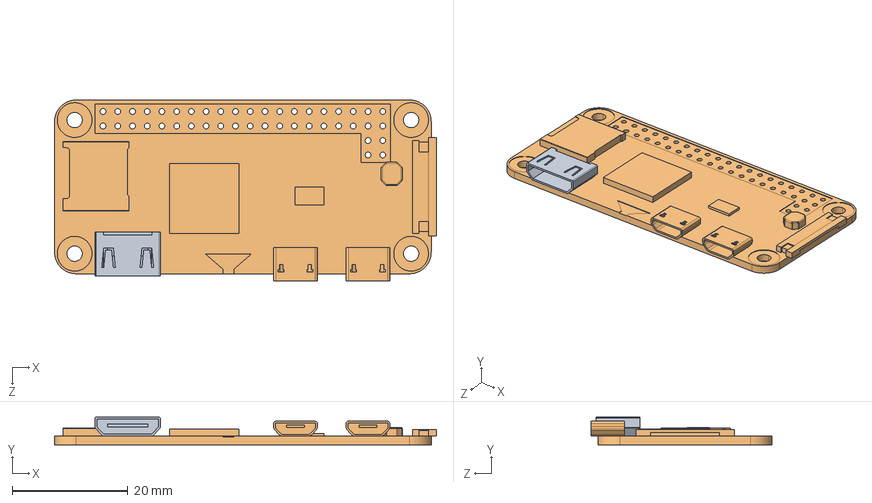
[picture p115: CAD file, 2018-05-25]
3dmodels/step/RaspberryPiZeroW.STEP
65.9 x 4.80 x 31.2 mm
