korken89/kicad_libs/3dmodels/step/BMP388.step

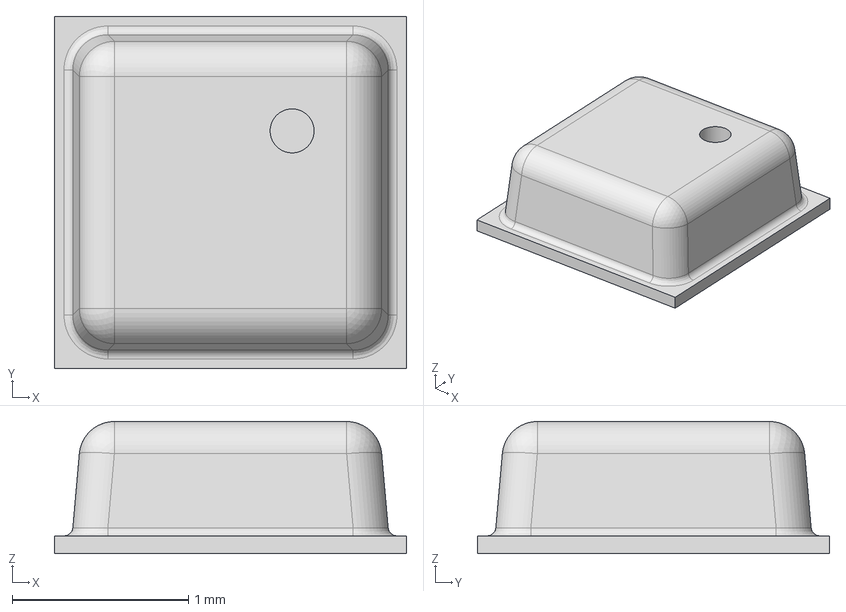
[picture p116: CAD file, 2018-04-22]
3dmodels/step/BMP388.step
2.00 x 2.00 x 0.75 mm
