korken89/kicad_libs/3dmodels/step/DFN-8-2x3mm.step

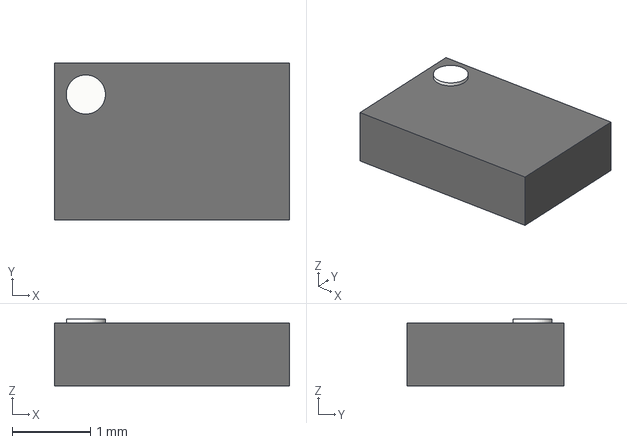
[picture p117: CAD file, 2018-04-22]
3dmodels/step/DFN-8-2x3mm.step
3.00 x 2.00 x 0.85 mm
