korken89/kicad_libs/3dmodels/step/LGA-14-2.5x3.step

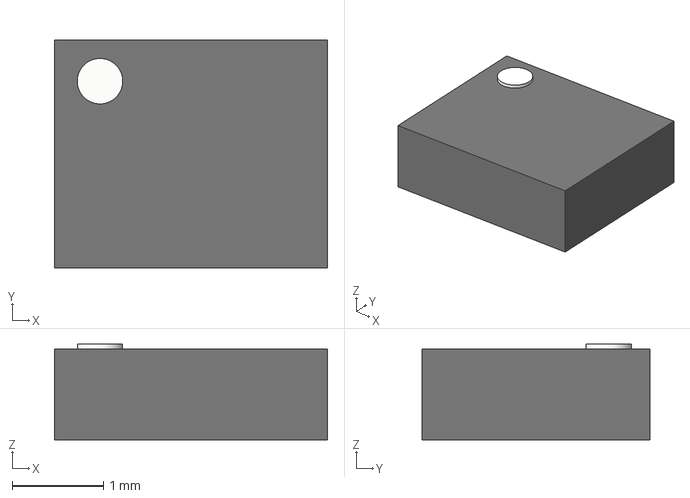
[picture p118: CAD file, 2018-04-22]
3dmodels/step/LGA-14-2.5x3.step
3.00 x 2.50 x 1.05 mm
