korken89/kicad_libs/3dmodels/step/DFN-6-1EP_1.6x1.6mm_P0.5mm_EP0.5x1.26mm.step

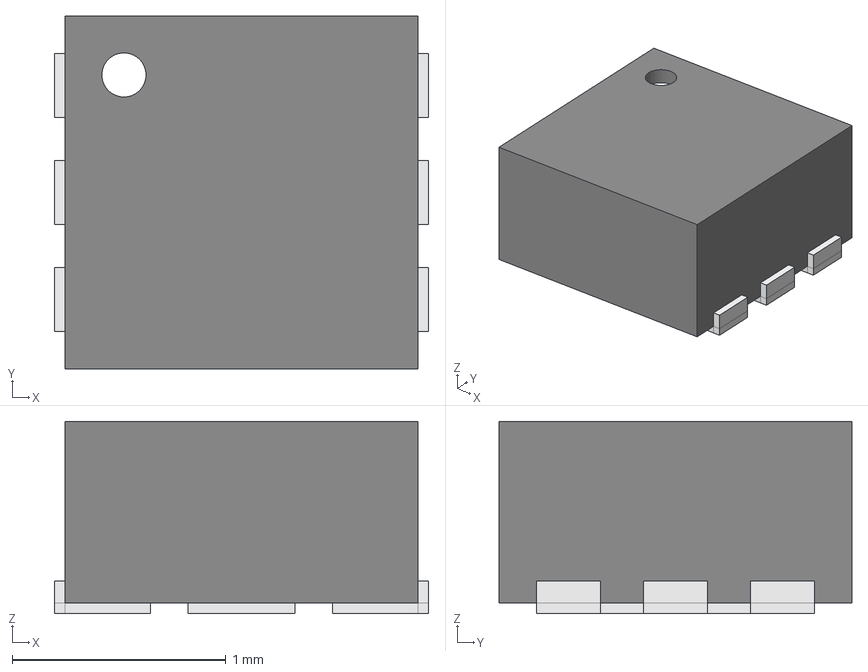
[picture p119: CAD file, 2018-04-22]
3dmodels/step/DFN-6-1EP_1.6x1.6mm_P0.5mm_EP0.5x1.26mm.step
1.75 x 1.65 x 0.9 mm
Open_CASCADE_STEP_translator_6.8_12.1
Open_CASCADE_STEP_translator_6.8_12.2.1
Thermal_Shape
Open_CASCADE_STEP_translator_6.8_12.4.1 x 6
