korken89/kicad_libs/3dmodels/step/HLGA-10-2x2mm.step

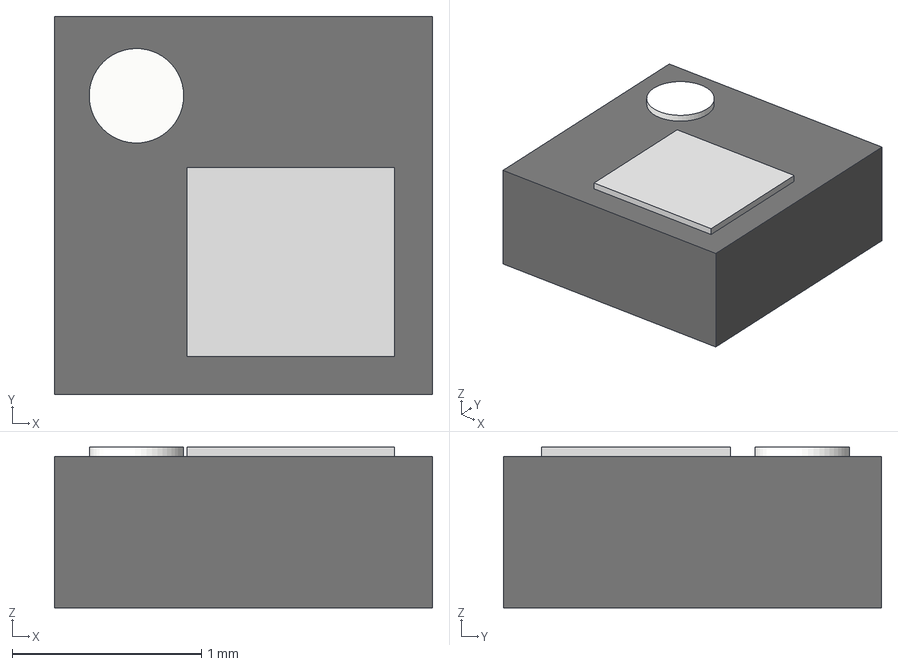
[picture p120: CAD file, 2018-04-22]
3dmodels/step/HLGA-10-2x2mm.step
2.00 x 2.00 x 0.85 mm
