korken89/kicad_libs/3dmodels/step/HLGA-10-2.5x2.5mm.step

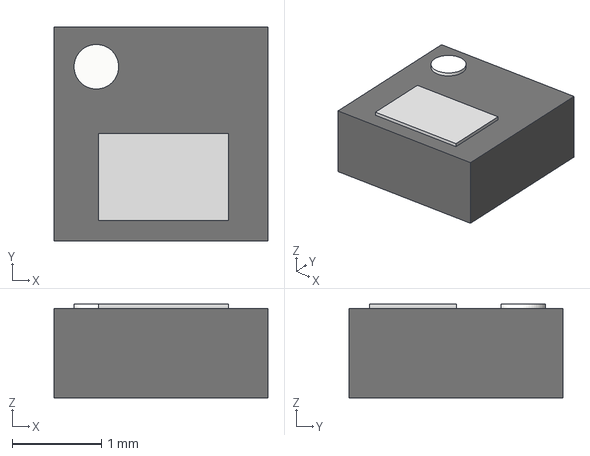
[picture p121: CAD file, 2018-04-22]
3dmodels/step/HLGA-10-2.5x2.5mm.step
2.40 x 2.40 x 1.05 mm
