korken89/kicad_libs/3dmodels/step/wb001.stp

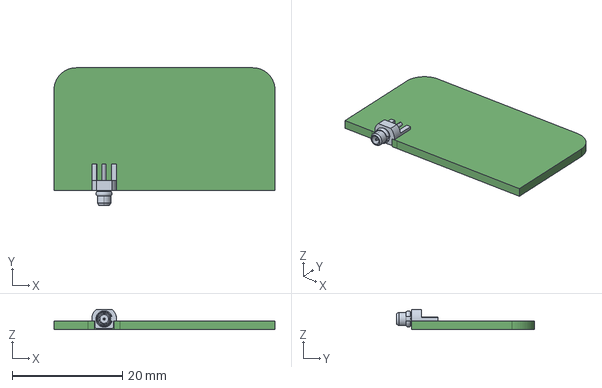
[picture p122: CAD file, 2018-04-15]
3dmodels/step/wb001.stp
40.1 x 24.9 x 3.70 mm
