korken89/kicad_libs/3dmodels/step/uwb-chip-antenna.step

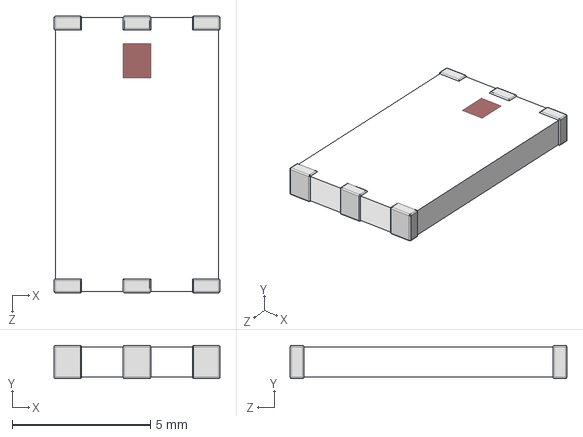
[picture p123: CAD file, 2018-04-10]
3dmodels/step/uwb-chip-antenna.step
6.00 x 1.20 x 10.0 mm
