korken89/kicad_libs/3dmodels/step/PYTHONxxxx.step

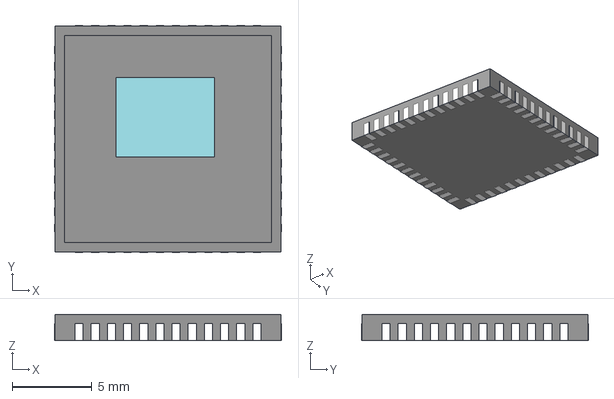
[picture p124: CAD file, 2018-03-30]
3dmodels/step/PYTHONxxxx.step
14.3 x 14.3 x 1.66 mm
