korken89/kicad_libs/3dmodels/step/Inductor SRN3015 Series.step

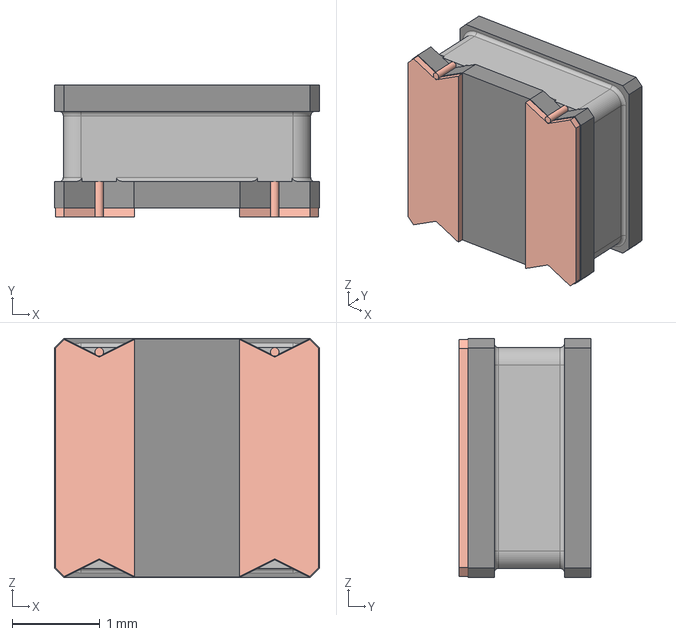
[picture p125: CAD file, 2018-03-30]
3dmodels/step/Inductor SRN3015 Series.step
3.02 x 1.50 x 2.72 mm
