korken89/kicad_libs/3dmodels/step/2.1mm_DC_Power_Socket.step

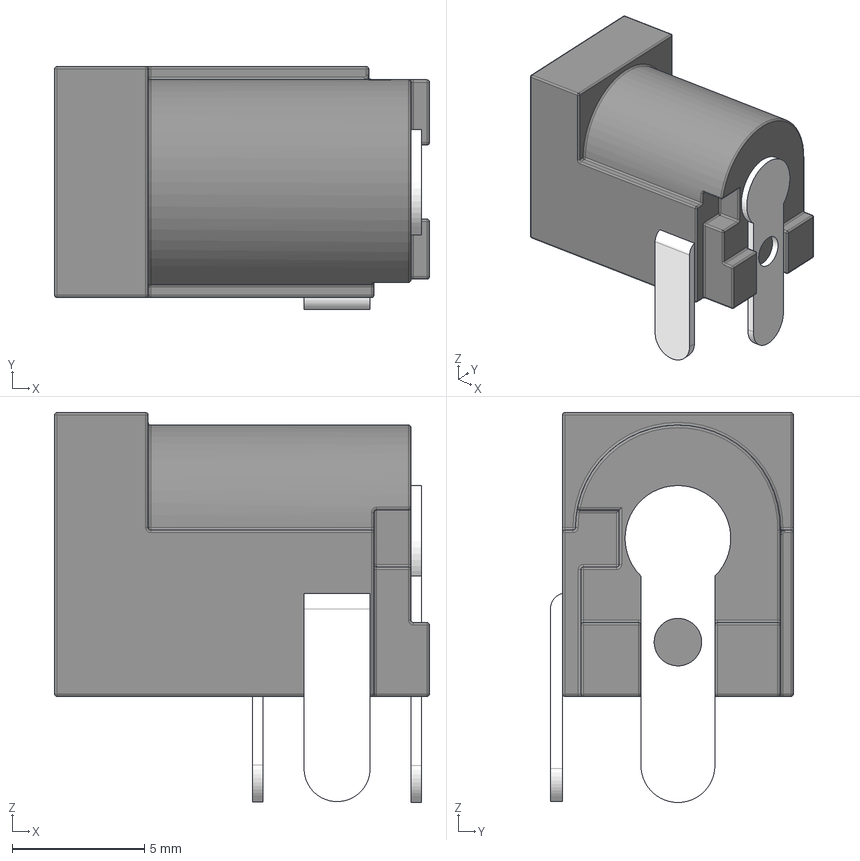
[picture p126: CAD file, 2018-03-30]
3dmodels/step/2.1mm_DC_Power_Socket.step
14.2 x 9.20 x 14.8 mm
2.1mm DC Power Socket Housing
2.1mm DC Power Socket Pin
Terminal 1
Terminal 2
Terminal 3
