korken89/kicad_libs/3dmodels/step/mt9v034.stp

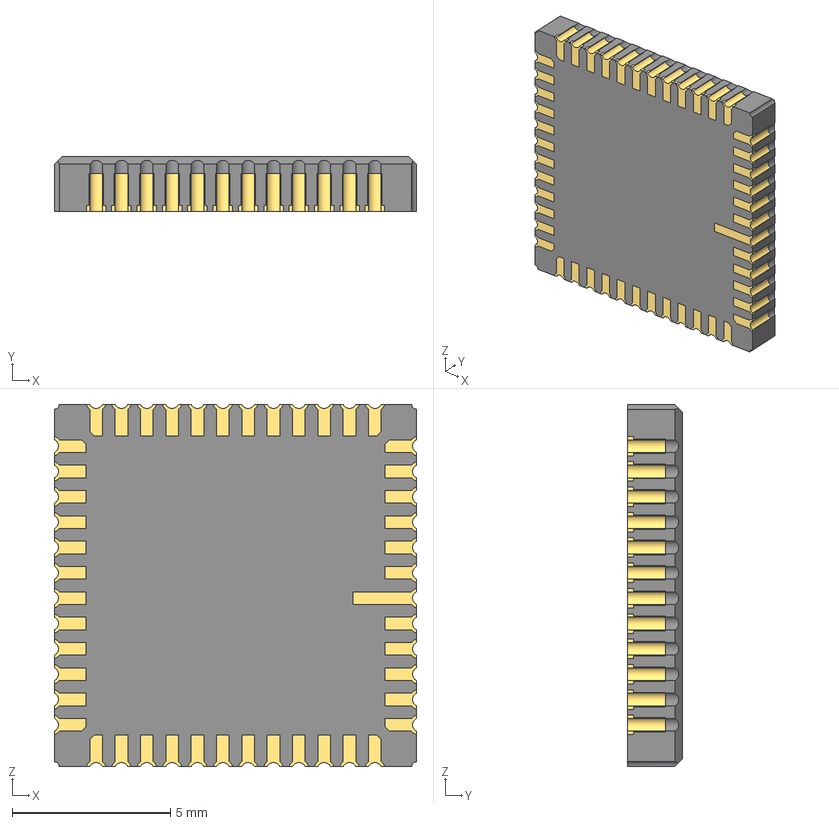
[picture p127: CAD file, 2018-03-30]
3dmodels/step/mt9v034.stp
11.4 x 1.75 x 11.4 mm
chip
legs
