korken89/kicad_libs/3dmodels/step/mti-1.step

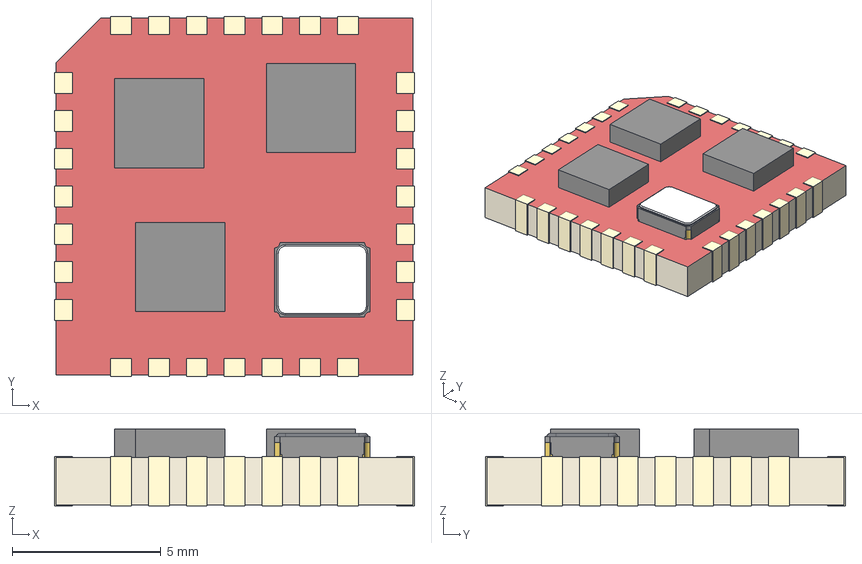
[picture p128: CAD file, 2018-03-30]
3dmodels/step/mti-1.step
12.1 x 12.1 x 2.58 mm
base
legs
