korken89/kicad_libs/3dmodels/step/jst8-sh_smd.step

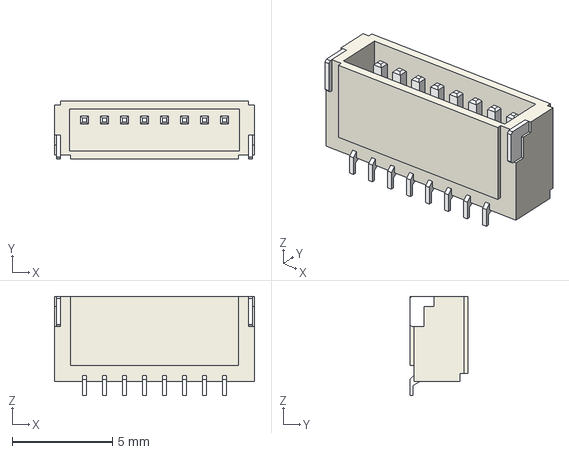
[picture p129: CAD file, 2018-03-30]
3dmodels/step/jst8-sh_smd.step
10.0 x 2.90 x 4.95 mm
jst4_house
metal
