korken89/kicad_libs/3dmodels/step/xt60_male.step

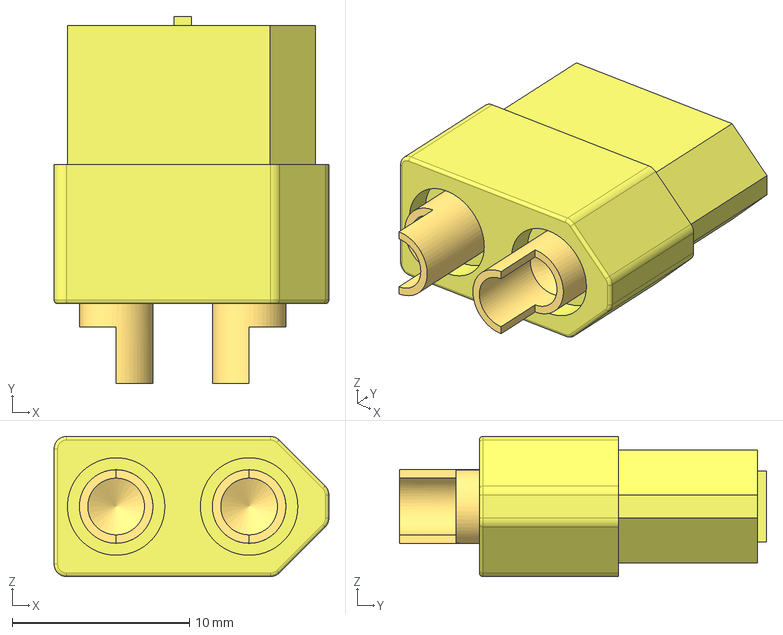
[picture p130: CAD file, 2018-03-30]
3dmodels/step/xt60_male.step
15.5 x 20.7 x 7.90 mm
plastic_m
pins_bot
