korken89/kicad_libs/3dmodels/step/xt60_female.stp

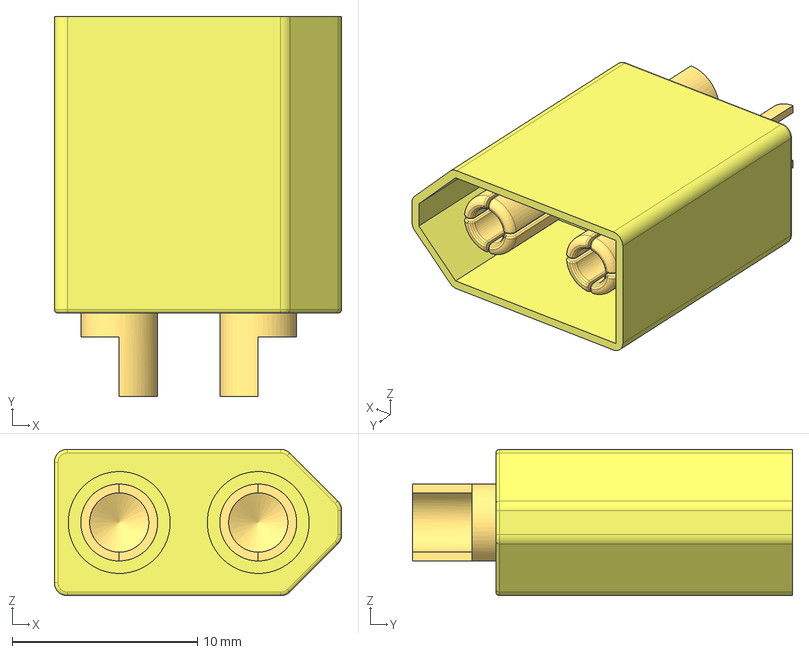
[picture p131: CAD file, 2018-03-30]
3dmodels/step/xt60_female.stp
15.5 x 20.5 x 7.90 mm
plastic_f
pins_f
pins_bot
