korken89/kicad_libs/3dmodels/step/Inductor SRN8040 Series.step

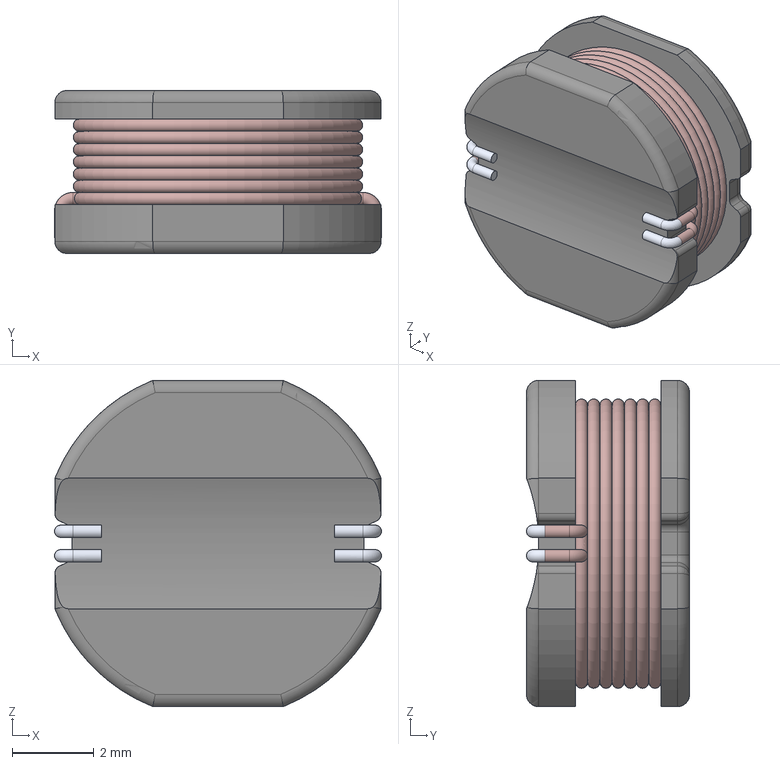
[picture p133: CAD file, 2018-03-30]
3dmodels/step/Inductor SRN8040 Series.step
8.02 x 4.00 x 8.00 mm
