korken89/kicad_libs/3dmodels/step/Switch-CK-KMR2.STEP

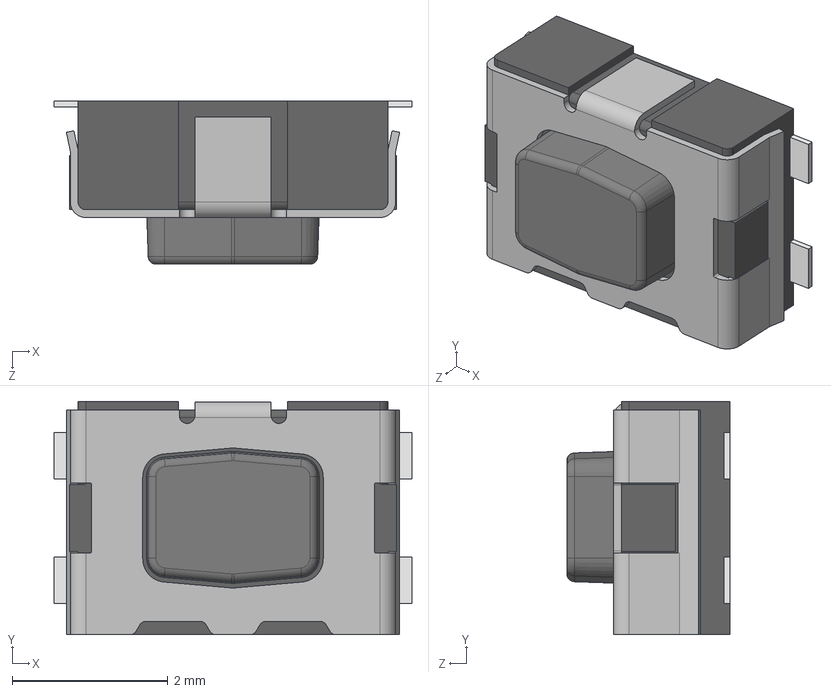
[picture p135: CAD file, 2018-03-30]
3dmodels/step/Switch-CK-KMR2.STEP
4.60 x 3.00 x 2.10 mm
User Library-Switch-CK-KMR2_Button
User Library-Switch-CK-KMR2_Boitier
User Library-Switch-CK-KMR2_Tole
User Library-Switch-CK-KMR2_Pads
