korken89/kicad_libs/3dmodels/step/SM05B-GHS-TB.step

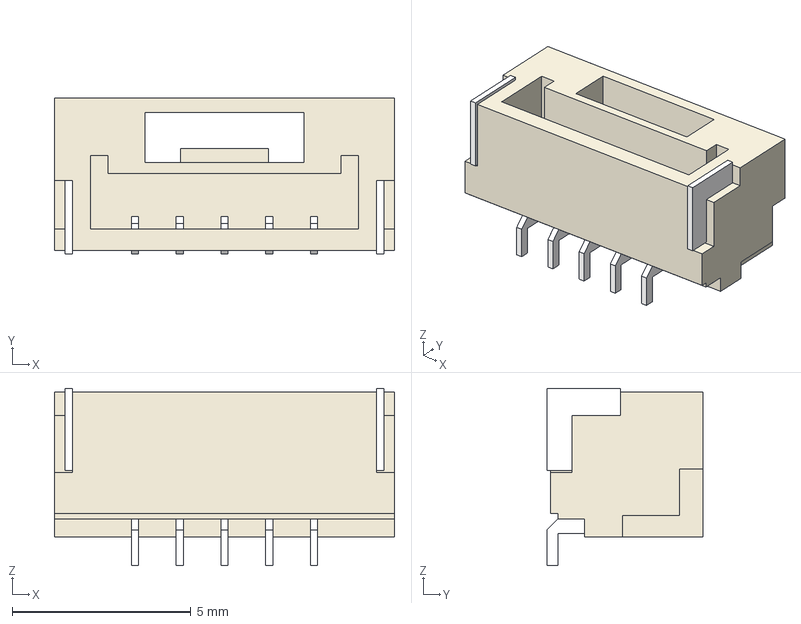
[picture p136: CAD file, 2018-03-30]
3dmodels/step/SM05B-GHS-TB.step
9.50 x 4.35 x 4.95 mm
