korken89/kicad_libs/3dmodels/step/SM06B-GHS-TB.step

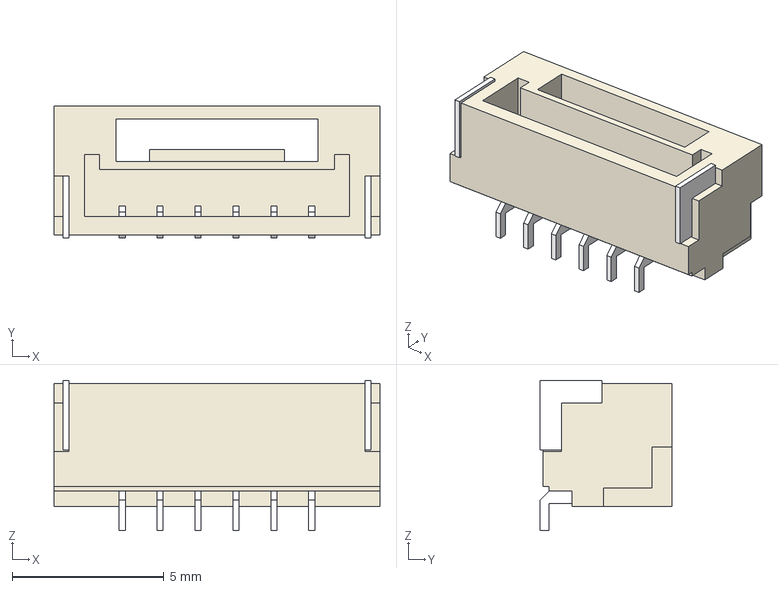
[picture p137: CAD file, 2018-03-30]
3dmodels/step/SM06B-GHS-TB.step
10.8 x 4.35 x 4.95 mm
