korken89/kicad_libs/3dmodels/step/LXDC2HL.step

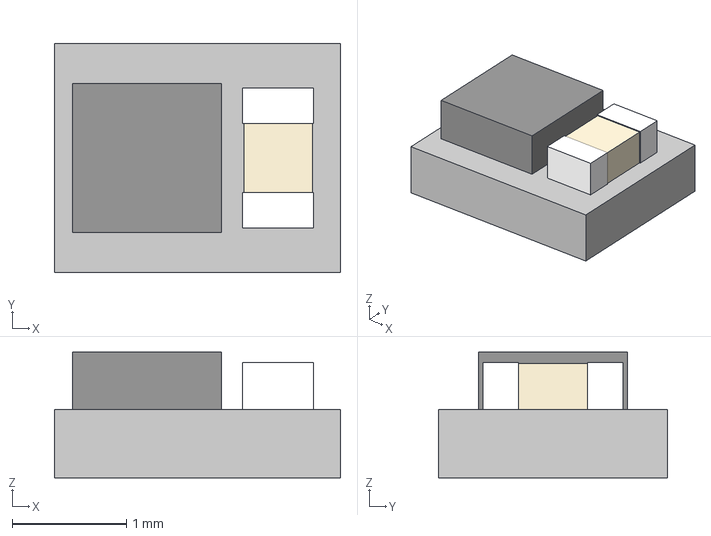
[picture p138: CAD file, 2018-03-30]
3dmodels/step/LXDC2HL.step
2.50 x 2.00 x 1.10 mm
