korken89/kicad_libs/3dmodels/step/LED_0603_B.STEP

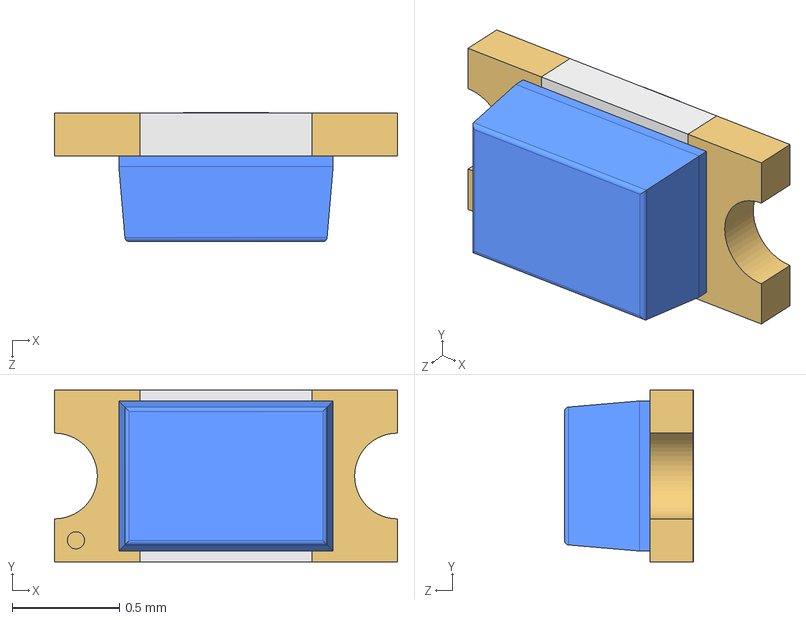
[picture p139: CAD file, 2018-03-30]
3dmodels/step/LED_0603_B.STEP
1.60 x 0.8 x 0.602 mm
User Library-LED_0603_B_Pocket002
User Library-LED_0603_B_Pad004
User Library-LED_0603_B_Fillet
User Library-LED_0603_B_Pocket001
User Library-LED_0603_B_Pad
