korken89/kicad_libs/3dmodels/step/crystal_2520.step

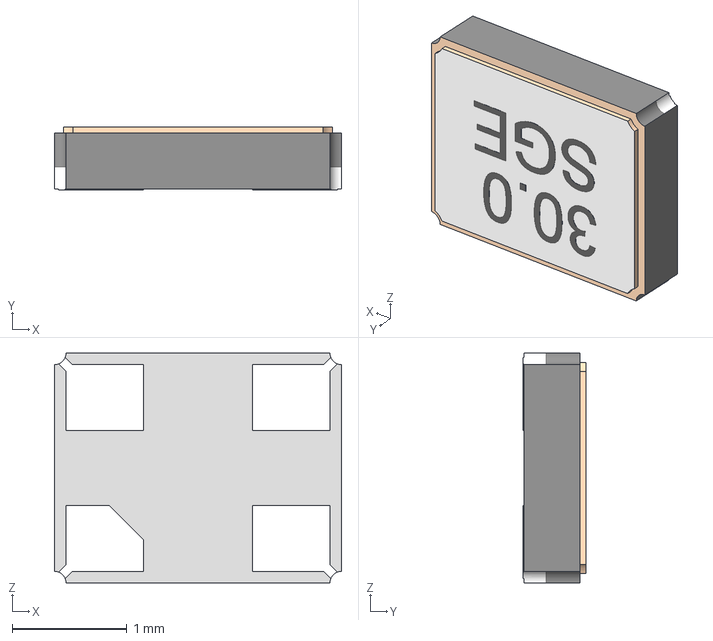
[picture p140: CAD file, 2018-03-30]
3dmodels/step/crystal_2520.step
2.50 x 0.552 x 2.00 mm
