korken89/kicad_libs/3dmodels/step/SM03B-GHS-TB.step

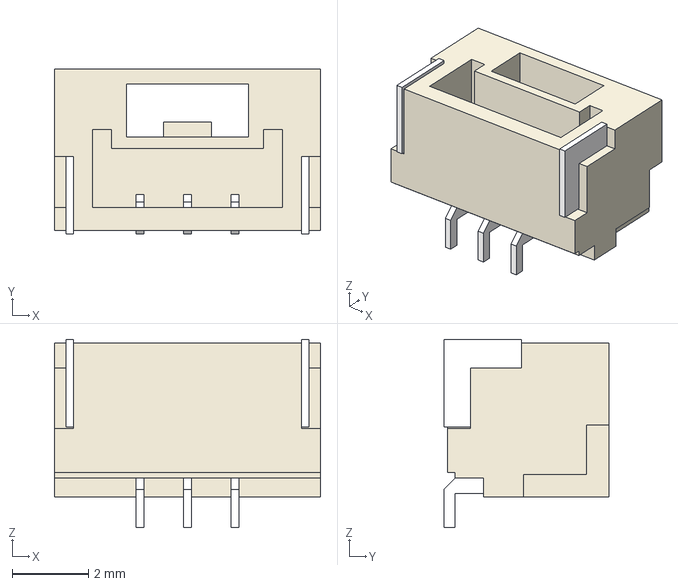
[picture p141: CAD file, 2018-03-30]
3dmodels/step/SM03B-GHS-TB.step
7.00 x 4.35 x 4.95 mm
