korken89/kicad_libs/3dmodels/step/SM08B-GHS-TB.step

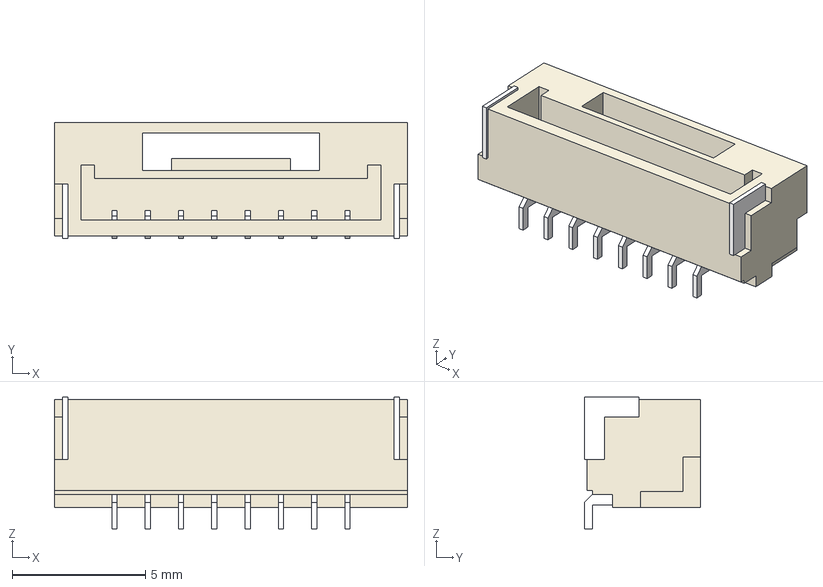
[picture p142: CAD file, 2018-03-30]
3dmodels/step/SM08B-GHS-TB.step
13.2 x 4.35 x 4.95 mm
