korken89/kicad_libs/3dmodels/step/crystal_3225.step

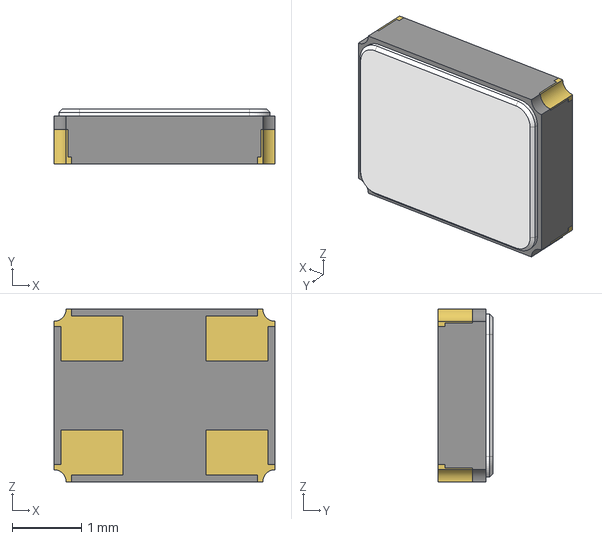
[picture p143: CAD file, 2018-03-30]
3dmodels/step/crystal_3225.step
3.20 x 0.8 x 2.50 mm
legs
