korken89/kicad_libs/3dmodels/step/SM02B-GHS-TB.step

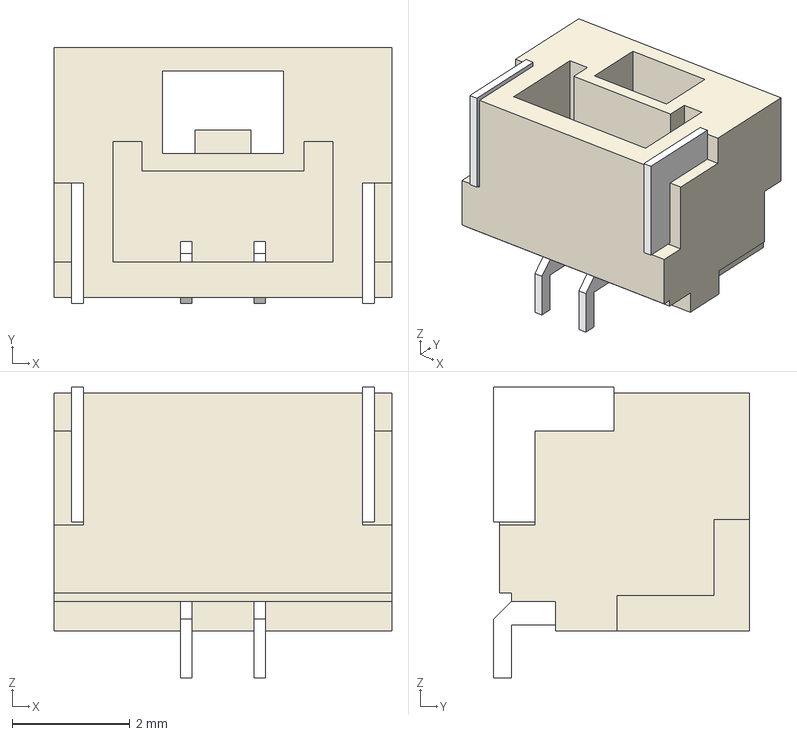
[picture p144: CAD file, 2018-03-30]
3dmodels/step/SM02B-GHS-TB.step
5.75 x 4.35 x 4.95 mm
