korken89/kicad_libs/3dmodels/step/uwb_antenna.stp

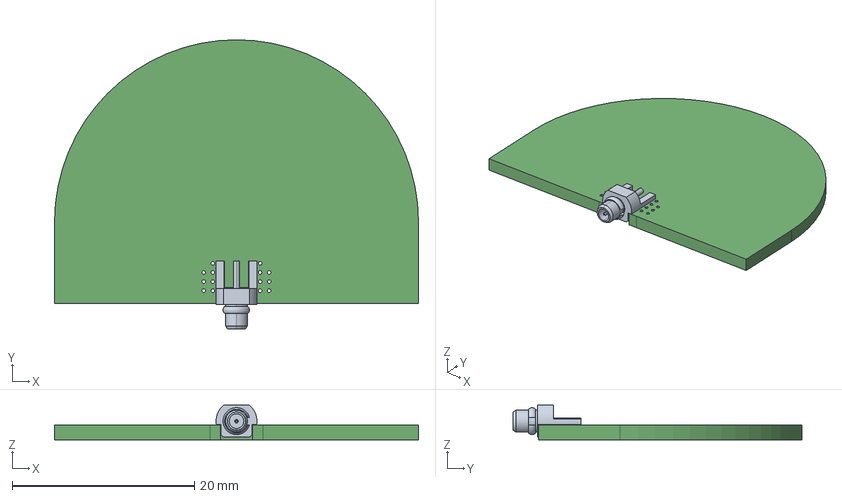
[picture p145: CAD file, 2018-03-30]
3dmodels/step/uwb_antenna.stp
40.0 x 31.8 x 3.80 mm
