korken89/kicad_libs/3dmodels/step/HHM1595A1.step

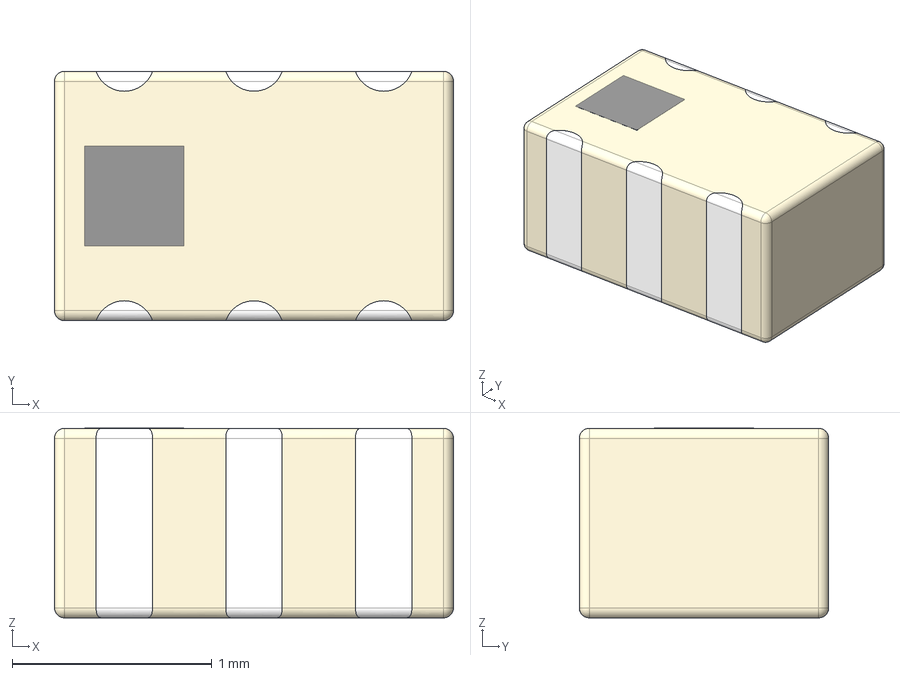
[picture p146: CAD file, 2018-03-30]
3dmodels/step/HHM1595A1.step
2.00 x 1.25 x 0.951 mm
leg x 6
