korken89/kicad_libs/3dmodels/step/BM04B-SRSS-TB.STEP

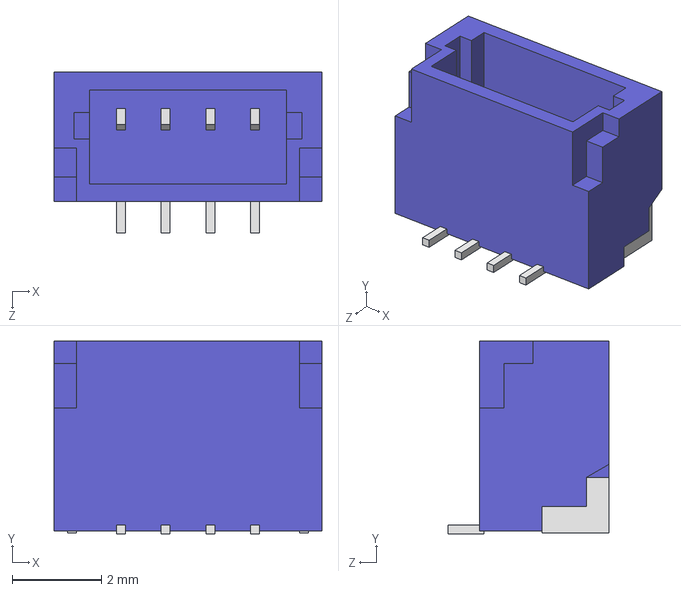
[picture p147: CAD file, 2018-03-30]
3dmodels/step/BM04B-SRSS-TB.STEP
6.00 x 4.32 x 3.60 mm
