korken89/kicad_libs/3dmodels/step/SM04B-GHS-TB.step

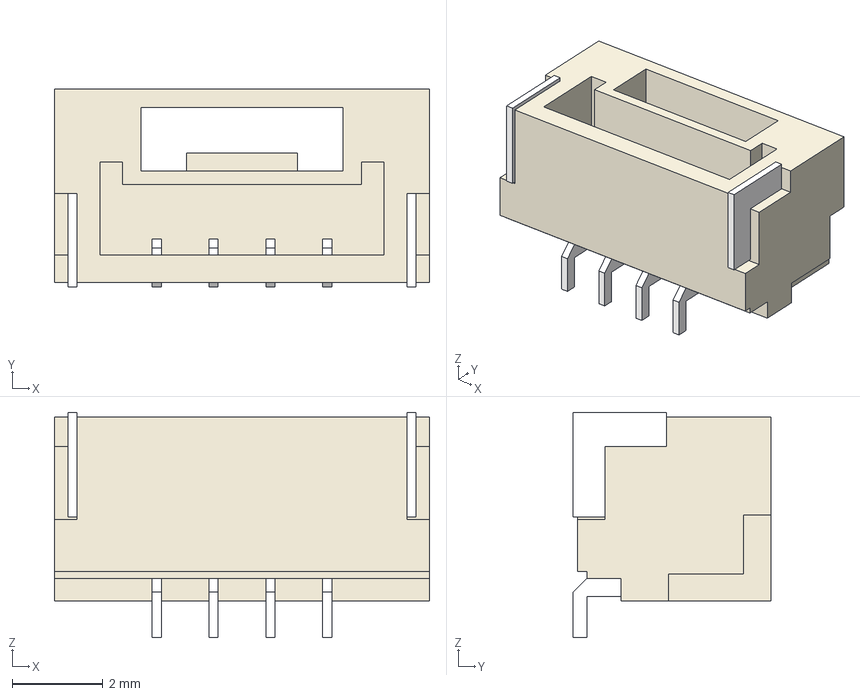
[picture p148: CAD file, 2018-03-30]
3dmodels/step/SM04B-GHS-TB.step
8.25 x 4.35 x 4.95 mm
