korken89/kicad_libs/3dmodels/step/MicroUSB-B_Molex_105017-0001.step

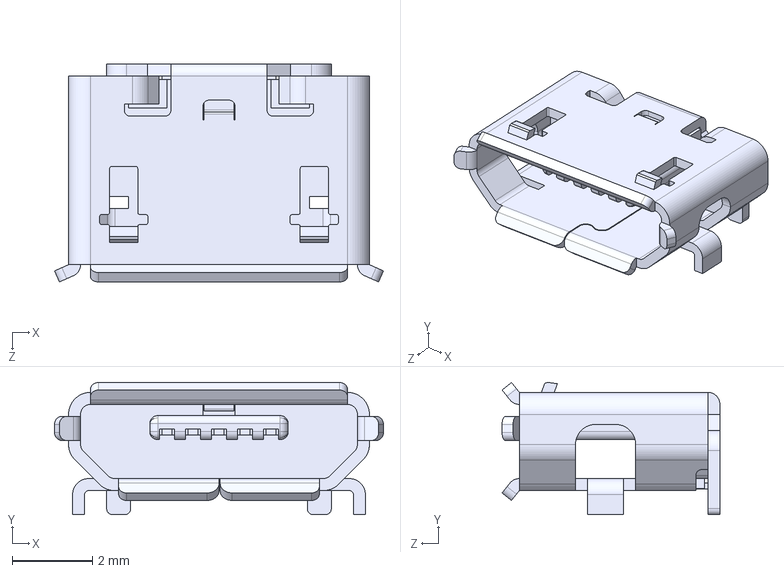
[picture p149: CAD file, 2018-03-30]
3dmodels/step/MicroUSB-B_Molex_105017-0001.step
8.20 x 3.30 x 5.43 mm
