korken89/kicad_libs/3dmodels/step/TL3330AFxxxQG.stp

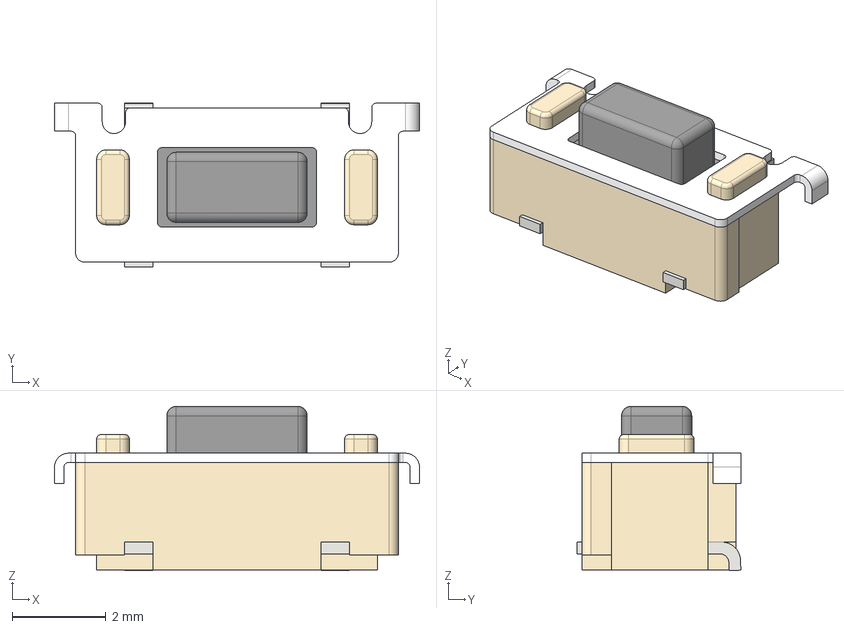
[picture p150: CAD file, 2018-03-30]
3dmodels/step/TL3330AFxxxQG.stp
7.80 x 3.50 x 3.51 mm
TL3330 Housing
TL3330 Cover Plate
TL3330 Actuator
