korken89/kicad_libs/3dmodels/step/USB3150-30-130-X_revA.STEP

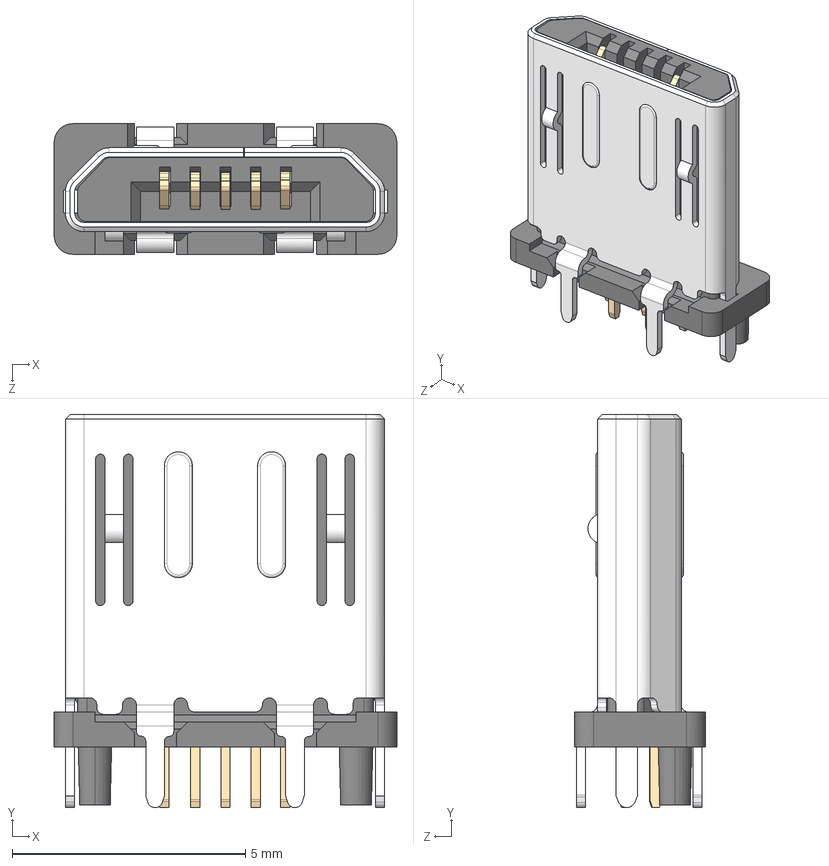
[picture p151: CAD file, 2018-03-30]
3dmodels/step/USB3150-30-130-X_revA.STEP
7.35 x 8.43 x 2.80 mm
HOUSING
CONTACT
CONTACT-1
CONTACT stack=1.3mm
PRT0004
PRT0005
PRT0006
