korken89/kicad_libs/3dmodels/step/SM07B-GHS-TB.step

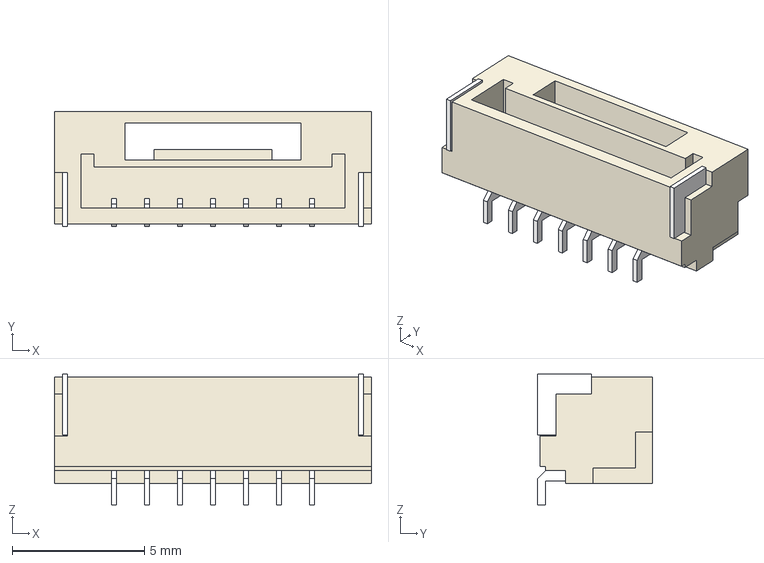
[picture p152: CAD file, 2018-03-30]
3dmodels/step/SM07B-GHS-TB.step
12.0 x 4.35 x 4.95 mm
