korken89/kicad_libs/3dmodels/step/crystal_2016.step

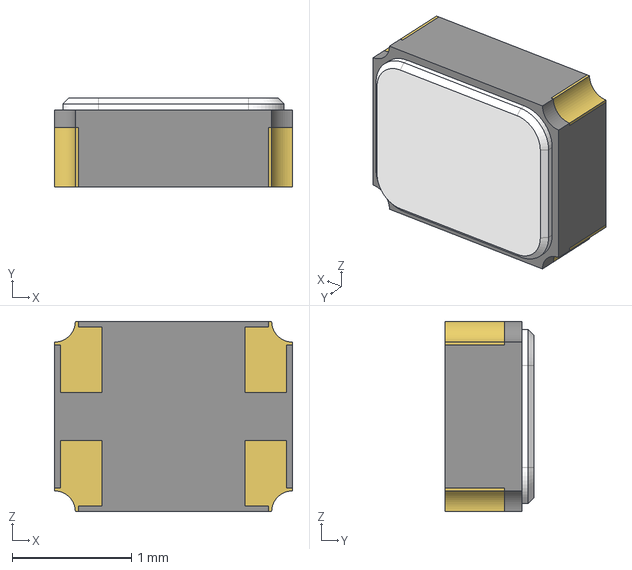
[picture p153: CAD file, 2018-03-30]
3dmodels/step/crystal_2016.step
2.00 x 0.75 x 1.60 mm
legs
