korken89/kicad_libs/3dmodels/step/wfm1000.stp

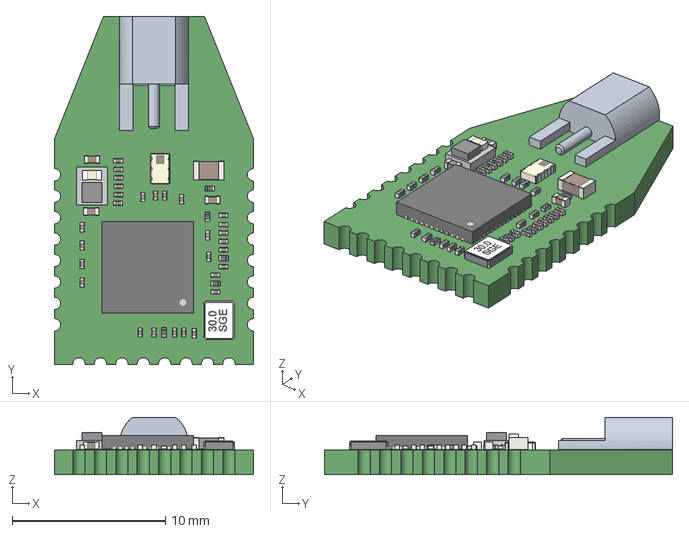
[picture p154: CAD file, 2018-03-30]
3dmodels/step/wfm1000.stp
13.0 x 22.8 x 3.75 mm
