korken89/kicad_libs/3dmodels/step/1001-011-01101.step

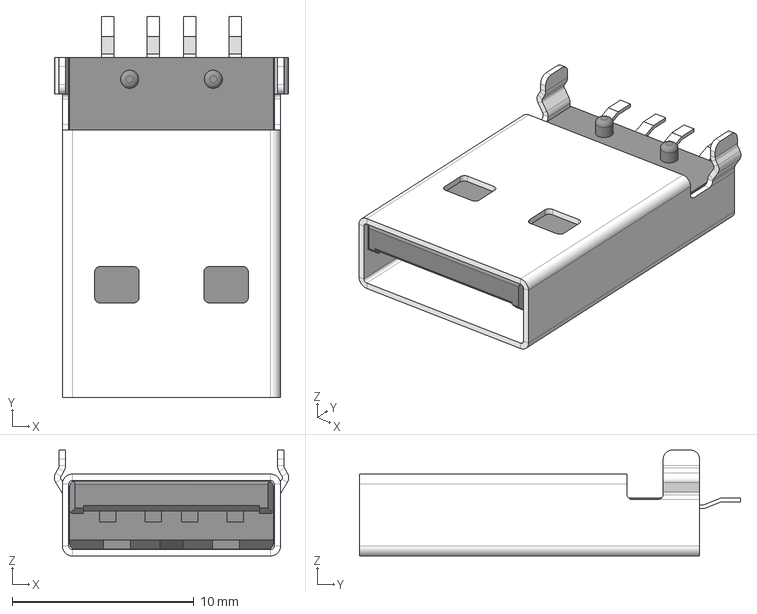
[picture p155: CAD file, 2018-03-30]
3dmodels/step/1001-011-01101.step
12.9 x 21.0 x 5.82 mm
