korken89/kicad_libs/3dmodels/step/DFN16_4x1.6mm_0.5P.step

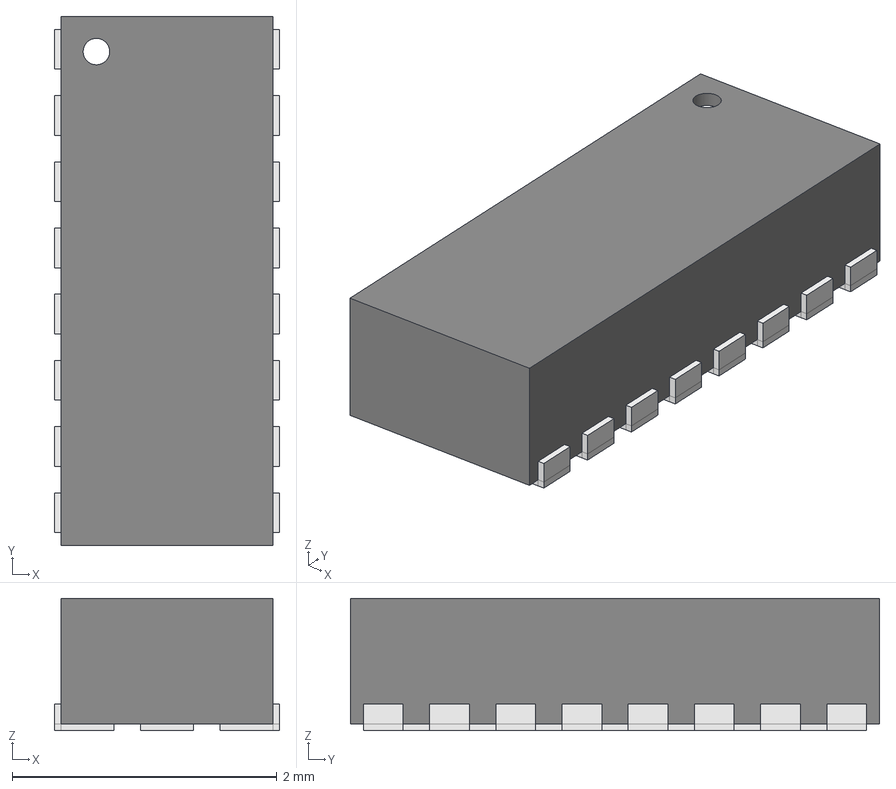
[picture p156: CAD file, 2018-03-30]
3dmodels/step/DFN16_4x1.6mm_0.5P.step
1.70 x 4.00 x 1.00 mm
Open_CASCADE_STEP_translator_6.8_22.1
Open_CASCADE_STEP_translator_6.8_22.2.1
Thermal_Shape
Open_CASCADE_STEP_translator_6.8_22.4.1 x 16
