korken89/kicad_libs/3dmodels/step/resonator_CSTCE.stp

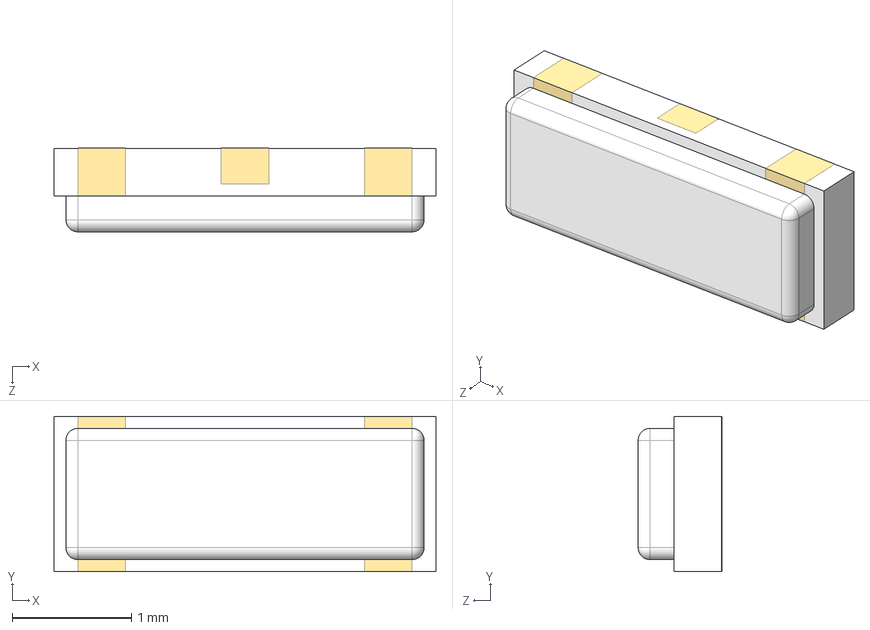
[picture p157: CAD file, 2018-03-30]
3dmodels/step/resonator_CSTCE.stp
3.20 x 1.30 x 0.701 mm
