korken89/kicad_libs/3dmodels/step/SOT563.step

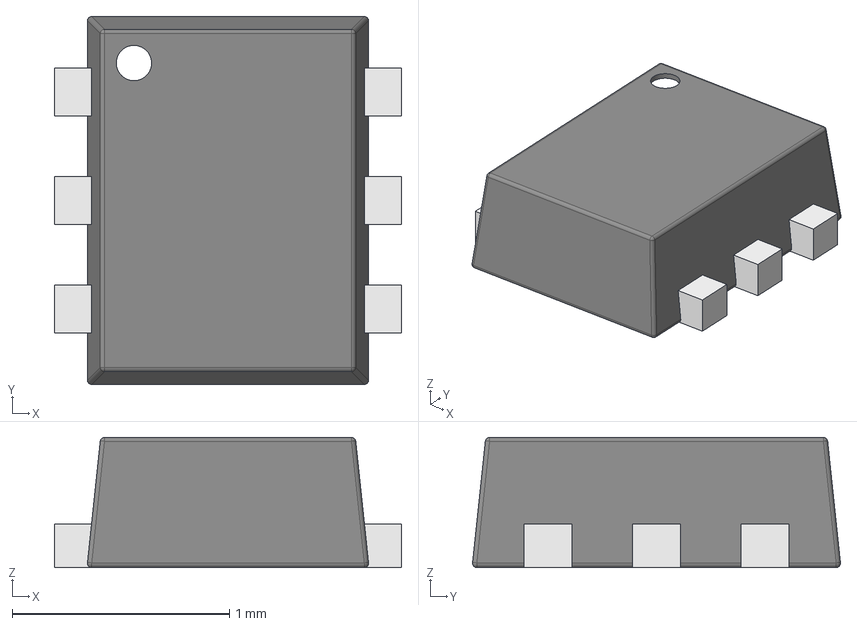
[picture p158: CAD file, 2018-03-30]
3dmodels/step/SOT563.step
1.60 x 1.70 x 0.6 mm
Open_CASCADE_STEP_translator_6.8_6.1
Open_CASCADE_STEP_translator_6.8_6.2.1
lead x 6
