korken89/kicad_libs/3dmodels/step/CUI_UP2-AH-1-TH.step

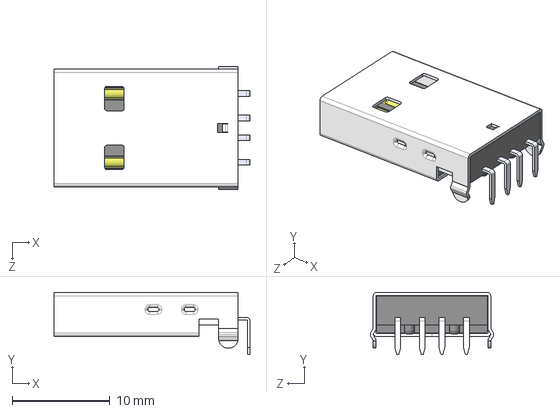
[picture p159: CAD file, 2018-03-30]
3dmodels/step/CUI_UP2-AH-1-TH.step
20.0 x 6.35 x 12.6 mm
