korken89/kicad_libs/(list of files, cad)

Other CAD files:
3dmodels/step/LED_0603_G.STEP
3dmodels/step/LED_0603_R.STEP
3dmodels/step/00012066 - top.step
3dmodels/step/0001206A - bottom.step
3dmodels/step/10061913-102PLF.step
3dmodels/step/1054440001.stp
3dmodels/step/12401880.stp
3dmodels/step/155124M173200.step
3dmodels/step/2171760001.stp
3dmodels/step/430481025816_button.stp
3dmodels/step/5051102291.step
3dmodels/step/615008144221.step
3dmodels/step/634108150321.step
3dmodels/step/734150963.stp
3dmodels/step/734150991.stp
3dmodels/step/749013011A.stp
3dmodels/step/750317234.step
3dmodels/step/GSB422137EU.step
3dmodels/step/MBN52832.STEP
3dmodels/step/P822601.step
3dmodels/step/PT61020L.stp
3dmodels/step/SKY65943-11.step
3dmodels/step/SM453229-381N7Y.stp
3dmodels/step/s54601-908wplf.stp
