korken89/kicad_libs/pcb_templates/uwb_wb001/wb001.sch

## KiCad design pcb_templates/uwb_wb001/wb001.sch (2018-07-17)

Schematic: wb001.sch

Parts:
AE101: Antenna
J101: MMCX, plug; Molex-LLC-MMCX-EDGE-1.6mm-plug; MPN 0734150991
