korken89/kicad_libs/(commit log)

2018-03-30 Added krille files
    [1001-011-01101.step, 734150963.stp, 734150991.stp, BM04B-SRSS-TB.STEP, CUI_UP2-AH-1-TH.step, DFN16_4x1.6mm_0.5P.step, HHM1595A1.step, LED_0603_B.STEP]
2018-03-30 More 3D models
    [2.1mm_DC_Power_Socket.step, Inductor SRN3015 Series.step, Inductor SRN8040 Series.step, PYTHONxxxx.step, SM02B-GHS-TB.step, SM03B-GHS-TB.step, SM04B-GHS-TB.step, SM04B-SRSS-TB.STEP]
2018-03-31 Added resistor array, a lot of minor fixing to libs (lines, text, ...)
2018-03-31 Updated LED1608X60
2018-04-01 Fixed through holes on USB connector to be NPTH
2018-04-02 Improved resistor array pad sizes
2018-04-03 added footprint for mbn525832 and 3dmodel
    [MBN52832.STEP]
2018-04-06 Started adding Acconeer footprint
2018-04-10 Fixed uwb chip antenna slightly
    [uwb-chip-antenna.step]
2018-04-11 rounded pads, added 3d model to footprint
2018-04-15 added a pcb_templates folder, where projects that can be useful to copy-paste stuff from can be put
    [TAG_DecaWave_WB001_btm_layer.dxf, TAG_DecaWave_WB001_top_layer.dxf, wb001.kicad_pcb, wb001.sch, wb001.stp, wb001_largest.kicad_pcb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]
2018-04-15 added new regulator
2018-04-22 Fixed a few LGA footprints, added 3D models to them, added DFN-6 model
    [DFN-6-1EP_1.6x1.6mm_P0.5mm_EP0.5x1.26mm.step, HLGA-10-2.5x2.5mm.step, HLGA-10-2x2mm.step]
2018-04-22 Split div-sensors into barometers and magnetometers
2018-04-22 Updated LGA-14 with 3D model
    [LGA-14 2_5x3-1.step, LGA-14-2.5x3.step]
2018-04-22 Added JST-GH 2-8 pin
2018-04-22 Updated JST-GH pin numbering
2018-04-22 Added dronecode and kfly connectors
2018-04-22 Added DFN-8 and BMI160 IMU
    [DFN-8-2x3mm.step]
2018-04-22 Added BMP388
    [BMP388.step]
2018-04-22 Added RPi UART header
2018-04-23 Fixed power pins on multiple chips
2018-04-23 More pin fixing, added missing datasheet for esd chip
2018-04-23 Moved LQFP to its own lib + fixed footprint + 3Dmodels
2018-04-23 Updated Pixhawk switch
2018-04-23 Updated connectors with conflicting output modes
2018-04-23 Added 2.0x1.6mm crystal
2018-04-24 Updated 2x1.6mm crystal
2018-05-11 Added pushbutton
    [430481025816_button.stp]
2018-05-19 Added small passives, 0805 capacitor, fixed up some old footprints
2018-05-25 Changes to pushbuttons and connectors
2018-05-25 own switch symbol lib, because we want to be able to address the mechanical connections
2018-05-25 added raspizero step
    [RaspberryPiZeroW.STEP]
2018-05-29 Added DWM1001 footprint and 3d model
    [Laird-BMI-S-101.STEP, dwm1001.step]
2018-06-08 added tag-connect, added some mosfets
    [SC70-6.step]
2018-07-10 Updated wb001 antenna
    [TAG_DecaWave_WB001_btm_layer.dxf, TAG_DecaWave_WB001_top_layer.dxf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]
2018-07-17 smd component
    [wb001.kicad_pcb]
2018-07-17 Fixed connections on antenna
    [wb001-B.Cu.gbl, wb001-B.Mask.gbs, wb001-B.Paste.gbp, wb001-B.SilkS.gbo, wb001-Edge.Cuts.gm1, wb001-F.Cu.gtl, wb001-F.Fab.gbr, wb001-F.Mask.gts]
2018-08-20 updated usb connector pretty file
2018-08-20 updated usb connector pretty file again
2018-09-09 Added KISS ESC 24A
    [kiss_esc_24a.step]
2019-01-03 Added USB-C plug
    [1054440001.stp]
2019-01-03 Fixed 0.05mm offset error of hole
2019-01-08 Added 2.54mm header without silk
2019-01-08 Added inductor footprint
    [ASPI-0630LR.STEP]
2019-01-08 Added cut-out version of inductor
2019-01-15 Updated USB-C connector for better mounting
2019-02-01 Added DART-6UL module
    [DF40C-90DS.stp]
2019-02-15 Added ethernet transformer
    [749013011A.stp]
2019-02-15 Added stuff
    [ARJ-199.stp, Ag9900.step, Ag9900LP.step]
2019-02-17 Added 3D model for ethernet connector
    [0826-1X1T-GJ-F.step]
2019-03-23 Added AR0135CS camera footprint
    [ar0135cs.step]
2019-03-24 Added 0.7mm solder jumper
2019-03-30 Added cameras and lens holders
    [lensholder_22mm.step, m12_lens_holder_20x20mm.step]
2019-03-31 Added 5051102291 22-pin FFC/FPC
    [5051102291.step, m12_lens_holder_20x20mm.step]
2019-04-06 More SOT footprints
2019-04-06 Fixed up the micro USB connector
2019-04-06 Fixed SOT 563 footprint
2019-04-19 Added some Xilinx FPGA footprints
2019-05-09 Removed usb from solder jumpers, outlined jumper
2019-05-10 Virtual footprints on pads, added some roundness and updated 3d paths
2019-05-10 updated some footprints with pads
2019-05-10 updated footprint name in schematic
2019-05-13 Added FLIR Boson
    [DF40HC(4.0)-80DS.step]
2019-05-13 Added 1206 size Capacitor
2019-06-14 Added SOICbite connector
2019-06-27 Added nordic nrf52811 symbol and footprint
2019-06-30 Stuff for KVision
    [gsb343k33hr.stp, ssfv16r_1stlf.stp]
2019-07-06 New 3D models
    [BGA96_8x14mm.step, XDFN16.step, ssfv16r_1stlf.stp]
2019-07-07 Updated DCDC BGA footprint
2019-07-10 Added more connectors and UDFN-4
2019-07-10 Updated DW1000 footprint
2019-07-11 Artix-7 100T package with pad-to-die lengths added
2019-07-30 Added AR0135CS, SSFV30R
    [ssfv30r_3stlf.stp]
2019-07-31 Added SFV12R, 4-ch ESD filter
    [ssfv12r_3stlf.stp]
2019-08-01 Fixed courtyard on lens holders
2019-08-05 Fixed LH
    [m12_lens_holder_20x20mm.step]
2019-08-09 Added QFN-48 with 0.4mm pitch, added QFN version of nRF52832
2019-08-10 Added 2x2.5mm crystal
2019-08-12 New ESD filters
2019-08-26 Fixed DART connector and ethernet connector FFab layers
2019-09-30 Added WFM2000 footprint start
2019-10-01 Added a footprint for wfm2000
2020-01-09 Added buzzers, more leds
    [CUI_DEVICES_CMT-7525-80-SMT-TR.step]
2020-01-09 Fixed pin types
2020-01-10 More connectors, fixed SOT 665 footprint
2020-01-14 Added 3D model for PTS810 button
    [PTS810.STEP]
2020-02-11 Added 54601-908 RJ45
    [s54601-908wplf.stp]
2020-02-19 Added circuits for PoE+
2020-02-19 Pad number fixes to fit footprint
2020-02-27 Added more footprints
2020-02-27 Added UWB antennas
2020-03-15 Added STLINK-V3MODS
    [STLINK-V3MODS.step]
2020-03-27 Added large OKW box
    [okw_large_bottom.step, okw_large_top.step]
2020-03-31 USB-C receptacle, 1.6x1.2mm crystal
    [USB4105.step]
2020-04-14 More OKW cases
    [00012066 - top.step, 0001206A - bottom.step]
2020-04-16 More vibrators
    [C1234B016F.step]
2020-04-17 0606 4pin LED
2020-04-20 Added PTS526 button 3D model
    [PTS526SPG15SMTR2LFS.stp]
2020-04-20 Added PTS526 button
2020-04-23 Added 3D model for LED
    [155124M173200.step]
2020-04-24 Ferrite 3D model
    [ferrite_sheet_35x15mm.step]
2020-05-14 Fixed footprints
2020-05-15 box made virtual, vibrator got better silkscreen
2020-05-29 Added courtyard to 0.6mm pad
2020-06-30 New pushbutton
    [Panasonic - EVQQ2.step]
2020-07-03 Fixed SMD setting, was through hole
2020-07-03 Added M12 (A/X) connectors
2020-07-08 Added USB hub and more pin headers
2020-07-09 Fixed inverted pin numbers
2020-07-19 Added FTSH-107-01-L-DV-K
    [FTSH-107-01-L-DV-K-TR.stp]
2020-09-04 Updated 2x1.6 mm crystal pads
2020-09-17 Added M12 a-coded 3d model
    [m12_a-coded_86_2531_1100_00008.stp]
2020-11-22 Added DFN-10 1x2.5mm
2021-06-24 Acc and LED
2021-07-14 Make box footprint virtual
2021-10-25 More footprints
2021-11-02 Optimizing footprints for size
2021-12-17 Added accelerometer
2021-12-27 Move symbols to KiCAD 6
2021-12-30 Move footprint 3D models to KiCAD v6
2022-01-24 Updated 2.5x2mm crystal footprint
2022-03-10 Add FTSH-105-01-L-DV-K
    [FTSH-105-01-L-DV-K.stp]
2022-04-22 More connectors and stuff
    [634108150321.step]
2022-04-26 Models and box
    [CS90N-B-bot.stp, CS90N-B-top.stp, CUI_DEVICES_SJ-3523-SMT-TR.step]
2022-04-29 More ethernet connectors
2022-05-02 Added 750317234
    [750317234.step]
2022-05-04 Added CS75
    [CS75Ntop.step]
2022-05-05 Added antenna, updated courtyard on 0201
    [UWCCP.01_Web.STEP]
2022-05-06 Add SMA
    [SMA_female_edge_6.5x6.5.step]
2022-05-06 Added 2pin JST-SH
    [JST_SM02B-SRSS-TB.step]
2022-06-28 Add nRF9160
    [NRF9160-SICA-R7.step]
2022-08-08 Add another ethernet connector
    [615008144221.step]
2022-08-21 Update ethernet connector
2022-08-22 Add more
    [bmi-s-102.step]
2022-08-31 More connectors and DCDCs
    [12401880.stp, 2171760001.stp, CUI_DEVICES_SJ-3541AS-SMT-TR-67.step, CUI_DEVICES_SJ-43615TS-SMT-TR.step]
2022-08-31 Button 3D model
    [CUI_DEVICES_TS04-66-85-BK-260-SMT.step]
2022-08-31 Added TS04 button
2022-09-06 Add gasket to jack
    [CUI_DEVICES_SJ-3541AS-SMT-TR-67.step]
2022-09-08 UWB antenna
2022-09-12 Fix 3D model for USB connector
    [2171760001.stp]
2022-09-13 More antennas
    [UWC.20_Web.STEP]
2022-09-26 Updated 0402 diode and added lipo charger
2022-09-28 Fix RF switch symbol (connect N/C to GND), better pads/paste for RF amp
2022-10-07 Update balun footprint
2022-12-06 Add WiFi6 Bandpass filter
    [6530BP44A1190_JOT.step]
2022-12-07 EVQ button
    [EVQ-P2-0246-02W+P9-HP-02W.STEP]
2023-01-29 Fix antenna
2023-02-22 uBLOX SARA R42x added
    [u-blox SARA-R4.stp]
2023-02-26 Moved from rusty-tracker
    [MM8130-2600.step, P822601.step, SKY65943-11.step, m10-gps.step]
2023-02-27 Update DFN1006
    [DFN1006-2.stp]
2023-03-02 Fix feed and ground on P82260x
2023-03-22 More models, andded buzzer and vibrator
    [AST0927MW.step, VC1034B018F.step, ltst-c19he1wt.stp, sot-723.step]
2023-03-22 FFC connector
    [c-1734839-5-c-3d.stp]
2023-08-06 Added nRF52833 and Kailh MX hotswap connector
    [Kailh Hotswap MX v22.step, cherry-mx.step]
2023-08-12 Add Kailh Choc buttons
    [Kailh Choc Low Profile Switch.step, PG1350-socket.STEP]
2023-08-13 Fix switches, line up pick and place for USB4105
2023-08-13 Add memory pixel displays
    [LS011B7DH03.step, LS011B7DH03_bend.step]
2023-08-20 Add slide switch
    [SSSS810701.STEP]
2023-08-23 Add bigger side connector
2023-09-02 Add XDFN4
    [XDFN4.step]
2023-09-09 More ethernet connectors, chokes, transformers
    [M-MRJR-548X-0F-REVT2.STEP, RCP-5SPFFC-SCU7001-STP.stp, SM453229-381N7Y.stp, SRF2012A-801Y.stp]
2023-09-14 Fix footprint from std lib
2023-09-17 Add 3d model for spring loaded contact
    [Z003 H3.3.stp]
2023-12-14 TPS DCDC + AVX spring loaded terminal block
    [AVX-00-9276-003-021-906.STEP]
2023-12-17 SRF0703 and new DCDC
    [SRF0703.step]
2024-01-06 Add diode bridge
    [CD-HD2XL.stp]
2024-02-03 PCIe and USB 3 type b connector, fixes to symbols
    [10061913-102PLF.step, GSB422137EU.step]
2024-02-15 Added PT61020L 3D model
    [PT61020L.stp]
2024-02-20 Add ESD diode
2024-02-21 Add ethernet ESD filter
    [ESD8708MUTAG.stp]
2024-03-13 Add microwave connector
2024-03-14 Add 3D models
    [BM03B-ACHSS-GAN-TF.step, mill-max-0908-8-15-20-75-14-11-0.step]
2024-03-19 Added NFC antenna symbol
2024-03-19 improve NFC antenna
2024-03-20 Add AoA antenna
2024-03-20 Add Omni antenna
2024-03-24 Fix SOT, add DCDC
    [SOT-523.step, SOT-723.step, sot-723.step]
2024-03-25 Fuel gauge and solder jumper
2024-03-31 Fix RF components zone props and 3D models
2024-05-02 Add UWB antenna
2024-05-03 Add crystal with thermistor
2024-05-06 Add SPE related pads and transformer
    [WE-STST-74930000.stp]
