korken89/kicad_libs/(notices)

Notices in the files:
3dmodels/step/FTSH-105-01-L-DV-K.stp:
FILE_NAME( 'e:/temp/worker_46/temp/exporttempdir_9788_843_1xHBK/format_0/FTSH-105-01-L-DV-K.stp', '2022-03-08T20:17:13', ( 'License CC BY-ND 4.0' ), ( 'CADENAS' ), ' ', 'PARTsolutions', ' ' );
3dmodels/step/SIM8051-6-0-14-00-A.stp:
author */ ('License CC BY-ND 4.0'),
